ppatlux/customizer-as-website/assets/models/special/Otto5/1677061-otto-5-tpuflex-track-and-belt-8fd95c79-441a-4261-949b-67ce57e5056e.pdf

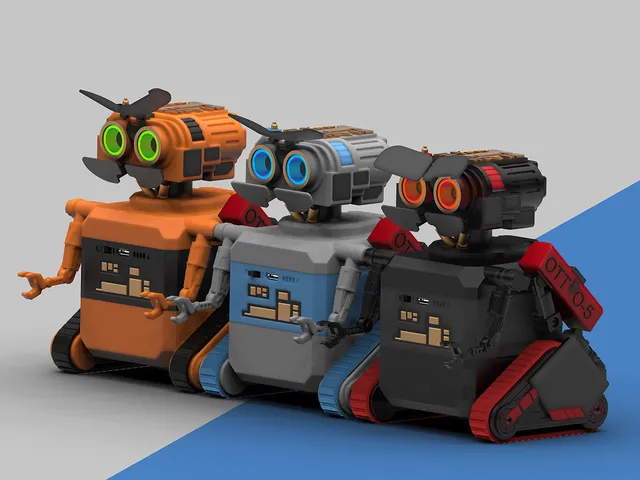
[picture p6: figure]

0.93 hrs

1 pcs

f

0.20 mm

k

0.40 mm

h

Flex

9 g

d

Prusa CORE
One / +

## Summary

TPU/Flex track and belt as an alternative for the current o-ring design.

Hobby & Makers (https://printables.com/model?categoryId=48) > RC & Robotics (https://printables.com/model?categoryId=64)

Tags: | otto | ottodiy | ottorobot | robot | robotics

OTTO-5 TPU / Flexible Track and belt

I received a request for an alternative to the o-ring design, so here’s a TPU/flexible track and belt designed for the OTTO-5. This track is compatible with the standard OTTO-5 wheels and mounting hardware, and it uses the same parts as the original o-rings.

I would have updated the current design, but that doesn’t seem possible. Likely because it’s part of a closed contest. The OTTO-5 design will be updated as soon as possible.

Since I don’t have the capability to print TPU/Flex materials myself, this design has not been tested. Minor adjustments may be required

AK_designs (https://printables.com/@AK_designs_4494554)

## OTTO-5 TPU/Flex track and belt

VIEW IN BROWSER (https://printables.com/model/1677061-otto-5-tpuflex-track-and-belt)

updated 10. 4. 2026 | published 10. 4. 2026

## Model files

depending on your printer and the specific TPU or flexible filament you use.

The track is designed with approximately 3.8% elongation to ensure it stays in place. However, because it hasn’t been tested and I have limited experience with flexible 3D printing materials, I cannot guarantee that this is optimal. Please feel free to comment if the track should be tighter or looser for best performance.

Recommended print settings (general guideline for TPU/flex):

Nozzle temperature: 210–230 °C
Bed temperature: 50–60 °C
Print speed: 20–30 mm/s
Layer height: 0.2 mm
Infill: 20–30% (gyroid)

Installation tip: Stretch the track slightly during installation to fit snugly on the wheels.

Link to the OTTO-5 model:

Thank You / Enjoy Printing!

•
•
•
•
•

bot_track_tpu.3mf

top_head_pully_tpu_belt.3mf

bot_track_tpu.stl

top_head_pully_tpu_belt.stl

## Print files

h Flex k 0.40 mm f 0.20 mm 0.93 hrs 9 g d Prusa CORE One / +

- Example gcode for reference

## License

This work is licensed under a
Creative Commons (4.0 International License)

Attribution—Noncommercial—Share Alike (http://creativecommons.org/licenses/by-nc-sa/4.0/)

✖ | Sharing without ATTRIBUTION
✔ | Remix Culture allowed
✖ | Commercial Use
✖ | Free Cultural Works
✖ | Meets Open Definition

bot_track_tpu_flex_example_coreone.bgcode
