ppatlux/customizer-as-website/assets/models/special/OttoButter/1662333-otto-pass-the-butter-robot-04062c3c-220f-47a0-8fba-3715a1c23a67.pdf

## Otto Pass the Butter Robot

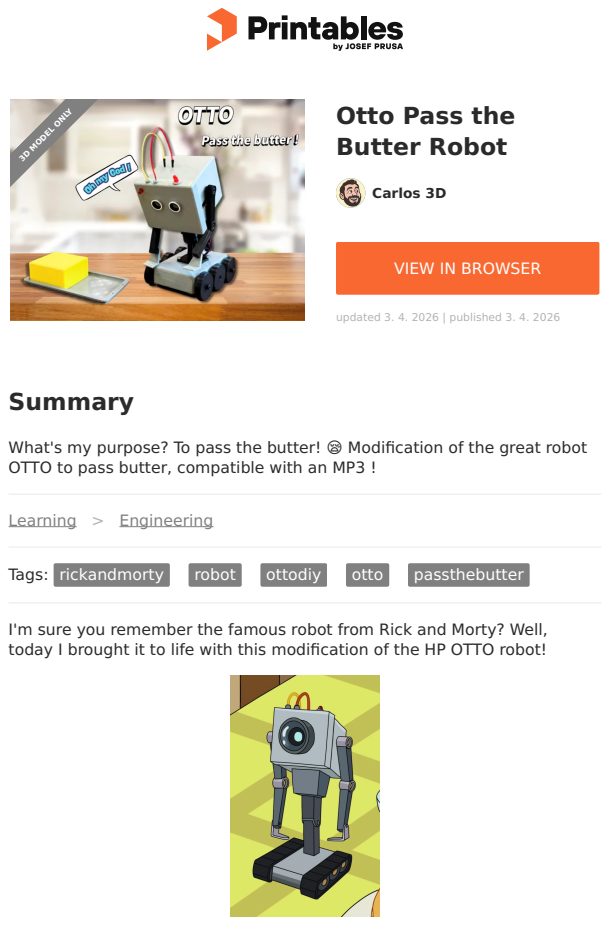
[picture p7: page 1]
Summary; Learning > Engineering; Tags:; rickandmorty; robot; ottodiy; otto; passthebutter; Carlos 3D; updated 3. 4. 2026 | published 3. 4. 2026; 3D MODEL ONLY

VIEW IN BROWSER (https://printables.com/model/1662333-otto-pass-the-butter-robot)

What's my purpose? To pass the butter! 😪 Modification of the great robot
OTTO to pass butter, compatible with an MP3 !

I'm sure you remember the famous robot from Rick and Morty? Well,
today I brought it to life with this modification of the HP OTTO robot!

## Model files

It's easy to assemble, and I've included the code so you can build it yourself, I'm sure you can do a much better job 😅

This is an excellent starting point for further modifications, so I've also included the STEP file!

Have fun with this mod!

Watch the Video
https://www.instagram.com/p/DWpK_EwDpc0/

Necessary Hardware

M3 Hex Screws (some 5 and 8mm long)
M4 Hex Screws (8, 10 and 12mm should work)
4x M4 Brake nuts (to block the wheels)
The rest comes already with the OTTO kit !
Ahh and maybe some wires or PLA to simulate the Robot cables

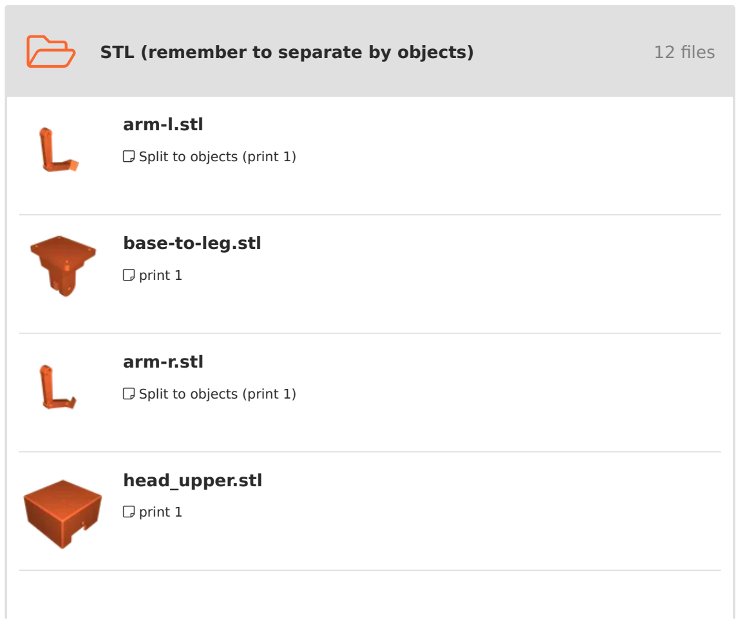
[picture p8: figure]
Split to objects (print 1); print 1; arm-l.stl; base-to-leg.stl; arm-r.stl; head_upper.stl

- STL (remember to separate by objects) | 12 files

•
•
•
•
•

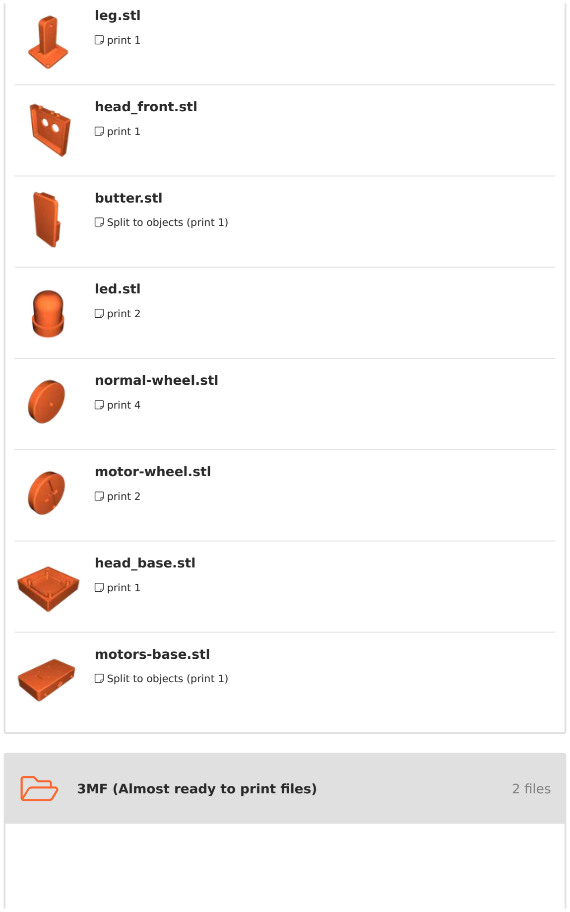
[picture p9: figure]
print 1; Split to objects (print 1); print 2; print 4; leg.stl; head_front.stl; butter.stl; led.stl; normal-wheel.stl; motor-wheel.stl; head_base.stl; motors-base.stl

- 3MF (Almost ready to print files) | 2 files

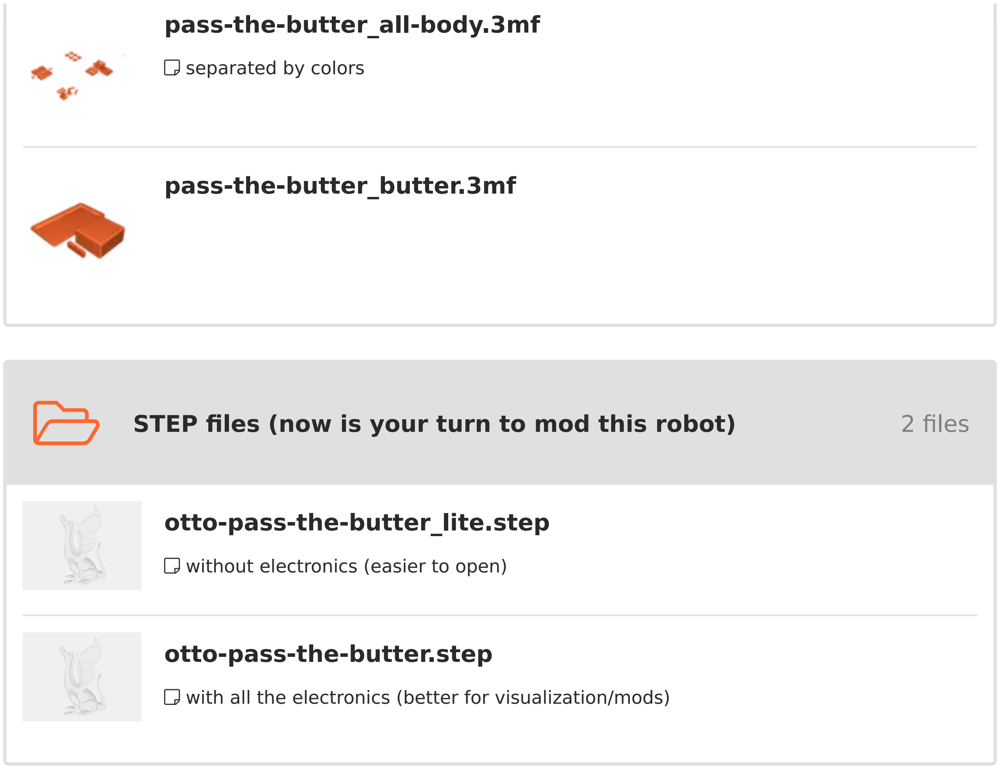
[picture p10: figure]
separated by colors; without electronics (easier to open); pass-the-butter_all-body.3mf; pass-the-butter_butter.3mf; otto-pass-the-butter_lite.step; otto-pass-the-butter.step

- STEP files (now is your turn to mod this robot) | 2 files
- with all the electronics (better for visualization/mods)

## License

This work is licensed under a
Creative Commons (4.0 International License)

Attribution—Noncommercial—Share Alike (http://creativecommons.org/licenses/by-nc-sa/4.0/)

✖ | Sharing without ATTRIBUTION
✔ | Remix Culture allowed
✖ | Commercial Use
✖ | Free Cultural Works
✖ | Meets Open Definition
