ppatlux/customizer-as-website/assets/models/special/OttoBuzz/1617566-hp-otto-otto-bus-30bd9cd0-71e3-439a-a64b-bc296953116d.pdf

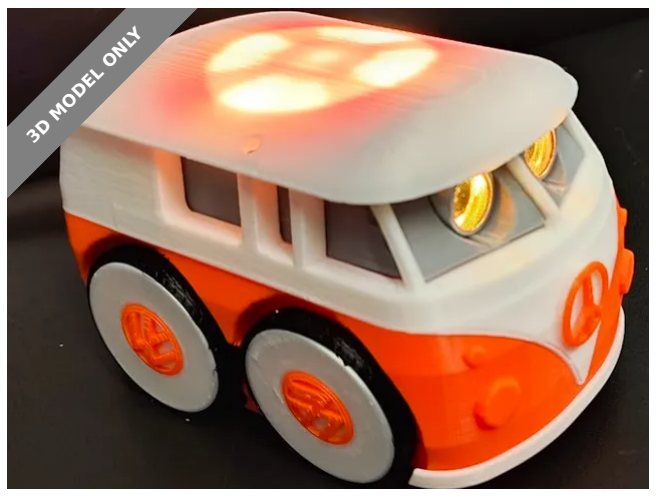
[picture p11: figure]
3D MODEL ONLY

## Summary

A new VW Splitscreen Bus body for HP Otto

Hobby & Makers (https://printables.com/model?categoryId=48) > RC & Robotics (https://printables.com/model?categoryId=64)

HP Otto: Otto Bus

Otto Bus uses all the components found in the HP Robots | Otto Starter -
Creator Kit (https://shop.moravia.education/educational-and-interactive-robots/hp-robots/hp-robots-otto-creator-kit.html) to build a complete Otto-based robot. It can also be used as an
alternative body for the HP Robots | Otto Starter Santa Edition (https://shop.moravia.education/educational-and-interactive-robots/hp-robots/hp-robots-otto-starter-santa-edice.html) and the HP
Robots | Otto Starter - Builder Kit. (https://shop.moravia.education/educational-and-interactive-robots/hp-robots/otto-starter-builder-kit.html)

Printing

PLA, 15% infil. This model can be printed without supports but there are a few places on the 'upper body' where supports will improve the final result. I used 1mm diameter painted on 'organic' supports in the areas indicated (blue spots).

Alex Just Alex (https://printables.com/@AlexJustAlex_476452)

## HP Otto: Otto Bus

VIEW IN BROWSER (https://printables.com/model/1617566-hp-otto-otto-bus)

updated 11. 3. 2026 | published 11. 3. 2026

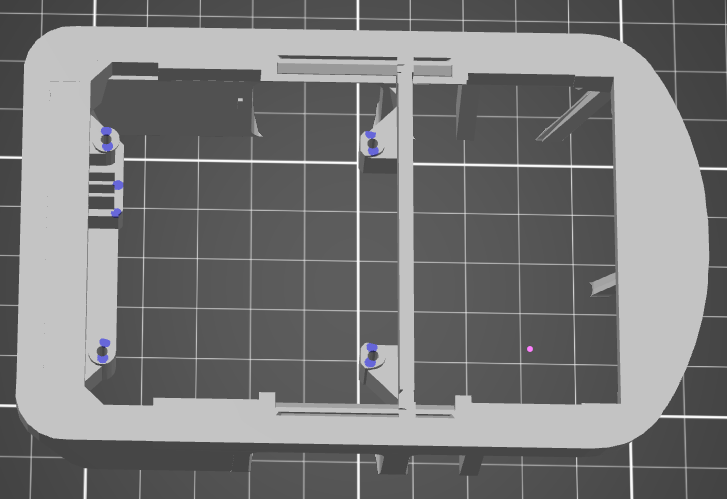
[picture p12: figure]

Tyres are printed with TPU or, alternatively, ~40mm id O-rings can be used.

Assmbly

Note: Most of the assembly is very similar to the assembly detailed in the manual supplied with the starter kit and this manual should be referred to when assembling the Otto Bus

Mount the line sensors in the base and secure with self tapping screws.

1.

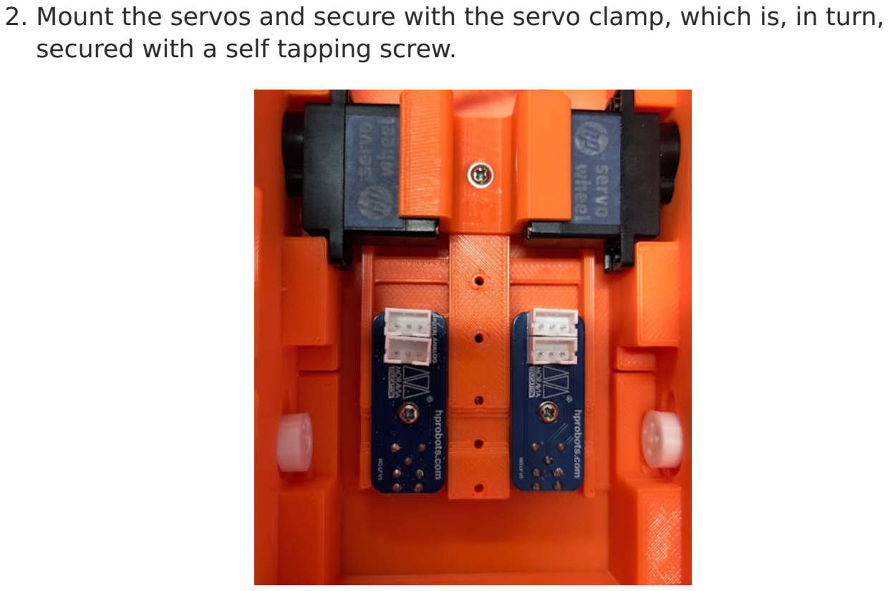
[picture p13: page 3]

Mount the servos and secure with the servo clamp, which is, in turn, secured with a self tapping screw.

2.

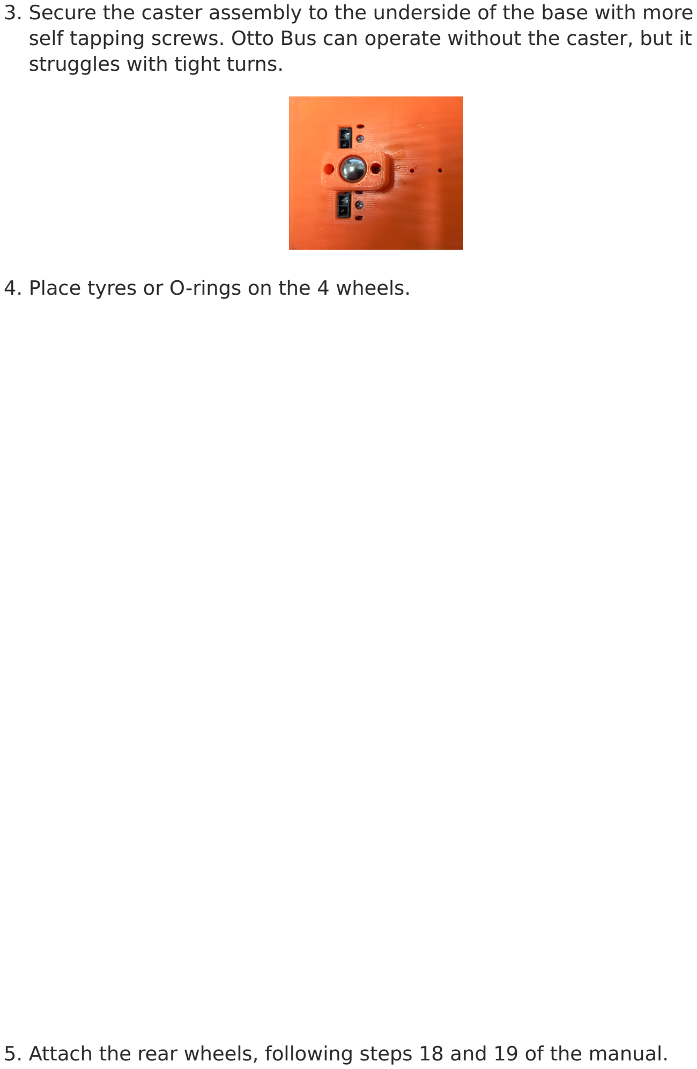
[picture p14: page 4]

Secure the caster assembly to the underside of the base with more self tapping screws. Otto Bus can operate without the caster, but it struggles with tight turns.

Place tyres or O-rings on the 4 wheels.

Attach the rear wheels, following steps 18 and 19 of the manual.

3.

4.

5.

For the front wheels, pass the hub through the base, slip on the washer and then push fit the front wheel on to the hub. Secure this with a small self tapping screw such as the ones supplied with servo horns.

6.

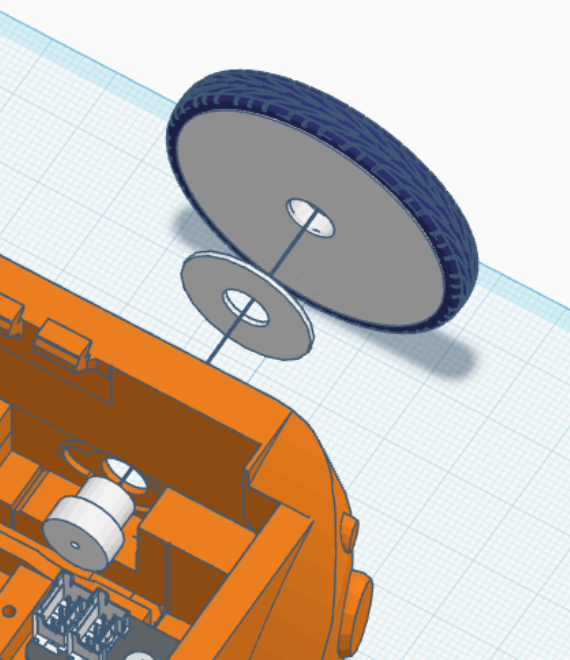
[picture p15: figure]

Assemble the 'inner module' following steps 8 to 10 of the HP Robots starter manual and secure the module inside the upper body section

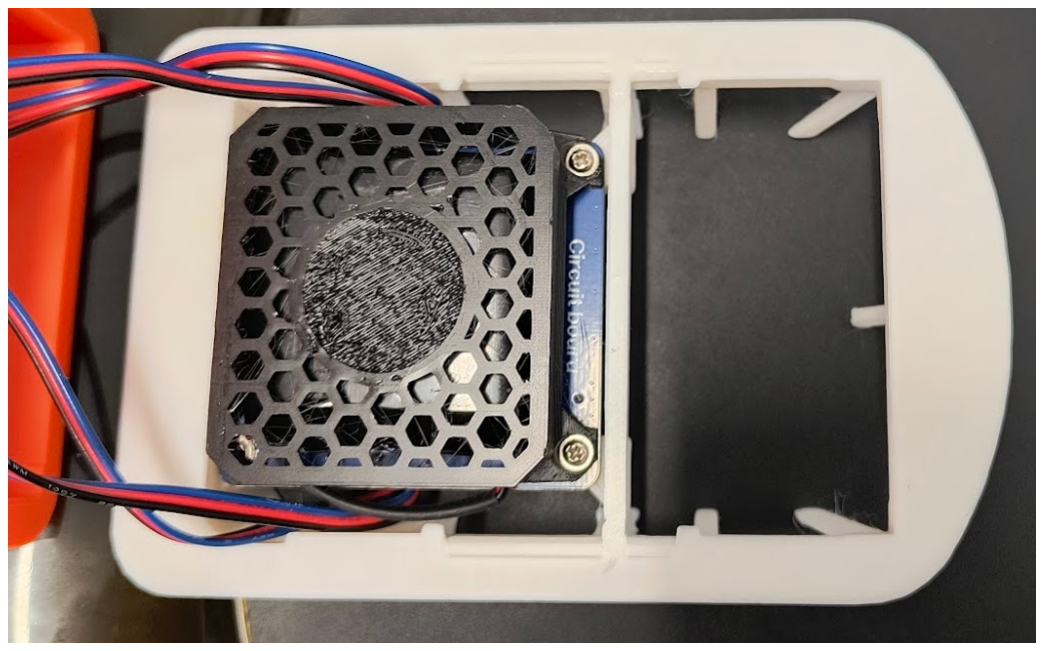
[picture p16: figure]

The base and upper body can now be combined, by clipping them together. First place the front piece in position on the base and then clip on the upper section which secures the front piece in place.
Make sure to feed all the wires from the base up the sides of the upper body section so that they can be attached to the control board.

7.

8.

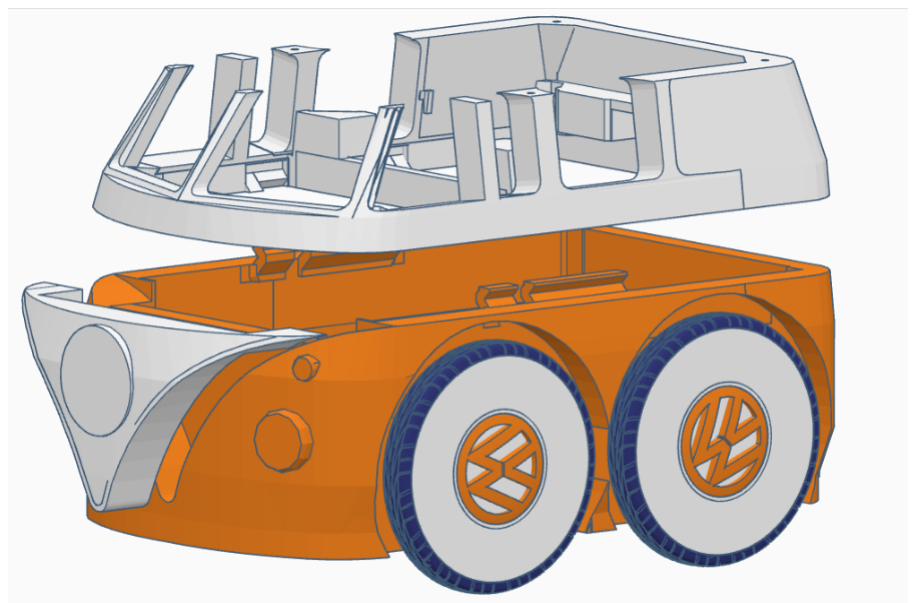
[picture p17: figure]
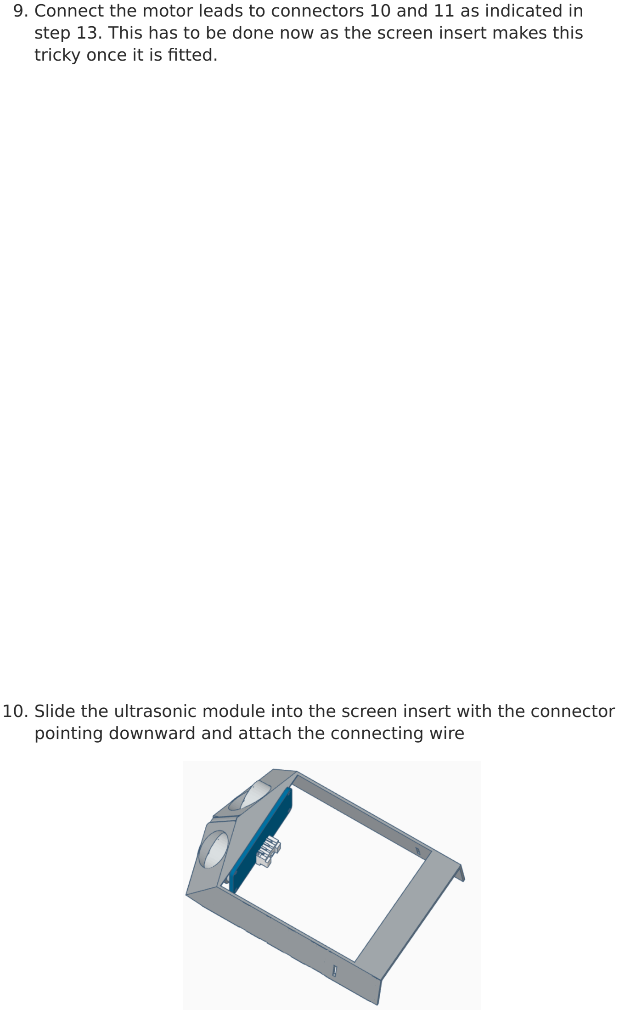
[picture p18: page 7]

Connect the motor leads to connectors 10 and 11 as indicated in
step 13. This has to be done now as the screen insert makes this tricky once it is fitted.

Slide the ultrasonic module into the screen insert with the connector pointing downward and attach the connecting wire

9.

10.

Position the insert inside the upper body section, you will need to squeeze the sides together to do this.

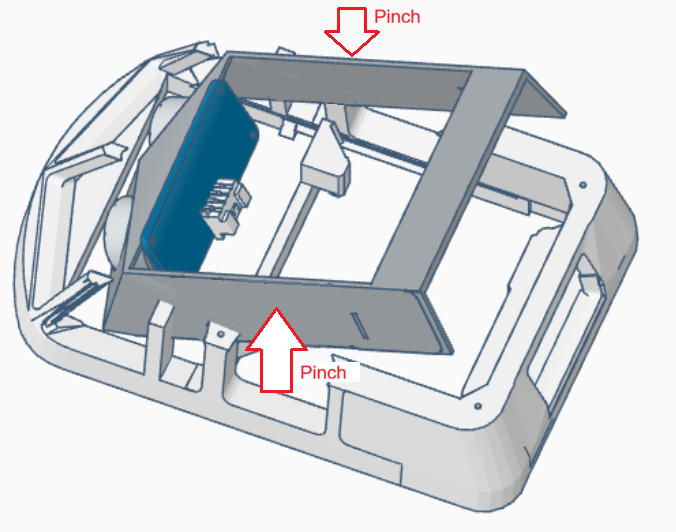
[picture p19: figure]

Mount the LED ring on the roof with the connecto to the front using 4 self tapping screws.

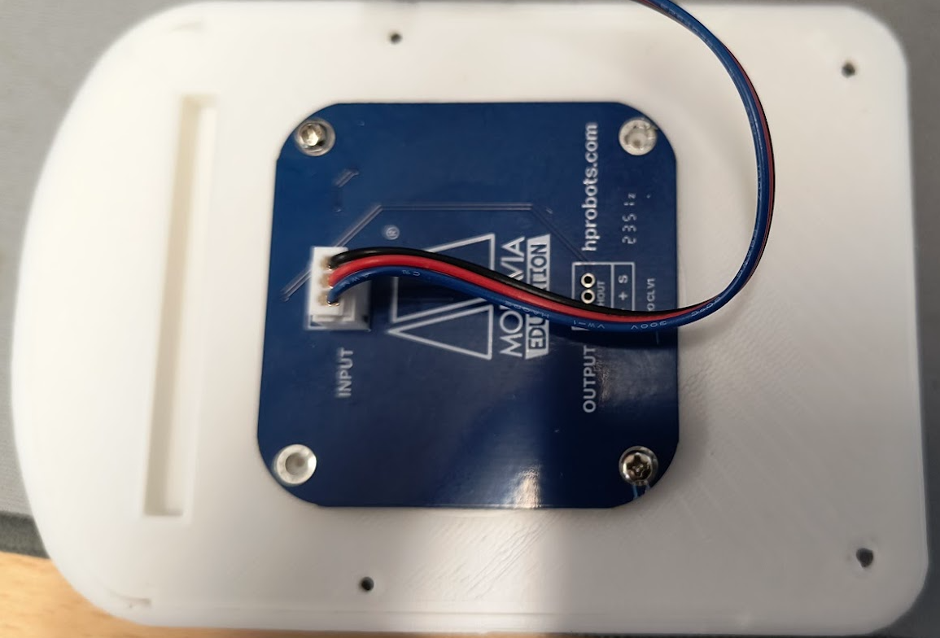
[picture p20: figure]

It's now time to make the rest of the electrical connections. These can be found on page 3 of the manual.

11.

12.

13.

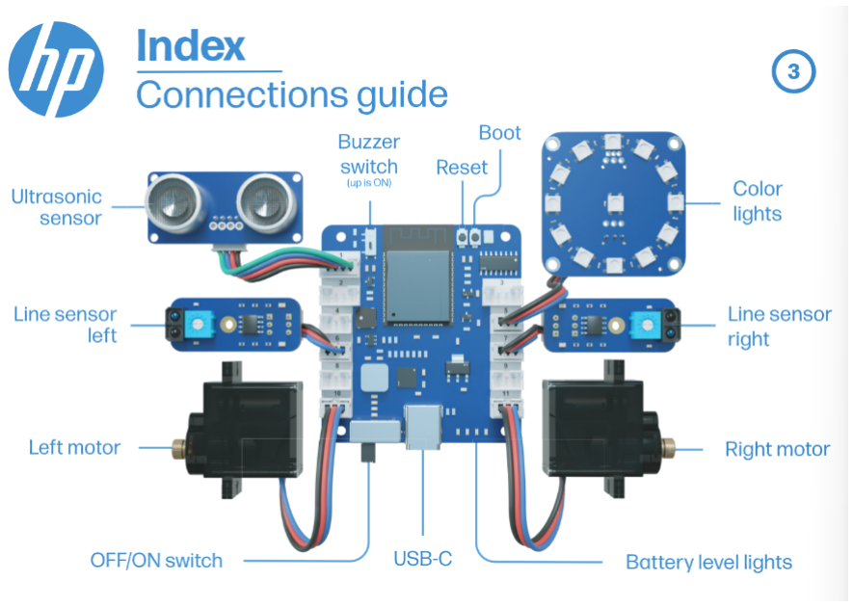
[picture p21: figure]

(image used with permission)

14. Now attach the roof with four more screws.

15. Attach the logo of your choice to the front with a drop of superglue.

The logo 'hub caps' can also be attached. Depending on your printer the logos may clip in place or may require a dab of glue. I
recommend a glue stick like Pritt for this so that they can be easily removed again if required.

16.

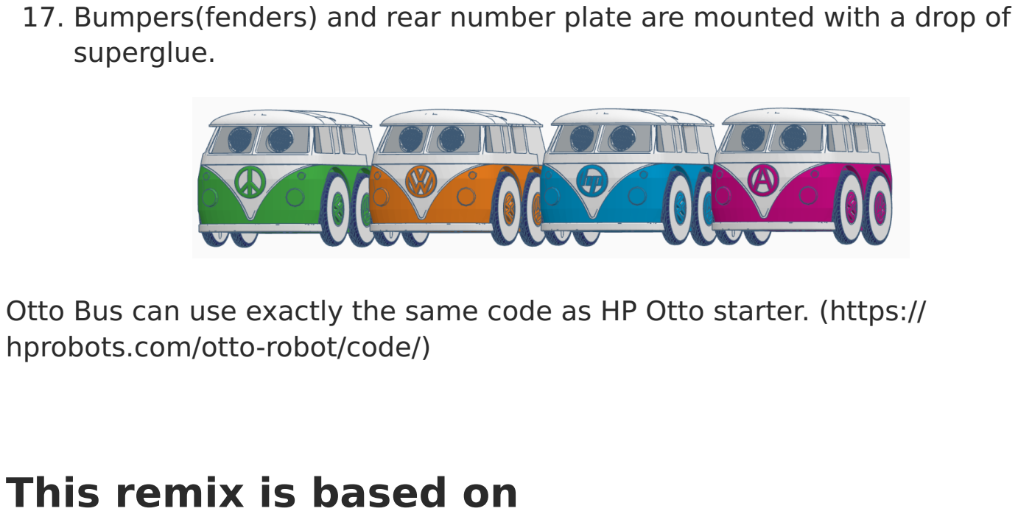
[picture p22: page 13]

Bumpers(fenders) and rear number plate are mounted with a drop of superglue.

Otto Bus can use exactly the same code as HP Otto starter. (https://hprobots.com/otto-robot/code/)

## This remix is based on

17.

## Model files

HP Robots | Otto Starter (https://printables.com/model/829419-hp-robots-otto-starter)
by HP Robots Otto (https://printables.com/@hprobots)

VW Bus Marker or Tool Holder with Working Wheels (optimized for Prusa Mini) (https://printables.com/model/404012-vw-bus-marker-or-tool-holder-with-working-wheels-o)
by Den (https://printables.com/@Den_484447)

otto-dub-base.stl

otto-dub-front.stl

otto-dub-upper-body.stl

otto-dub-screen.stl

otto-dub-roof.stl

otto-dub-rear-wheel.stl

- with cutaway to go over screwheads
- Atkinson or Anarchy

otto-dub-front-wheel.stl

otto-dub-front-wheel-hub.stl

otto-dub-front-wheel-washer.stl

otto-dub-vw-logo.stl

otto-dub-vw-hubcap.stl

otto-dub-hp-logo.stl

otto-dub-peace-logo.stl

otto-dub-aja-logo.stl

otto-dub-atkinson-logo.stl

otto-dub-front-bumper.stl

## License

This work is licensed under a
Creative Commons (4.0 International License)

Attribution—Noncommercial—Share Alike (http://creativecommons.org/licenses/by-nc-sa/4.0/)

✖ | Sharing without ATTRIBUTION
✔ | Remix Culture allowed
✖ | Commercial Use
✖ | Free Cultural Works
✖ | Meets Open Definition

otto-dub-rear-bumper.stl

otto-dub-rear-plate.stl
