ppatlux/customizer-as-website/assets/models/special/OttoD2/1595229-hp-otto-otto-d2-3d70b2a9-ba4c-4e04-8e0a-4731c8bd536c.pdf

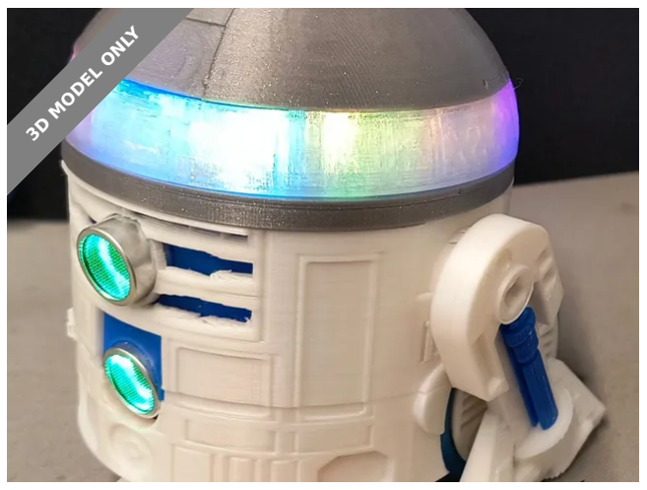
[picture p23: figure]
3D MODEL ONLY

## Summary

An R2D2 inspired body for the HP Otto Starter kit.

Hobby & Makers (https://printables.com/model?categoryId=48) > RC & Robotics (https://printables.com/model?categoryId=64)

Otto-D2

An R2D2 inspired body for the HP Otto Starter kit.

Otto-D2 uses all the components found in the HP Robots | Otto Starter -
Creator Kit (https://shop.moravia.education/educational-and-interactive-robots/hp-robots/hp-robots-otto-creator-kit.html) to build a complete Otto-based robot. It can also be used as an
alternative body for the HP Robots | Otto Starter Santa Edition (https://shop.moravia.education/educational-and-interactive-robots/hp-robots/hp-robots-otto-starter-santa-edice.html) and the HP
Robots | Otto Starter - Builder Kit. (https://shop.moravia.education/educational-and-interactive-robots/hp-robots/otto-starter-builder-kit.html)

Printing

PLA, 15% infill, no supports. The middle section of the dome is transparent PLA to allow the LEDs to shine through. I used white for the body and silver for the rest of the dome. Various blue inserts give Otto-D2 a bit more colour.

Alex Just Alex (https://printables.com/@AlexJustAlex_476452)

## HP Otto: Otto-D2

VIEW IN BROWSER (https://printables.com/model/1595229-hp-otto-otto-d2)

updated 10. 3. 2026 | published 10. 3. 2026

Assembly

Note: Most of the assembly is very similar to the assembly detailed in the manual supplied with the starter kit and this manual should be referred to when assembling Otto-D2

Mount the line sensors in the base and secure with self tapping screws.

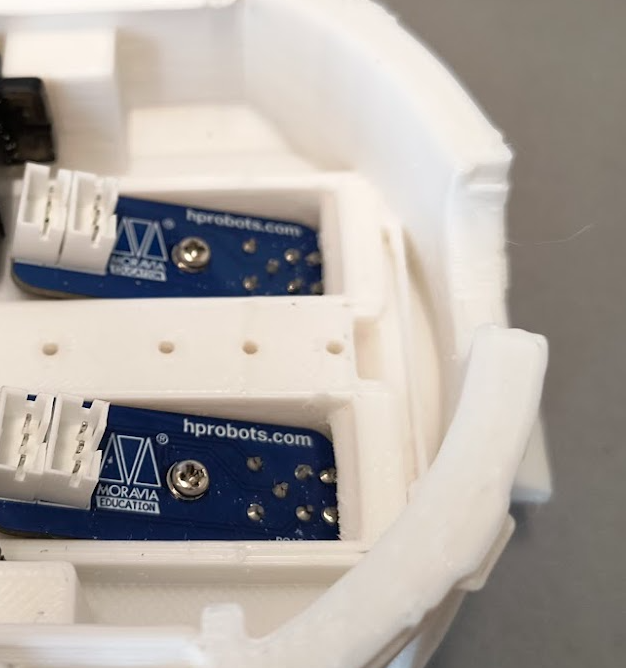
[picture p24: figure]

Mount the servos and secure with the servo clamp, which is, in turn, secured with a self tapping screw.

1.

2.

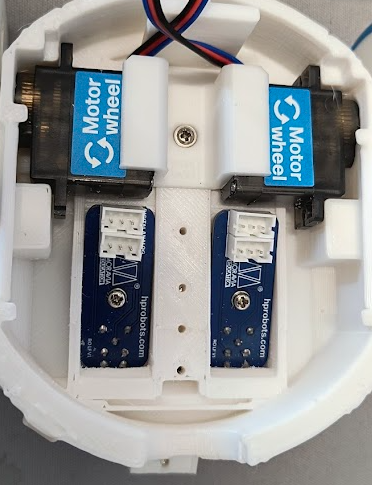
[picture p25: figure]

Secure the caster bracket and caster assembly to the underside of the base with more self tapping screws.

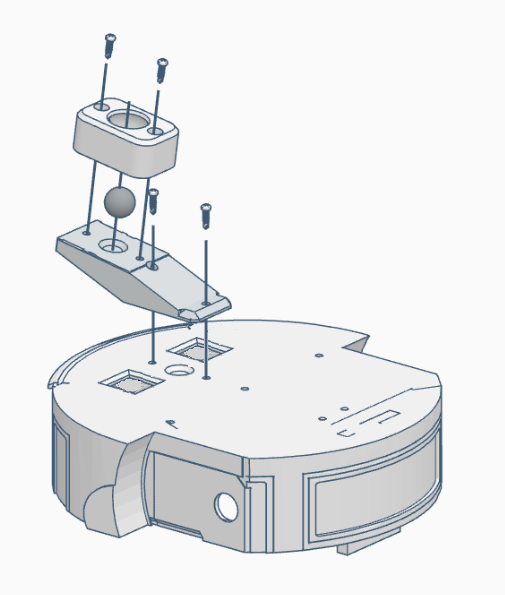
[picture p26: figure]

Slide the blue insert into the middle section.

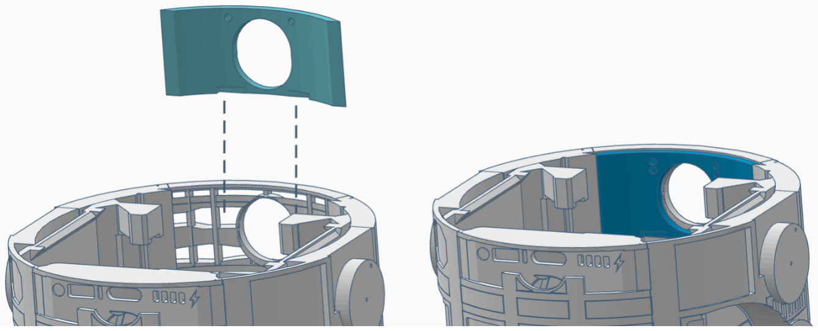
[picture p27: figure]

The print supports indicated can be optionally nipped out after printing.

3.

4.

5.

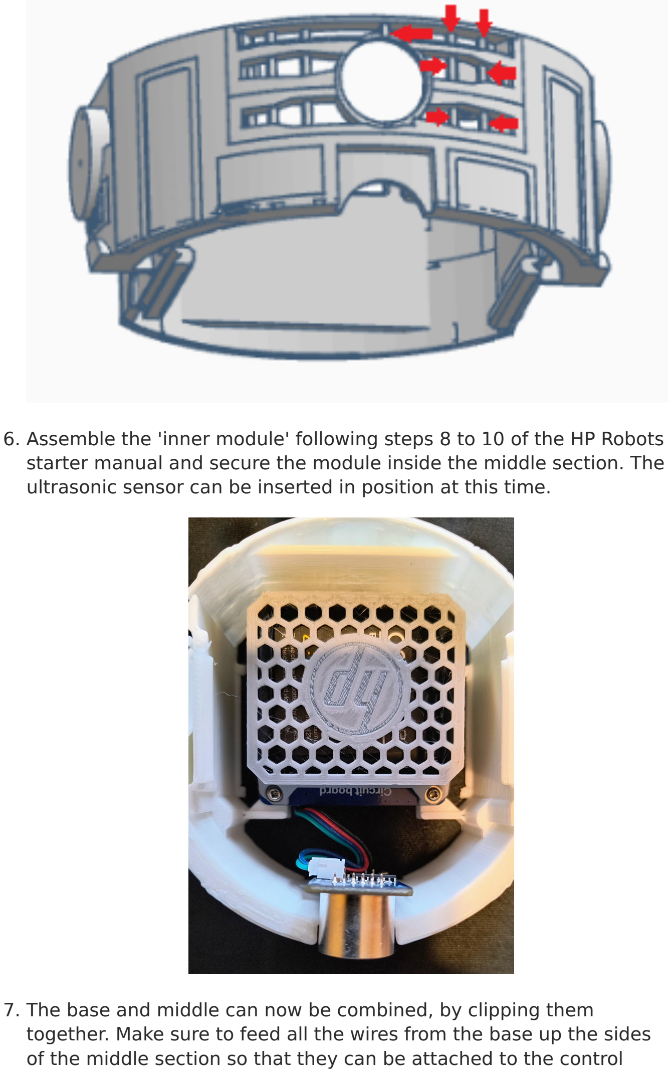
[picture p28: page 4]

Assemble the 'inner module' following steps 8 to 10 of the HP Robots starter manual and secure the module inside the middle section. The ultrasonic sensor can be inserted in position at this time.

The base and middle can now be combined, by clipping them together. Make sure to feed all the wires from the base up the sides of the middle section so that they can be attached to the control

6.

7.

board. Use the spacer to ensure that the ultrasonic sensor is positioned at the correct angle.

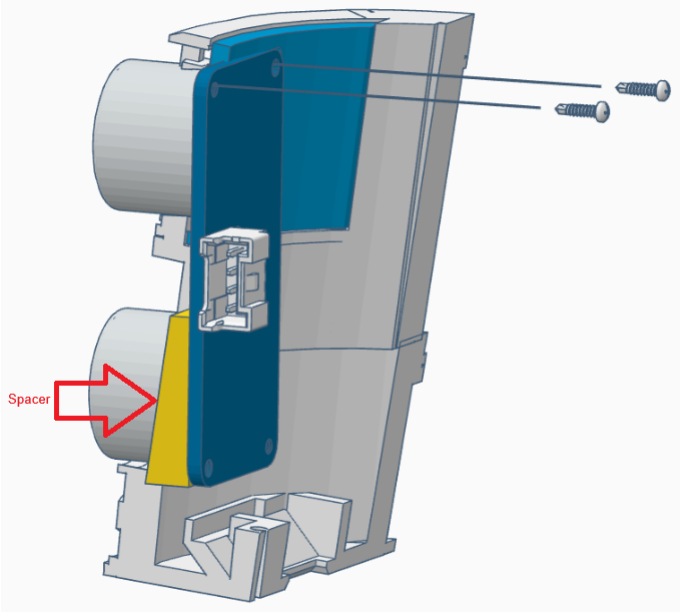
[picture p29: figure]

8. Attach the wheels, following steps 18 and 19 of the manual.

Assemble the legs by attaching the blue part with a drop of superglue.

9.

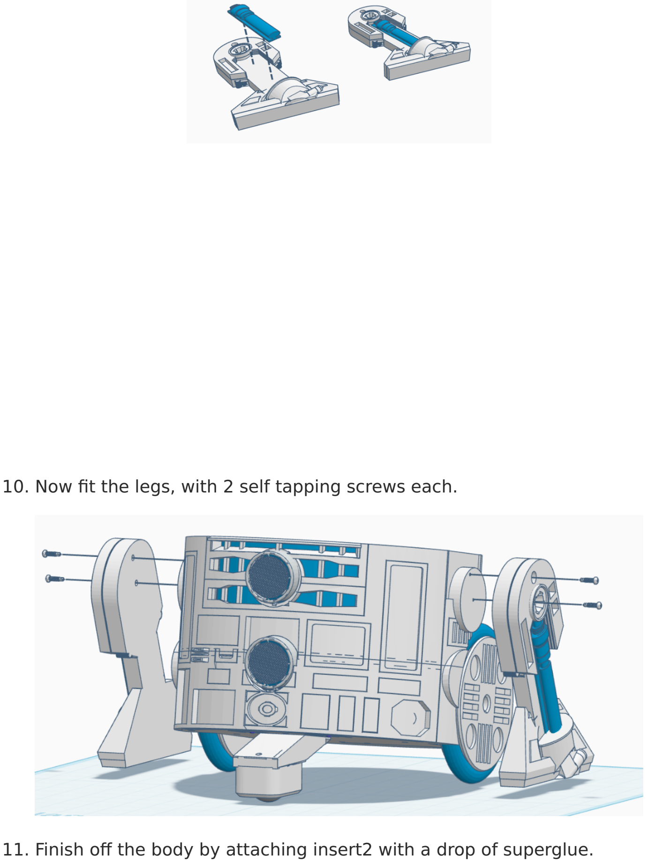
[picture p30: page 7]

Now fit the legs, with 2 self tapping screws each.

Finish off the body by attaching insert2 with a drop of superglue.

10.

11.

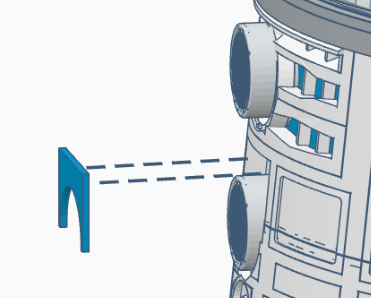
[picture p31: figure]

Now we come to assembly of the dome. This is made of 3 components which will be screwed together with, you guessed it, more self tapping screws. First the LED ring needs to be fitted. Take the dome base with the mounting clips facing down. Identify the front by looking for where the front section of the clip is cut away (see my helpful picture below). Attach the led ring on top of the dome base, with the connector facing down at the front.

12.

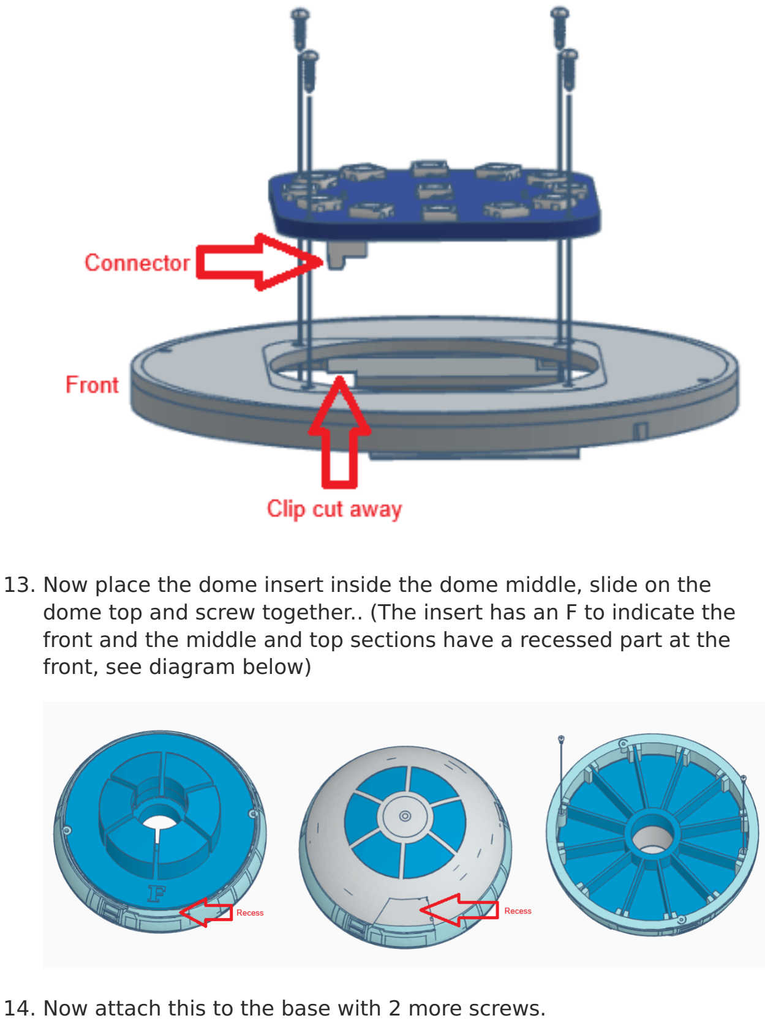
[picture p32: page 9]

Now place the dome insert inside the dome middle, slide on the dome top and screw together.. (The insert has an F to indicate the front and the middle and top sections have a recessed part at the front, see diagram below)

Now attach this to the base with 2 more screws.

13.

14.

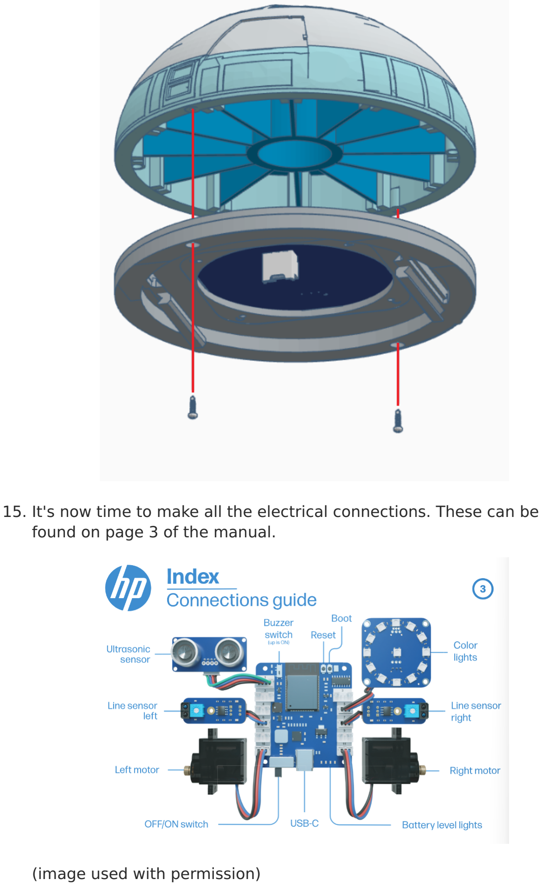
[picture p33: page 10]

It's now time to make all the electrical connections. These can be found on page 3 of the manual.

(image used with permission)

15.

16. Now clip the dome on to the body and you're done!

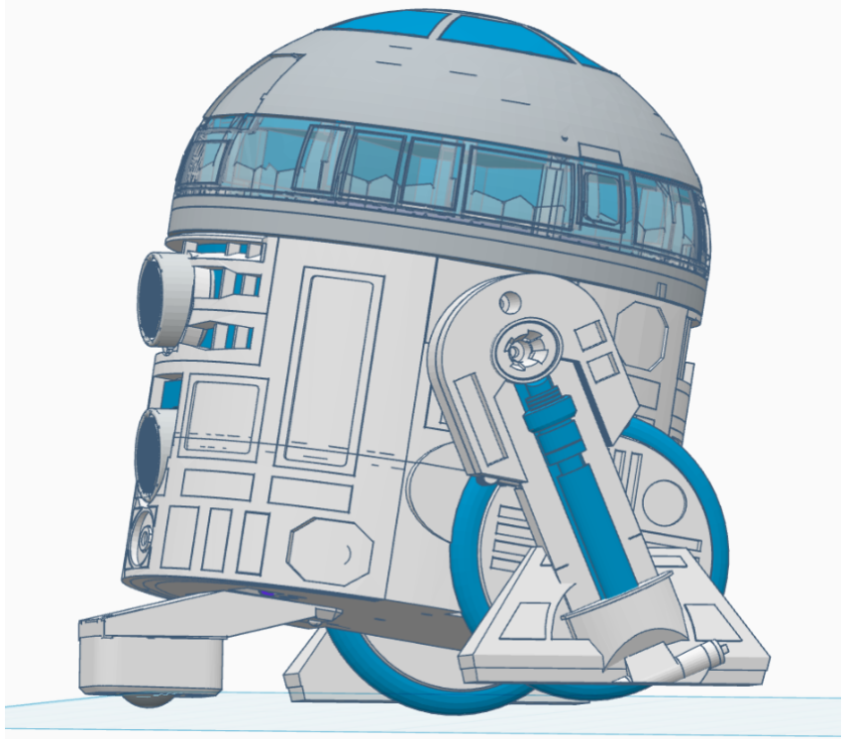
[picture p34: figure]

Otto-D2 can use exactly the same code as HP Otto starter. (https://hprobots.com/otto-robot/code/)

## This remix is based on

HP Robots | Otto Starter (https://printables.com/model/829419-hp-robots-otto-starter)
by HP Robots Otto (https://printables.com/@hprobots)

R2D2
by lubosh (https://www.thingiverse.com/thing:2139345)

## Model files

- 2 choices from HP for the caster - take your pick!
- 2 choices from HP for the caster - take your pick!
- (hp_starter_bracket_s_r1)
- Print 2

otto-d2-base.stl

otto-d2-caster-bracket.stl

hp_starter_caster_s_r1.stl

hp_santa_caster_b_r2.stl

servo-clamp.stl

otto-d2-middle.stl

otto-d2-middle-blue-insert.stl

hp_starter_covermesh_b_r1.stl

otto-d2-wheels.stl

- Print Two
- transparent

otto-d2-left-leg.stl

otto-d2-right-leg.stl

otto-d2-legs-blue-section.stl

otto-d2-ultrasonic-spacer.stl

otto-d2-middle-blue-insert-2.stl

otto-d2-dome-base.stl

otto-d2-dome-blue-insert.stl

otto-d2-dome-top.stl

otto-d2-dome-middle.stl

## License

This work is licensed under a
Creative Commons (4.0 International License)

Attribution—Noncommercial—Share Alike (http://creativecommons.org/licenses/by-nc-sa/4.0/)

✖ | Sharing without ATTRIBUTION
✔ | Remix Culture allowed
✖ | Commercial Use
✖ | Free Cultural Works
✖ | Meets Open Definition
