ppatlux/customizer-as-website/assets/models/special/OttoJr/1667283-otto-jr-a17f32dc-c0b8-4437-97b0-9b36591161a5.pdf

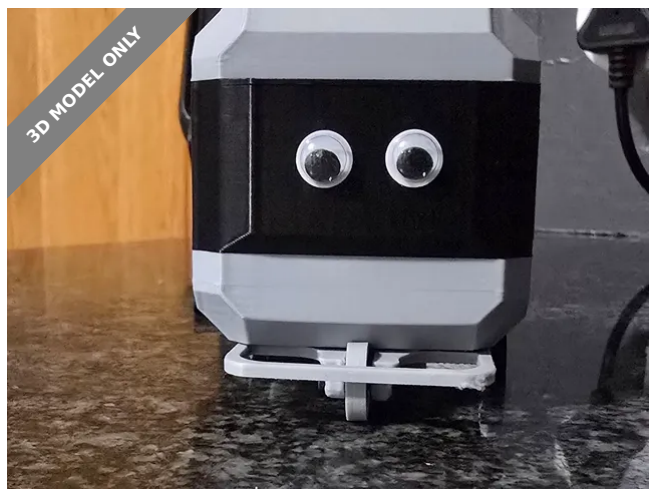
[picture p46: figure]
3D MODEL ONLY

## Summary

A micro version of Microsoft's Otto Robot. Easy to print, code and make with my guide. WIFI controllable up to 30m

Hobby & Makers (https://printables.com/model?categoryId=48) > RC & Robotics (https://printables.com/model?categoryId=64)

Tags: | robot | diy | wifi | children | kids | fun | school
gadgets | easy | electronics | controller | esp32 | robotics
remote | diyelectronics | controlled | otto | espressif | esp32c3
esp32c3supermini | micorsoft | mx1508 | microrobotics

This project uses minimal materials and was made from mainly spare materials which I have access to. It was inspired by Microsoft's Otto robot which inspired me to create my own micro-version over the past few days.

Parts List:
-ESP32 C3
-MX1508 Motor driver
-MT3608 DC -DC converter
-FR107 Diode
-1000 μF Capacitor
-LED
-20mA Resistor

Extrude Labs (https://printables.com/@ExtrudeLabs_521578)

Otto Jr.

VIEW IN BROWSER (https://printables.com/model/1667283-otto-jr)

updated 4. 4. 2026 | published 4. 4. 2026

## Model files

-Battery Connector (Male and Female) -2x 612 DC Brushed Motors (3v)
-12mm Shrink Tubing
-Enameled Wire
-2x 550mAh Lithium Batteries (I took mine out of recycled vapes) -Multipurpose lithium Ion Battery Charger (Or TP4056)

The wire diagram is slightly complicated but I will included it, alone with the most recent code that I created. The car can be controlled on the phone, or computer. Simply connect the battery, connect to the broadcasted wifi network, search "192.168.4.1" on the browser, and the controls will display. Refer to the images included. Please like, comment, and share!

wheel.3mf

3-wheel-pcb-clip.3mf

free-wheel.3mf

3-wheel-chasis.3mf

otto.3mf

## License

This work is licensed under a
Creative Commons (4.0 International License)

Attribution-ShareAlike (http://creativecommons.org/licenses/by-sa/4.0/)

✖ | Sharing without ATTRIBUTION
✔ | Remix Culture allowed
✔ | Commercial Use
✔ | Free Cultural Works
✔ | Meets Open Definition
