ppatlux/customizer-as-website/assets/models/special/OttoSwim/1628816-hp-otto-swimmer-kit-fully-compatible-with-basic-robot-model-7cfaf209-fa9b-46a7-8df8-188c11923966.pdf

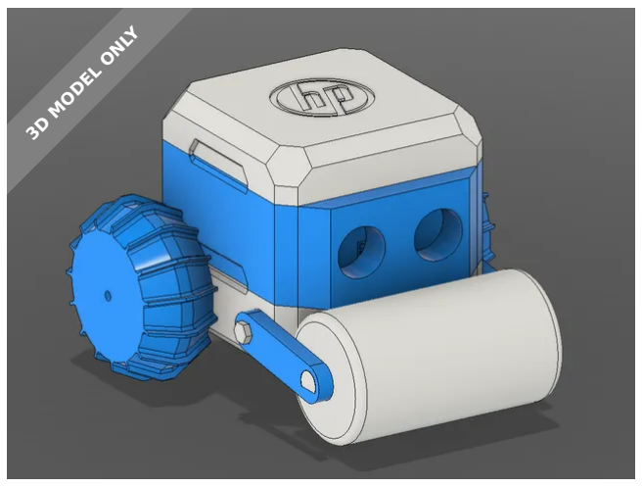
[picture p47: figure]
3D MODEL ONLY

## Summary

This model is improvement for HP OTTO robot. This 7 additional part makes otto capable of swimming in water.

Hobby & Makers (https://printables.com/model?categoryId=48) > RC & Robotics (https://printables.com/model?categoryId=64)

Tags: | swim | robot | floating | robotics | learning | simple
hp | otto

This is a remake add-on for the HP OTTO robot that allows it to float and move in water .

By printing and attaching the included shell float parts, the robot gains enough buoyancy to swim in calm water (not recommended for strong waves). The floating parts are designed to be fully compatible with the original HP OTTO chassis, so no modifications to the main body are required.

⚙ How it works
The design adds a floating barrel and protective shells that help the robot stay on the water surface while the wheels provide movement.

nodar maisuradze (https://printables.com/@nodarmaisura_1742893)

## HP OTTO swimmer kit fully compatible with basic robot model

VIEW IN BROWSER (https://printables.com/model/1628816-hp-otto-swimmer-kit-fully-compatible-with-basic-ro)

updated 7. 3. 2026 | published 7. 3. 2026

## Model files

Assembly
Assembly is quick and simple:

Replace the original wheels with the provided ones. Attach the front legs that hold the floating barrel. Replace line follower sensors with plugs.

And that’s it — your robot is ready for the water!

⚠ Note
The line-following sensors cannot be used in this configuration. Instead, you must insert the included plugs into the sensor openings.

All required parts for the floating system and the sensor plugs are included in the files.

- 2x
- 2x
- 1x
- 2x
- 1x

1.
2.
3.

inside-clip.stl

swimming-wheel.stl

front-floater.stl

leg.stl

spin-rod.stl

- 1x
- 2x

## License

This work is licensed under a
Creative Commons (4.0 International License)

Attribution—Noncommercial—Share Alike (http://creativecommons.org/licenses/by-nc-sa/4.0/)

✖ | Sharing without ATTRIBUTION
✔ | Remix Culture allowed
✖ | Commercial Use
✖ | Free Cultural Works
✖ | Meets Open Definition

spin-rod-clip.stl

plug.stl

swimmer-otto-full-print.3mf
