ppatlux/customizer-as-website/assets/models/special/OttoN/1651393-otton-an-otto-older-brother-1bad6d9c-9ce9-4948-9f9d-37b3586cb160.pdf

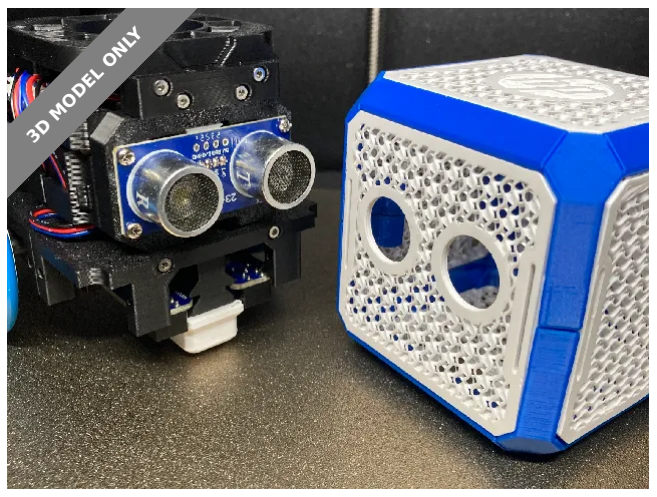
[picture p51: figure]
3D MODEL ONLY

## Summary

Complete Otto redesign made to appeal to older audiences

Hobby & Makers (https://printables.com/model?categoryId=48) > RC & Robotics (https://printables.com/model?categoryId=64)

Tags: | robot | robotics | servo | hp | otto

Assembly will require to use 26x M2 self tapping socket head screws OTTON Design Statement
Otto teaches a generation to code and build. OTTON is what happens when that generation grows up — same family, different chapter.

OTTON is a structural reinterpretation of Otto — not a reskin, but a ground-up rethink of how every part connects to every other part. The same way all machines around us are built. The silhouette is the same. The proportions are the same. The electronics are the same. What changes is the design language: from toy to machine.

Where Otto uses a closed shell clipped together around its components, OTTON separates structure from surface — an inner frame holds the electronics, an outer frame defines the body, and removable panels close it all in. Access to internals without disassembly. Panel replacement without touching the structure underneath. Full dimensional and electronic compatibility with the Otto platform is retained throughout.

3216.cad (https://printables.com/@3216cad_3307778)

## Otton - an Otto older brother

VIEW IN BROWSER (https://printables.com/model/1651393-otton-an-otto-older-brother)

updated 18. 4. 2026 | published 18. 4. 2026

## Model files

OTTO was always meant to outgrow itself. Otto started it. OTTON carries it forward.

## This remix is based on

HP Robots | Otto Starter (https://printables.com/model/829419-hp-robots-otto-starter)
by HP Robots Otto (https://printables.com/@hprobots)

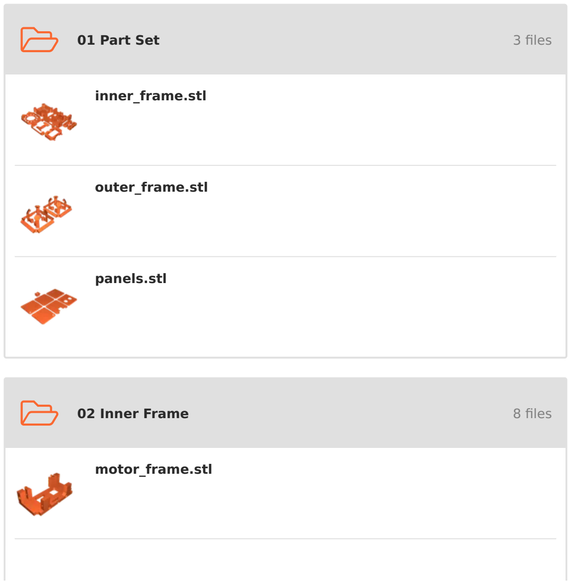
[picture p52: figure]
01 Part Set; 3 files; 02 Inner Frame; 8 files; inner_frame.stl; outer_frame.stl; panels.stl; motor_frame.stl

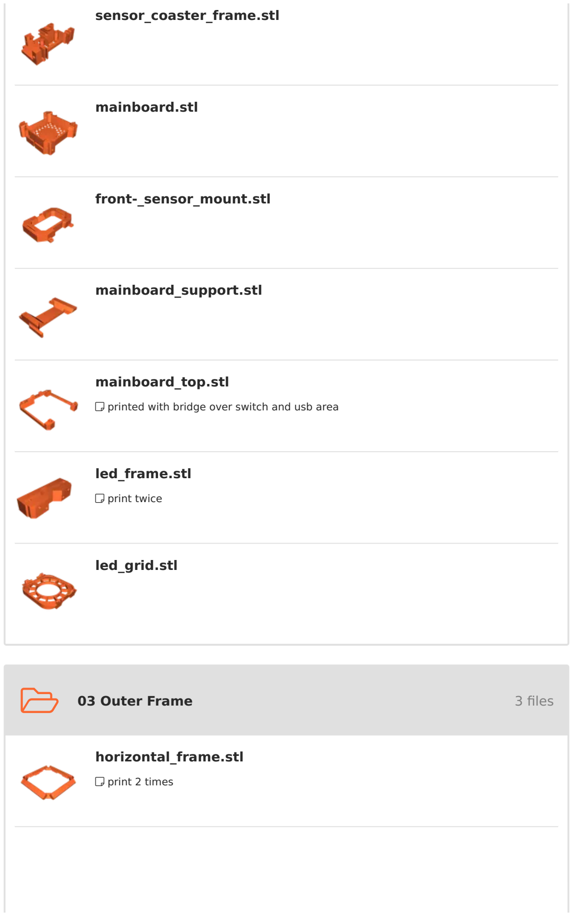
[picture p53: figure]
print twice; 03 Outer Frame; 3 files; print 2 times; sensor_coaster_frame.stl; mainboard.stl; front-_sensor_mount.stl; mainboard_support.stl; mainboard_top.stl; led_frame.stl; led_grid.stl; horizontal_frame.stl

- printed with bridge over switch and usb area

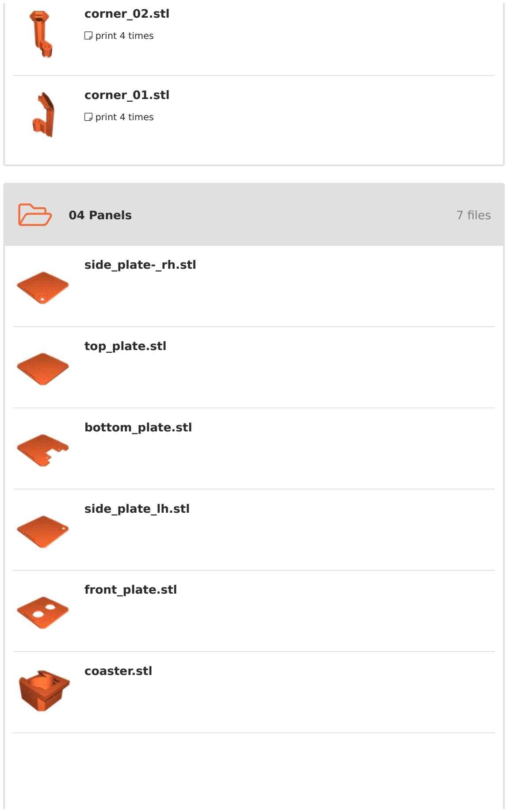
[picture p54: figure]
print 4 times; 04 Panels; 7 files; corner_02.stl; corner_01.stl; side_plate-_rh.stl; top_plate.stl; bottom_plate.stl; side_plate_lh.stl; front_plate.stl; coaster.stl

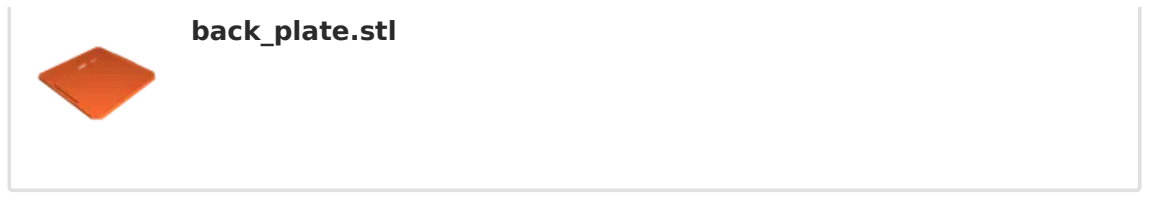
[picture p55: figure]
back_plate.stl

## Other files

- source file

## License

This work is licensed under a
Creative Commons (4.0 International License)

Attribution—Noncommercial—Share Alike (http://creativecommons.org/licenses/by-nc-sa/4.0/)

✖ | Sharing without ATTRIBUTION
✔ | Remix Culture allowed
✖ | Commercial Use
✖ | Free Cultural Works
✖ | Meets Open Definition

otton.step

otton-assembly-instructions-v11.pdf
