ppatlux/customizer-as-website/assets/models/special/OttoTruck/1636188-otto-the-truck-european-old-bb209f41-5553-4798-ae3a-28a9ddccb97d.pdf

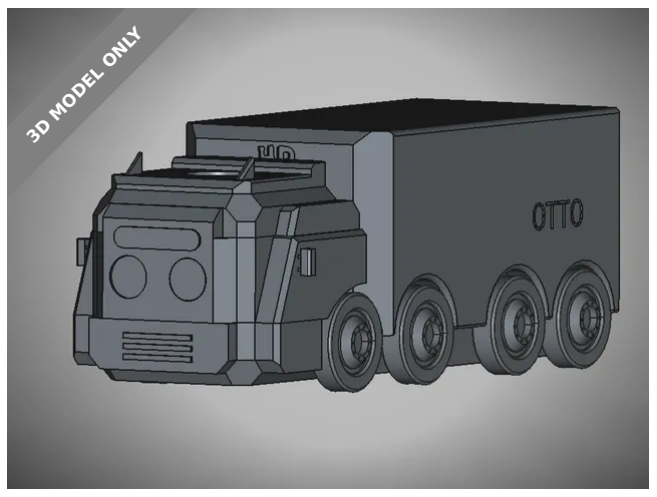
[picture p56: figure]
3D MODEL ONLY

## Summary

This was my first design ever with cad software

Learning (https://printables.com/model?categoryId=90) > Engineering (https://printables.com/model?categoryId=93)

Tags: | 3d | fun | hard | giveaway

Assemble:

This version assembles the same way as the standard Otto build.
All electronics and components are placed in the same positions as the normal Otto robot. The only difference is the outer truck-style body design.
Why?

This was actually my first design ever made in CAD. When I started exploring Otto, I thought the robot looked quite small, and the shape reminded me a bit of a tiny truck. That idea made me curious about whether I could turn the robot into a little vehicle instead of the usual walking design.

Since I was completely new to CAD, a lot of this version was experimentation. I was figuring out how parts fit together, how to shape the body, and how to make something that could realistically be printed.

Luck8060 Fjord (https://printables.com/@Luck8060Fjor_4503093)

## Otto the Truck European ( Old )

VIEW IN BROWSER (https://printables.com/model/1636188-otto-the-truck-european-old)

updated 13. 3. 2026 | published 13. 3. 2026

## Model files

It’s definitely a rougher design compared to the newer version, but it was an important step in the process because it’s where I learned the basics.

## This remix is based on

HP Robots | Otto Starter (https://printables.com/model/829419-hp-robots-otto-starter)
by HP Robots Otto (https://printables.com/@hprobots)

middle.stl

back-wheel.stl

mask.stl

pole.stl

trailer.stl

bottom.stl

## License

This work is licensed under a
Creative Commons (4.0 International License)

Attribution—Noncommercial—Share Alike (http://creativecommons.org/licenses/by-nc-sa/4.0/)

✖ | Sharing without ATTRIBUTION
✔ | Remix Culture allowed
✖ | Commercial Use
✖ | Free Cultural Works
✖ | Meets Open Definition

top.stl

front-wheel.stl
