ppatlux/customizer-as-website/assets/models/special/ball/hexball.png

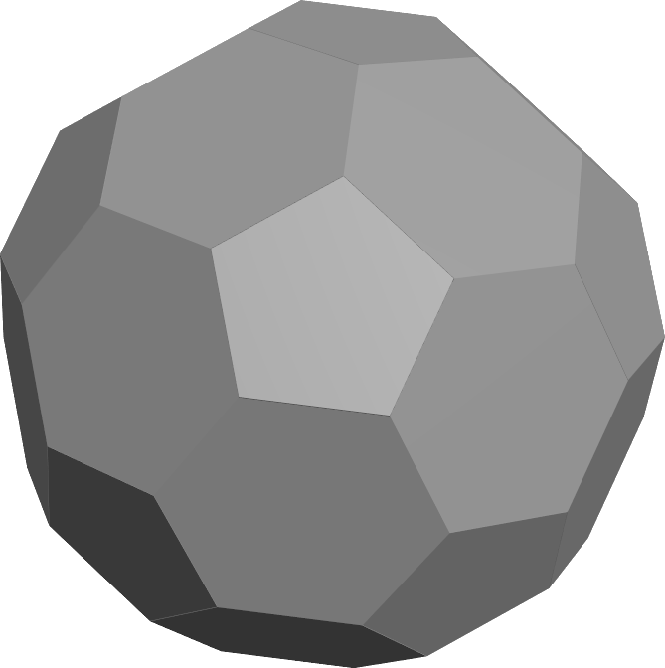
assets/models/special/ball/hexball.png
