ppatlux/customizer-as-website/assets/models/special/keychain/Otto_keychain.png

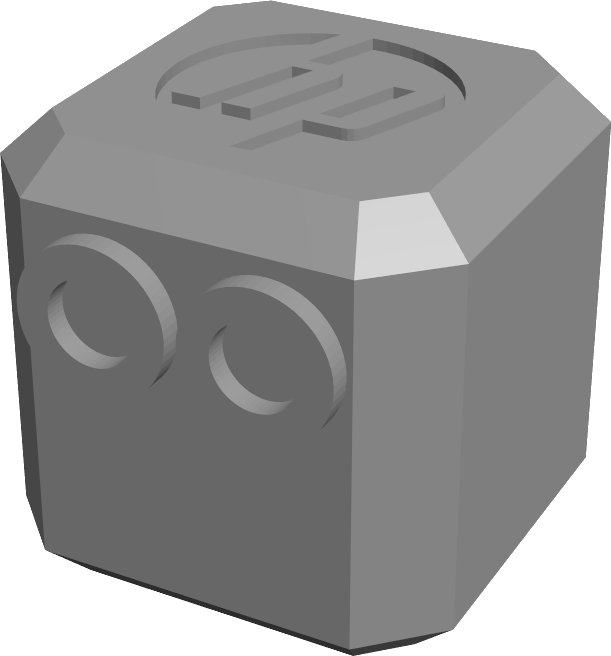
assets/models/special/keychain/Otto_keychain.png
