ppatlux/customizer-as-website/assets/models/special/soccer field/soccer field.png

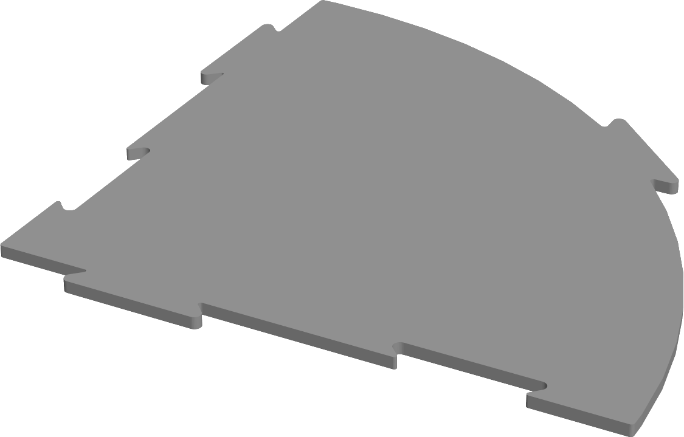
assets/models/special/soccer field/soccer field.png
