ppatlux/customizer-as-website/assets/models/special/OttoUnit01/Complete Assembly/otto_unit_01_complete_assembly.stl

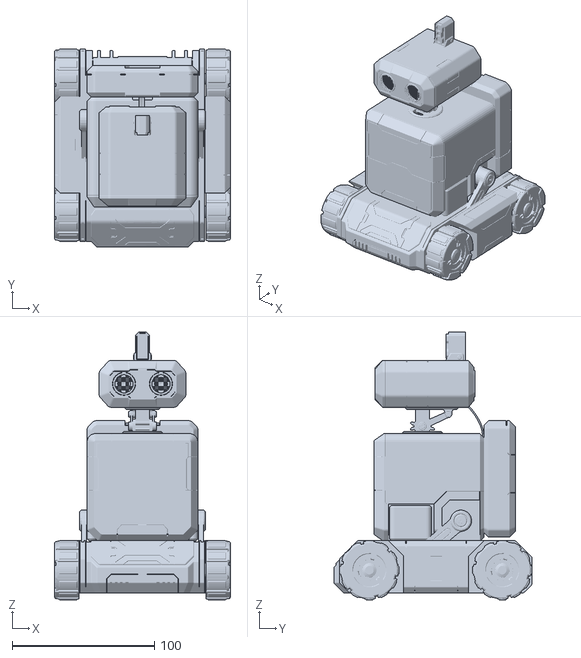
[picture p60: CAD file, 2026-10-27]
assets/models/special/OttoUnit01/Complete Assembly/otto_unit_01_complete_assembly.stl
124.0 x 139.5 x 188.6
