ppatlux/customizer-as-website/assets/models/special/OttoSwim/swimmer-otto-full-print.3mf

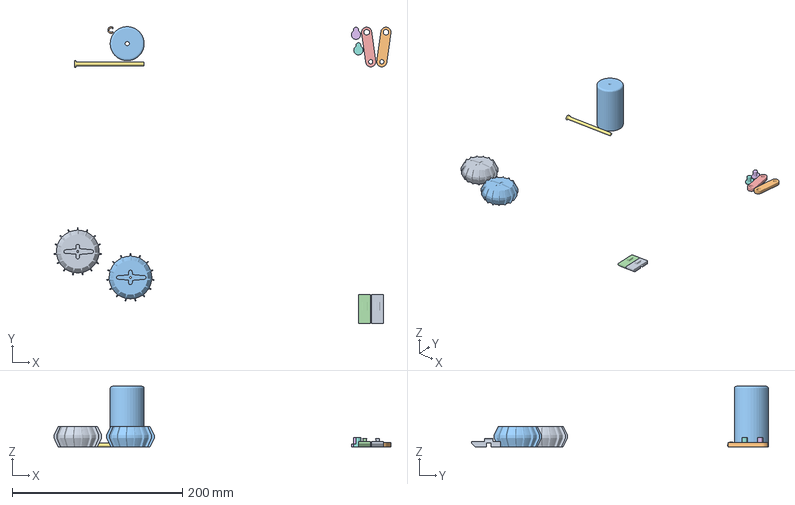
[picture p61: CAD file, 2026-10-27]
assets/models/special/OttoSwim/swimmer-otto-full-print.3mf
395.3 x 348.0 x 71.0 mm
outside leg x 2
Front floater
inside clip x 2
spin rod
spin rod clip
