ppatlux/customizer-as-website/assets/models/special/OttoN/02 Inner Frame/mainboard_support.stl

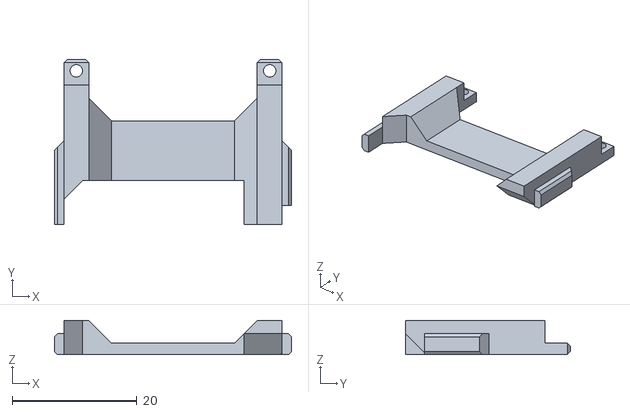
[picture p62: CAD file, 2026-10-27]
assets/models/special/OttoN/02 Inner Frame/mainboard_support.stl
38.0 x 26.4 x 5.50
