ppatlux/customizer-as-website/assets/models/bumper/document-overalls.stl

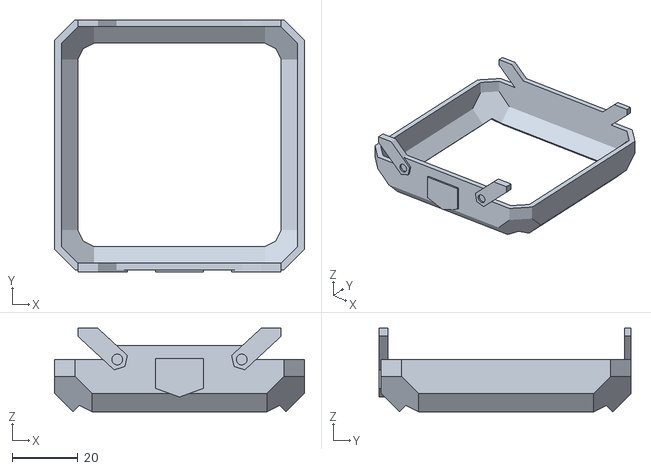
[picture p63: CAD file, 2026-10-27]
assets/models/bumper/document-overalls.stl
76.2 x 76.9 x 25.5
