ppatlux/customizer-as-website/assets/models/special/OttoN/02 Inner Frame/mainboard.stl

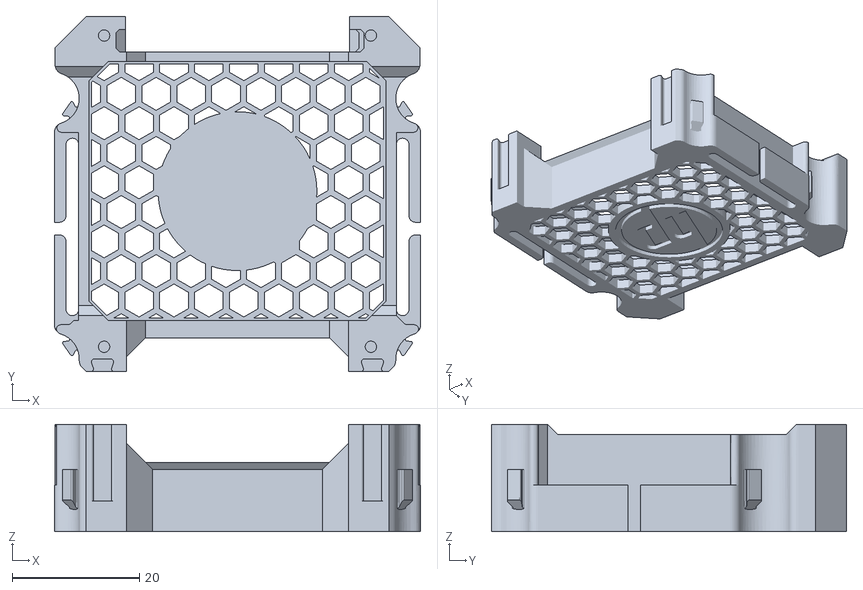
[picture p64: CAD file, 2026-10-27]
assets/models/special/OttoN/02 Inner Frame/mainboard.stl
57.6 x 55.9 x 16.9
