ppatlux/customizer-as-website/assets/models/special/OttoN/02 Inner Frame/mainboard_top.stl

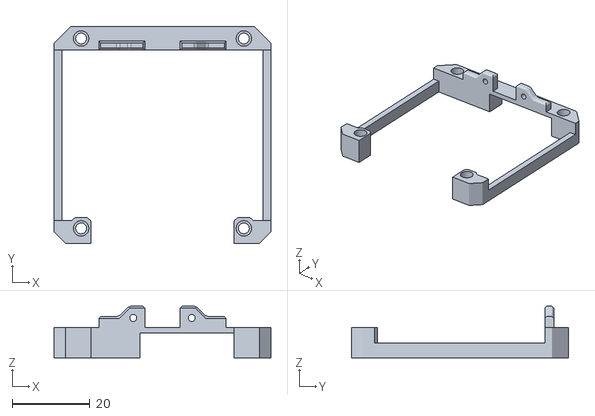
[picture p65: CAD file, 2026-10-27]
assets/models/special/OttoN/02 Inner Frame/mainboard_top.stl
56.0 x 56.0 x 13.3
