ppatlux/customizer-as-website/assets/models/special/OttoUnit01/STEP Files/otto_body_main_v2.step

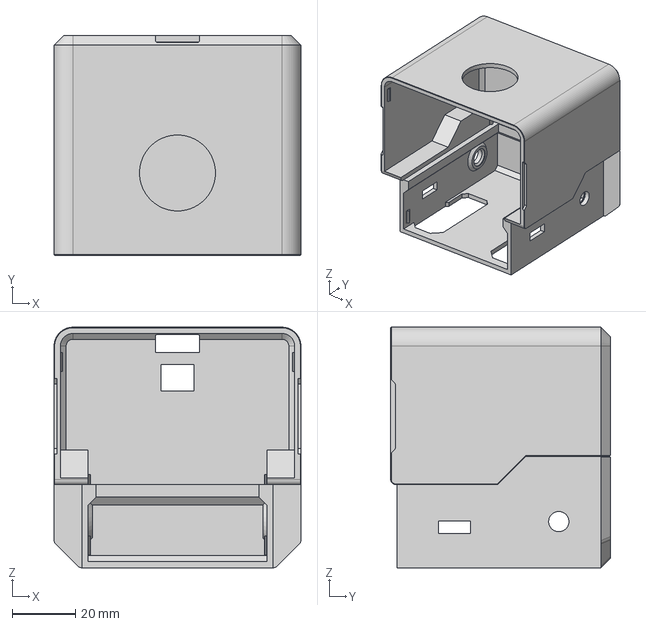
[picture p66: CAD file, 2026-10-27]
assets/models/special/OttoUnit01/STEP Files/otto_body_main_v2.step
78.0 x 69.4 x 76.0 mm
