ppatlux/customizer-as-website/assets/models/special/OttoUnit01/STEP Files/otto_backpack_main.step

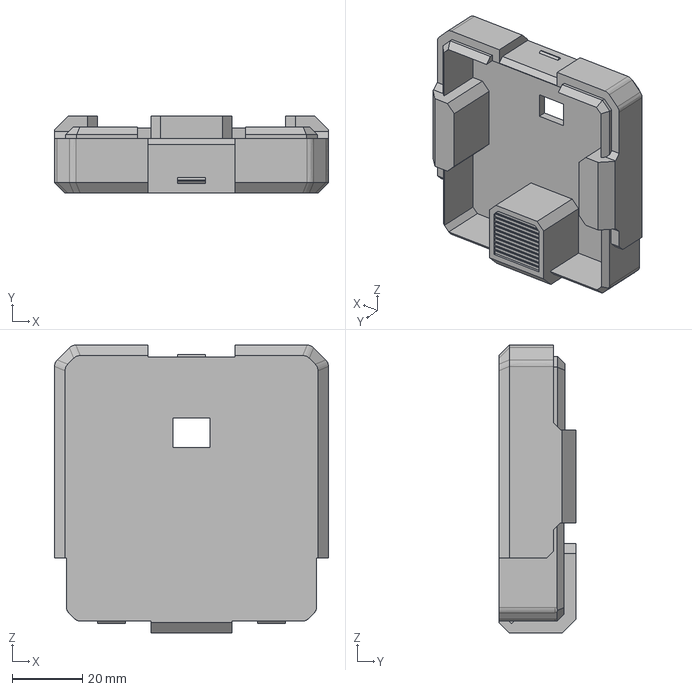
[picture p67: CAD file, 2026-10-27]
assets/models/special/OttoUnit01/STEP Files/otto_backpack_main.step
78.0 x 22.0 x 82.0 mm
