ppatlux/customizer-as-website/assets/models/special/OttoUnit01/STEP Files/otto_bottom_main.step

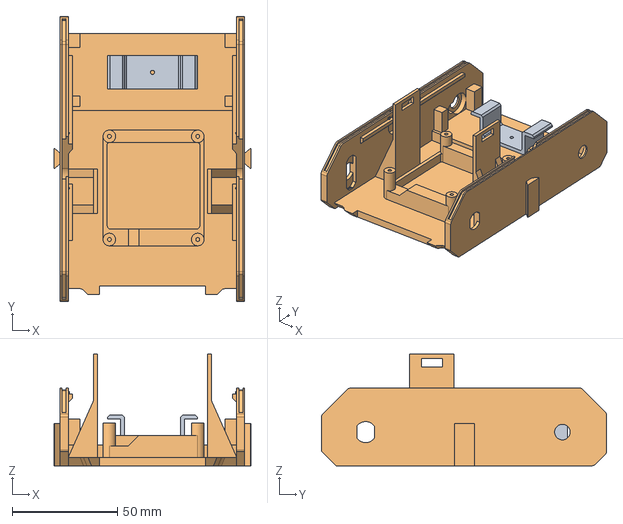
[picture p68: CAD file, 2026-10-27]
assets/models/special/OttoUnit01/STEP Files/otto_bottom_main.step
93.6 x 135.5 x 53.0 mm
