ppatlux/customizer-as-website/assets/models/top/ToplightsKoalasmall.stl

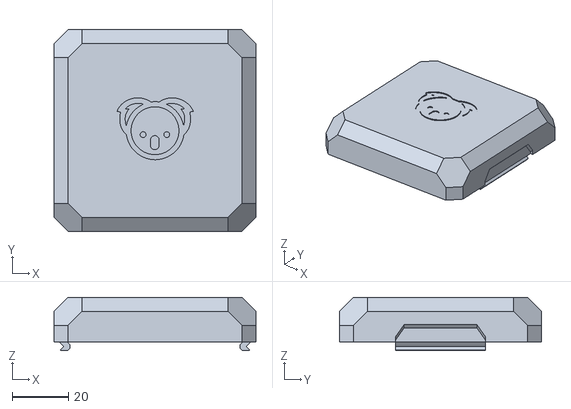
[picture p69: CAD file, 2026-07-15]
assets/models/top/ToplightsKoalasmall.stl
72.0 x 72.0 x 19.0
