ppatlux/customizer-as-website/assets/models/_mixonly/bottom_extend_pcb_r1 (1).stl

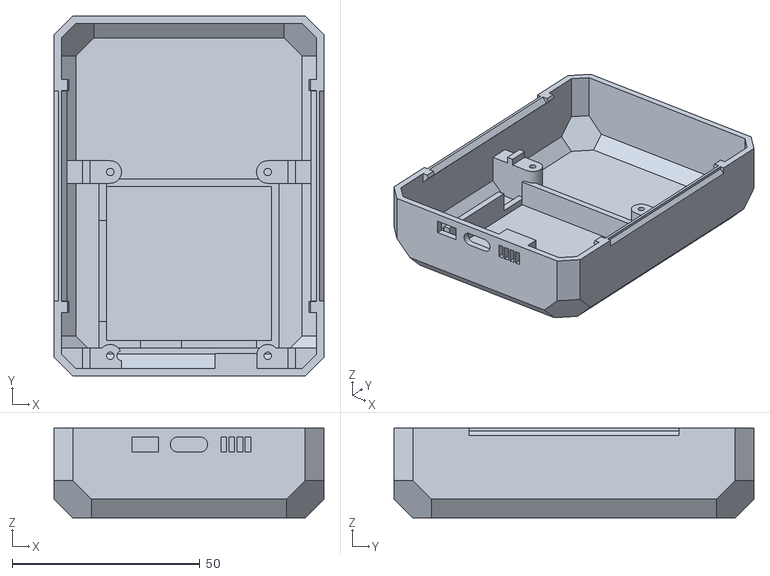
[picture p70: CAD file, 2026-07-24]
assets/models/_mixonly/bottom_extend_pcb_r1 (1).stl
72.0 x 96.0 x 24.0
