ppatlux/customizer-as-website/assets/models/arms/wings.stp

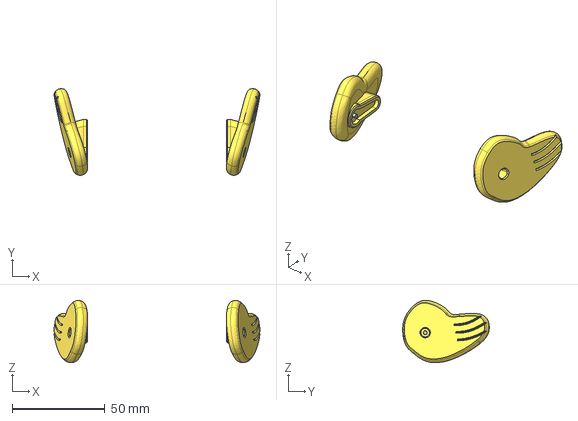
[picture p71: CAD file, 2026-08-24]
assets/models/arms/wings.stp
111.2 x 46.8 x 33.6 mm
