ppatlux/customizer-as-website/assets/models/bottom/Bottom_Lid.stl

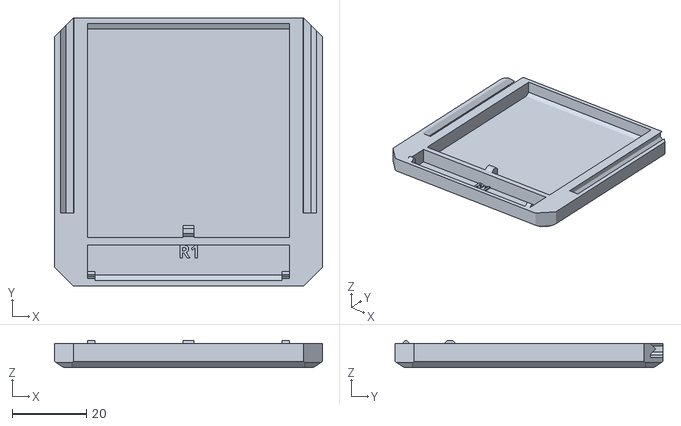
[picture p72: CAD file, 2026-11-04]
assets/models/bottom/Bottom_Lid.stl
72.0 x 72.0 x 7.30
