ppatlux/customizer-as-website/assets/models/bumper/Bumper_Canholder.stl

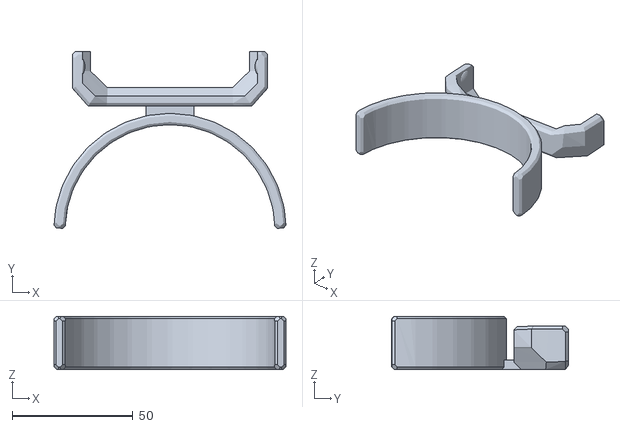
[picture p73: CAD file, 2026-11-04]
assets/models/bumper/Bumper_Canholder.stl
95.9 x 73.1 x 22.1
