ppatlux/customizer-as-website/assets/models/bumper/pen/pc-3m.stl

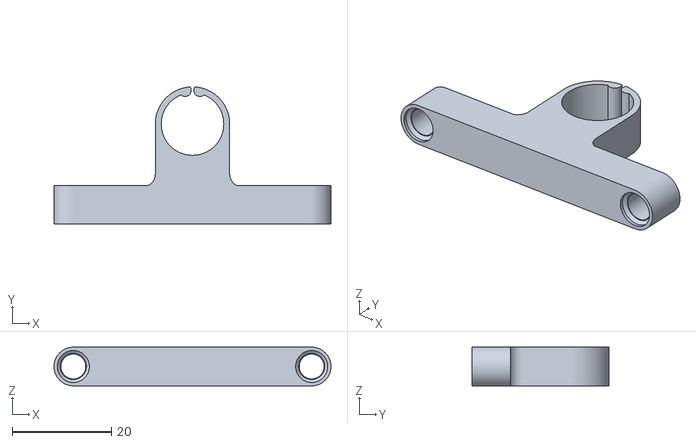
[picture p74: CAD file, 2026-10-27]
assets/models/bumper/pen/pc-3m.stl
55.8 x 27.6 x 7.80
