ppatlux/customizer-as-website/assets/models/bumper/technic/HP_Motor bumper_R1.stl

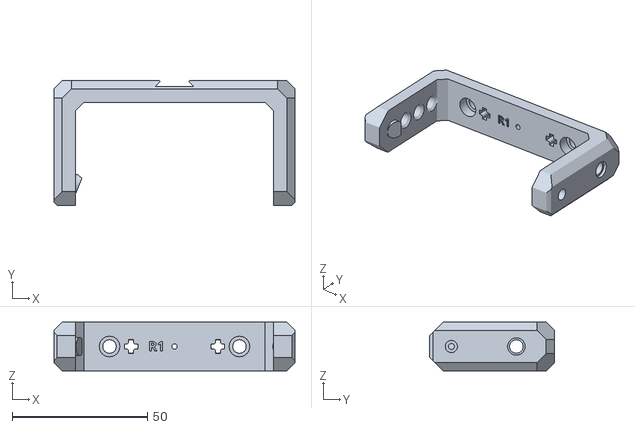
[picture p75: CAD file, 2026-07-15]
assets/models/bumper/technic/HP_Motor bumper_R1.stl
89.0 x 46.0 x 18.0
