ppatlux/customizer-as-website/assets/models/face/Face_Pika.step

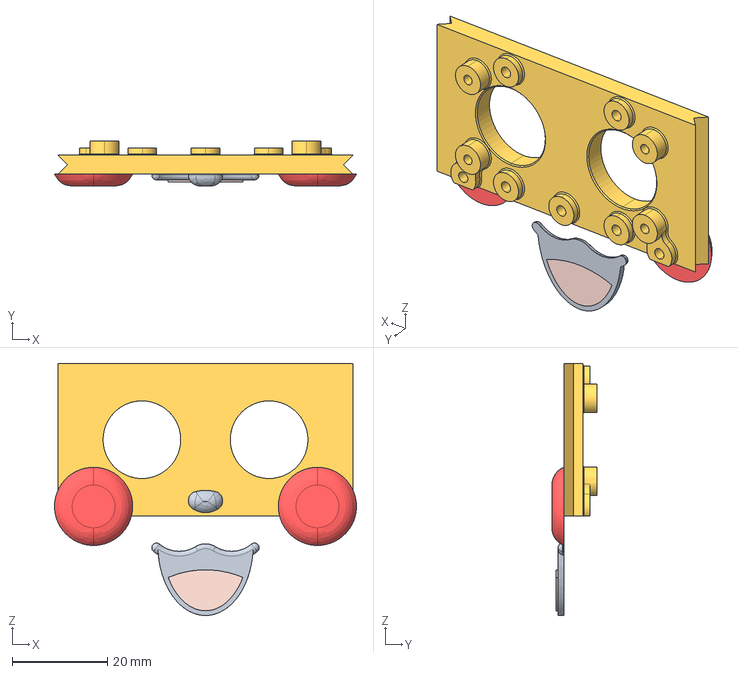
[picture p76: CAD file, 2026-08-28]
assets/models/face/Face_Pika.step
63.4 x 9.50 x 52.9 mm
