ppatlux/customizer-as-website/assets/models/face/steve/bouche.stl

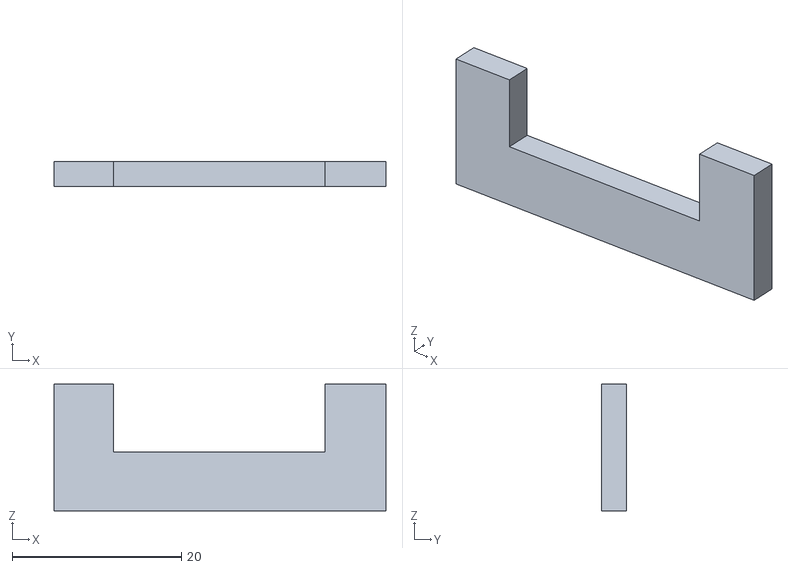
[picture p77: CAD file, 2026-08-17]
assets/models/face/steve/bouche.stl
39.2 x 3.00 x 14.9
