ppatlux/customizer-as-website/assets/models/hat/andaluz/Hat_Flat.stl

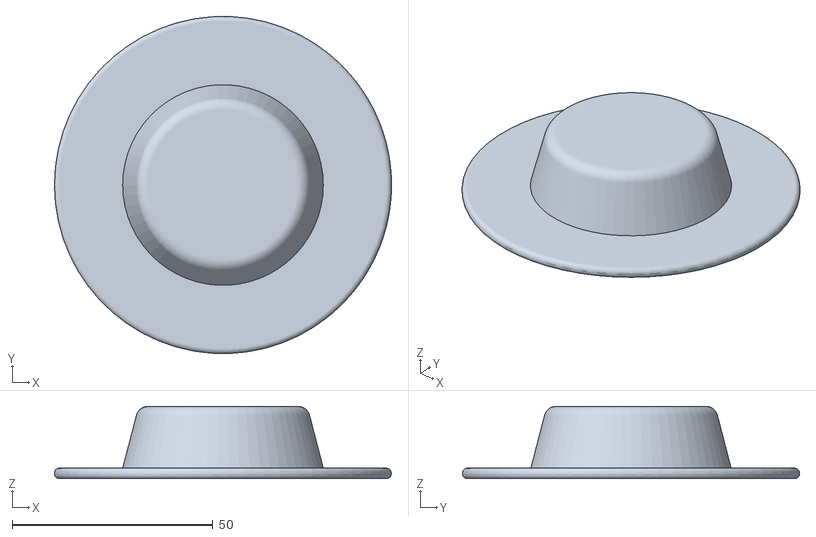
[picture p78: CAD file, 2026-07-15]
assets/models/hat/andaluz/Hat_Flat.stl
84.0 x 84.0 x 18.0
