ppatlux/customizer-as-website/assets/models/hat/Hat_sombrero.3mf

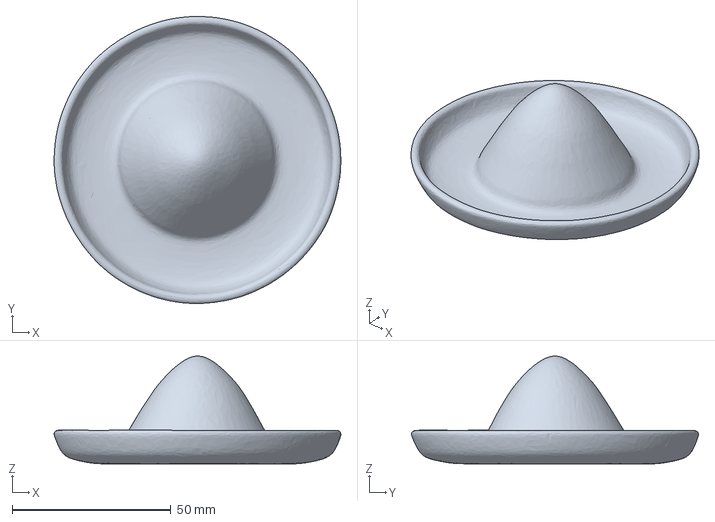
[picture p79: CAD file, 2026-11-04]
assets/models/hat/Hat_sombrero.3mf
90.5 x 90.5 x 34.0 mm
