ppatlux/customizer-as-website/assets/models/middle/middle_extended_v1b.stl

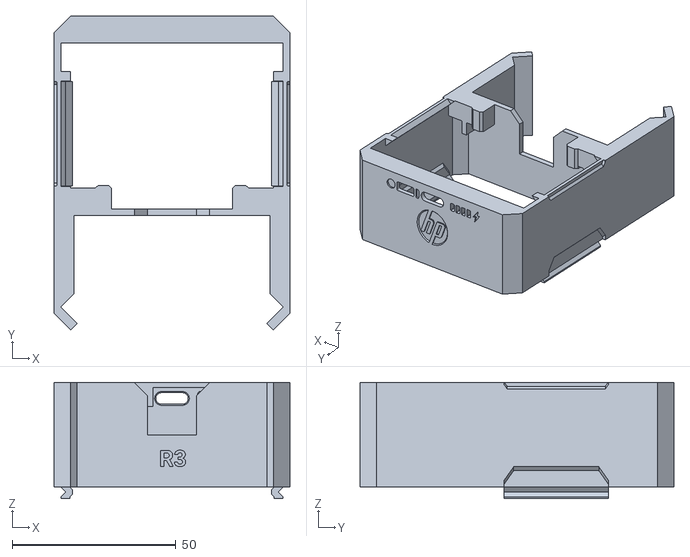
[picture p80: CAD file, 2026-10-27]
assets/models/middle/middle_extended_v1b.stl
72.0 x 96.0 x 35.5
