ppatlux/customizer-as-website/assets/models/motion/technic/HP_gripperbase_R1.stl

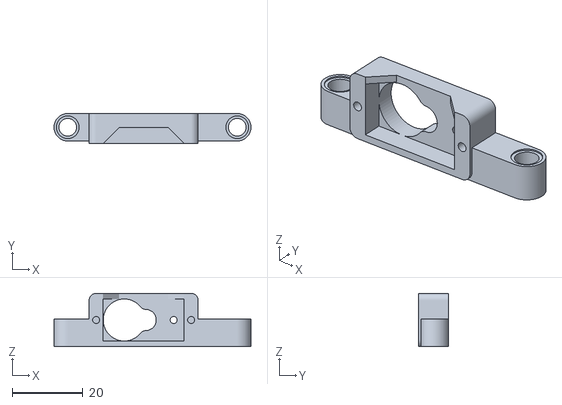
[picture p82: CAD file, 2026-07-15]
assets/models/motion/technic/HP_gripperbase_R1.stl
55.8 x 8.50 x 15.1
