ppatlux/customizer-as-website/assets/models/motion/tires/spikey.stl

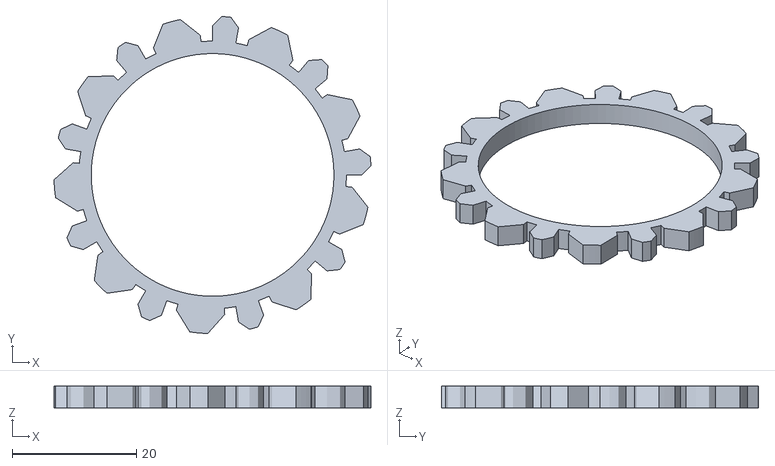
[picture p83: CAD file, 2026-08-17]
assets/models/motion/tires/spikey.stl
50.9 x 50.9 x 3.50
