ppatlux/customizer-as-website/assets/models/motion/walk&roll/footL_v03.stl

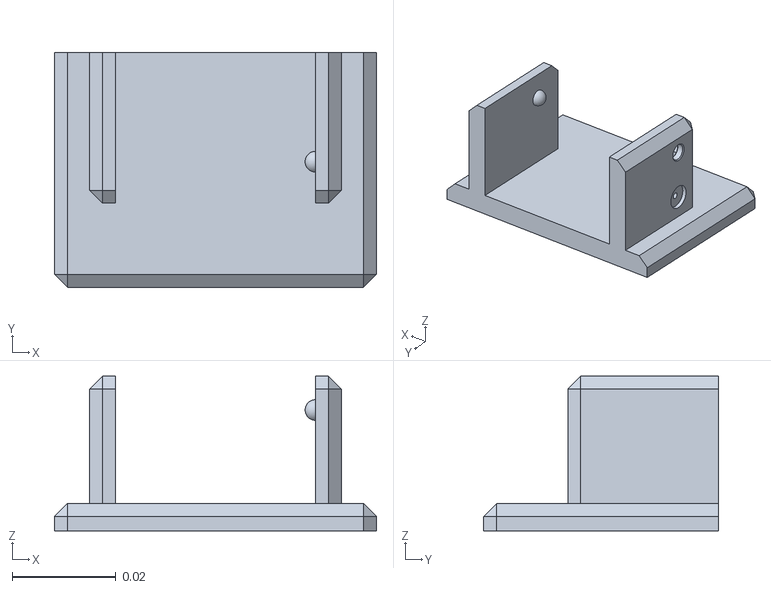
[picture p84: CAD file, 2026-07-15]
assets/models/motion/walk&roll/footL_v03.stl
0.062 x 0.0452 x 0.0298
