ppatlux/customizer-as-website/assets/models/spacer/body_for_hands.stl

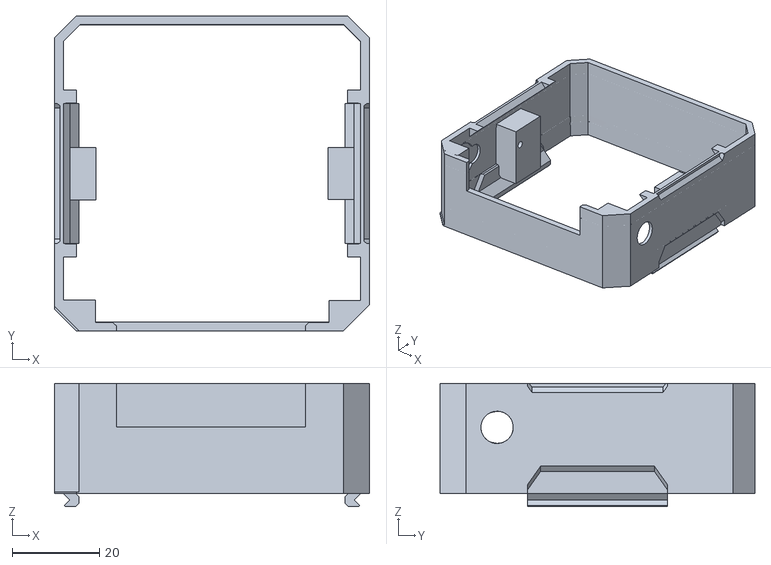
[picture p85: CAD file, 2026-08-17]
assets/models/spacer/body_for_hands.stl
72.0 x 72.0 x 28.2
