ppatlux/customizer-as-website/assets/models/special/ball/white middle.stl

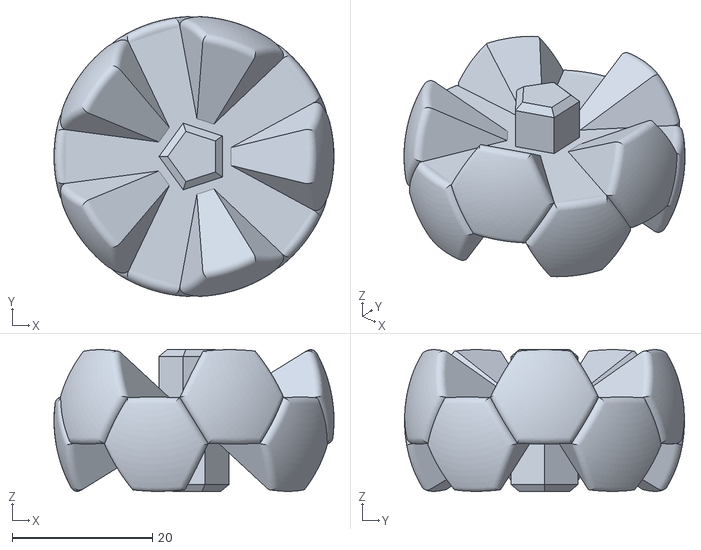
[picture p86: CAD file, 2026-09-22]
assets/models/special/ball/white middle.stl
40.0 x 39.9 x 20.3
