ppatlux/customizer-as-website/assets/models/special/controller/topcontrol_nonumber.stl

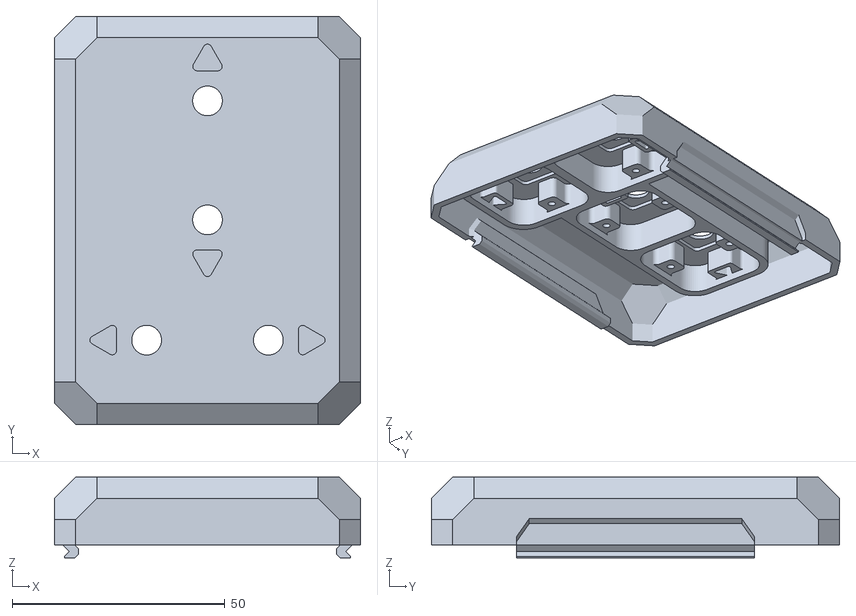
[picture p87: CAD file, 2026-08-25]
assets/models/special/controller/topcontrol_nonumber.stl
72.0 x 96.0 x 19.0
