ppatlux/customizer-as-website/assets/models/special/helmet/smallhelmet_lens.stl

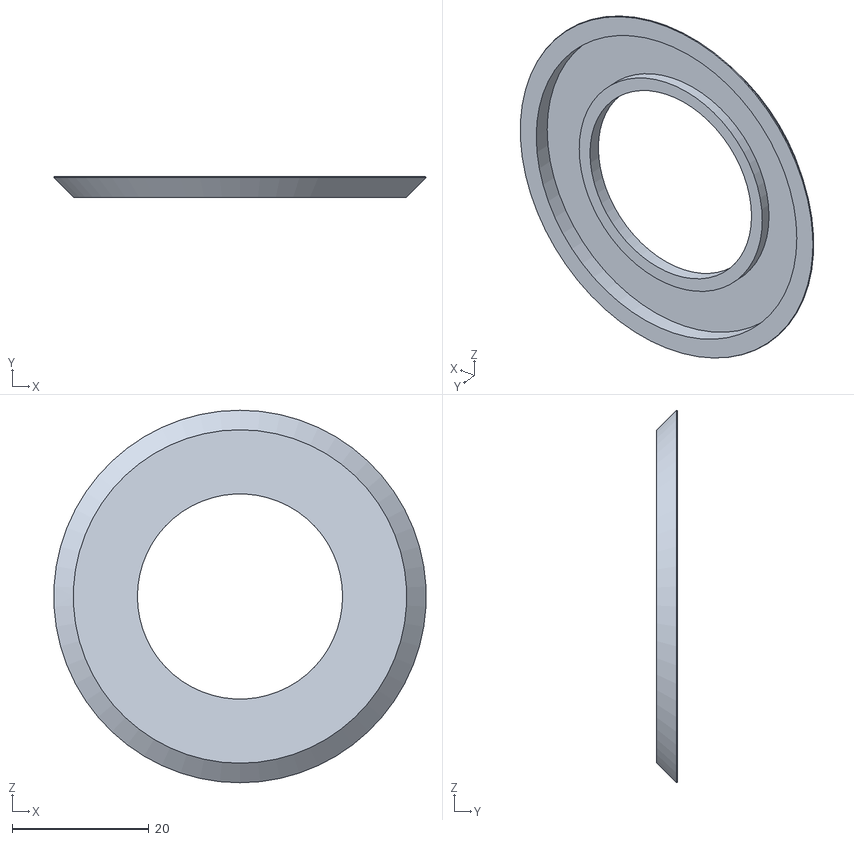
[picture p89: CAD file, 2026-07-24]
assets/models/special/helmet/smallhelmet_lens.stl
54.4 x 3.00 x 54.5
