ppatlux/customizer-as-website/assets/models/special/keychain/keychain_ottoface_R2.stl

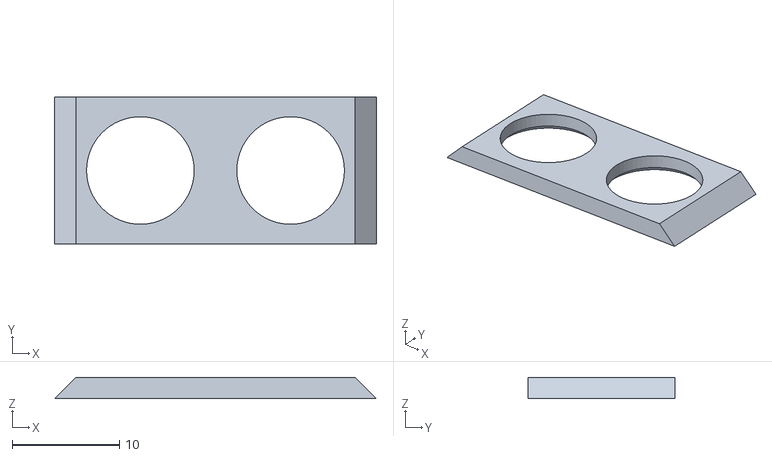
[picture p90: CAD file, 2026-09-22]
assets/models/special/keychain/keychain_ottoface_R2.stl
30.0 x 13.7 x 2.00
