ppatlux/customizer-as-website/assets/models/special/line puzzle/trackstraight_v3.stl

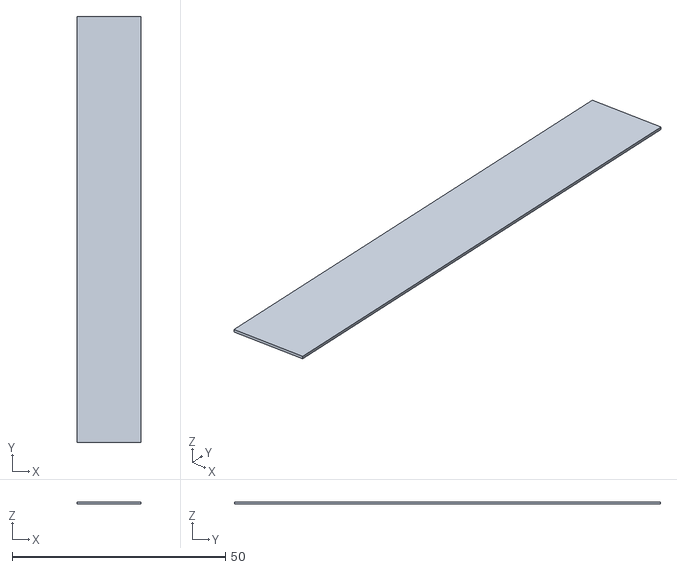
[picture p91: CAD file, 2026-07-24]
assets/models/special/line puzzle/trackstraight_v3.stl
15.0 x 99.9 x 0.5
