ppatlux/customizer-as-website/assets/models/special/Otto5/Accessories/acc_toolbox_noname.stl

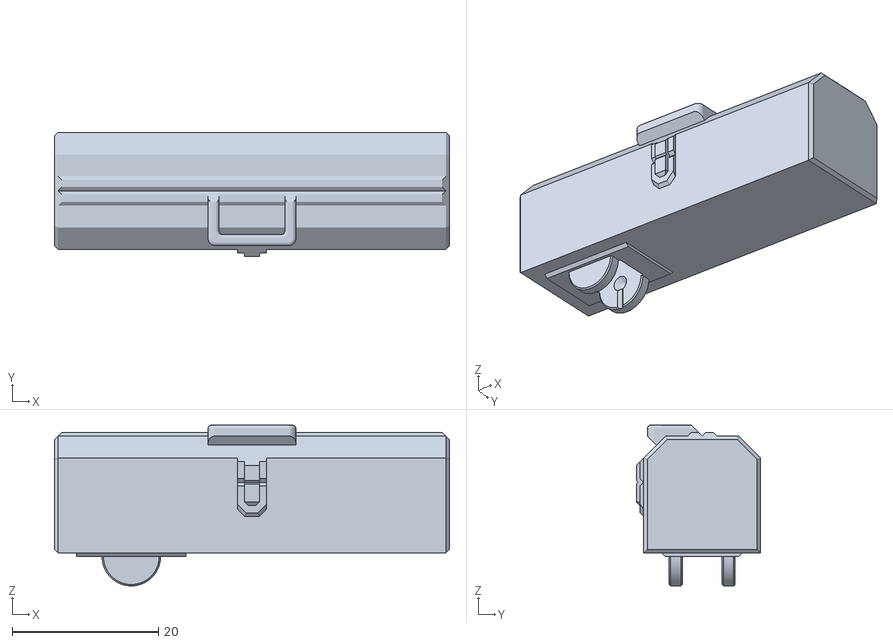
[picture p92: CAD file, 2026-10-27]
assets/models/special/Otto5/Accessories/acc_toolbox_noname.stl
54.0 x 17.0 x 22.0
