ppatlux/customizer-as-website/assets/models/special/Otto5/bottom.3mf

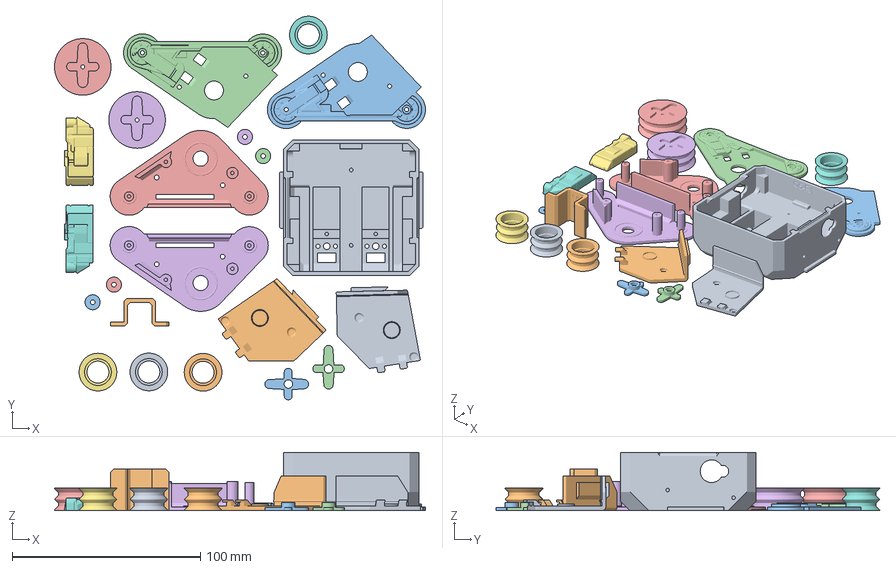
[picture p93: CAD file, 2026-10-27]
assets/models/special/Otto5/bottom.3mf
196.8 x 203.5 x 30.9 mm
Bot_base.stl
Bot_bracket_servo.stl
Bot_motorarm.stl
Bot_track_base_L.stl
Bot_track_base_R.stl
Bot_track_cover_L.stl
Bot_track_cover_R.stl
Bot_track_side_bracket_L.stl
Bot_track_side_bracket_R.stl
Bot_track_side_L.stl
Bot_track_side_R.stl
Bot_track_wheel_large.stl
Bot_track_wheel_small.stl
Bot_track_wheel_small_washer.stl
