ppatlux/customizer-as-website/assets/models/special/Otto5/Bottom/bot_motorarm.stl

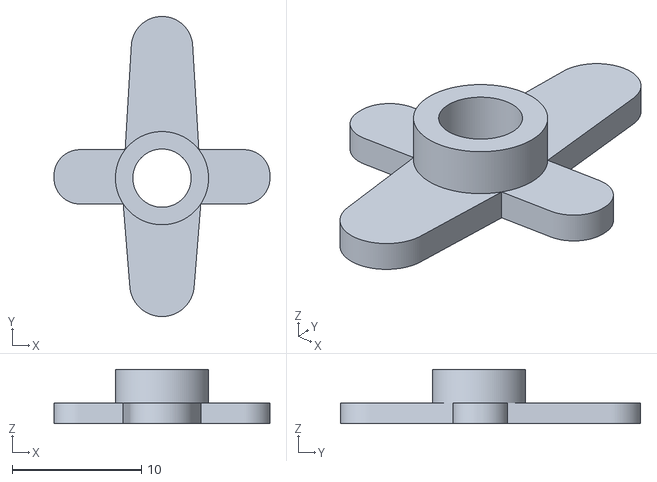
[picture p94: CAD file, 2026-10-27]
assets/models/special/Otto5/Bottom/bot_motorarm.stl
16.7 x 23.2 x 4.20
