ppatlux/customizer-as-website/assets/models/special/Otto5/STEP Files/bot_track_wheel_small.stp

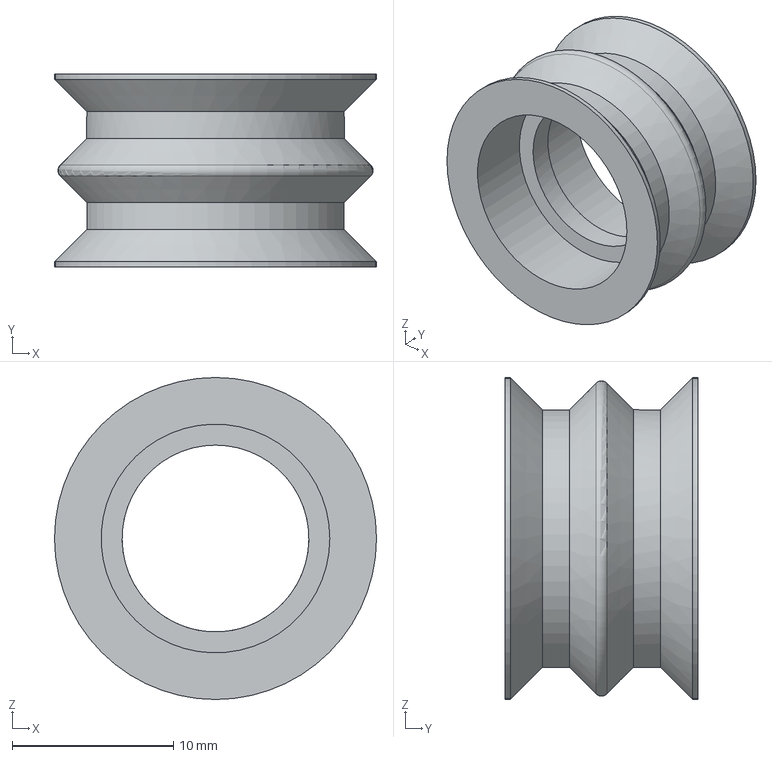
[picture p95: CAD file, 2026-10-27]
assets/models/special/Otto5/STEP Files/bot_track_wheel_small.stp
20.0 x 12.0 x 20.0 mm
