ppatlux/customizer-as-website/assets/models/special/Otto5/Top/top_arm_bot_l.stl

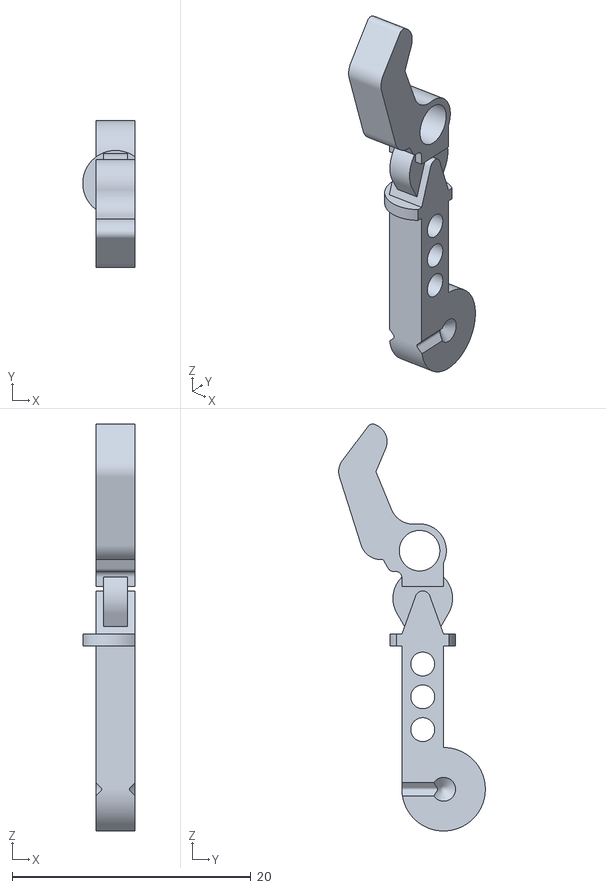
[picture p96: CAD file, 2026-10-27]
assets/models/special/Otto5/Top/top_arm_bot_l.stl
4.40 x 12.3 x 34.1
