ppatlux/customizer-as-website/assets/models/special/OttoButter/3MF (Almost ready to print files)/pass-the-butter_butter.3mf

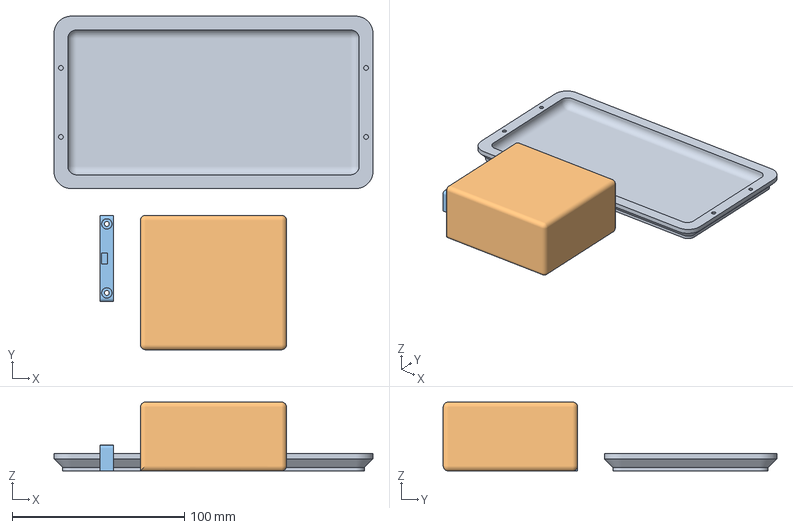
[picture p97: CAD file, 2026-10-27]
assets/models/special/OttoButter/3MF (Almost ready to print files)/pass-the-butter_butter.3mf
185.0 x 193.5 x 40.0 mm
Butter.STL_1
Butter.STL_2
Butter.STL_3
