ppatlux/customizer-as-website/assets/models/special/OttoButter/otto-pass-the-buttertop.stl

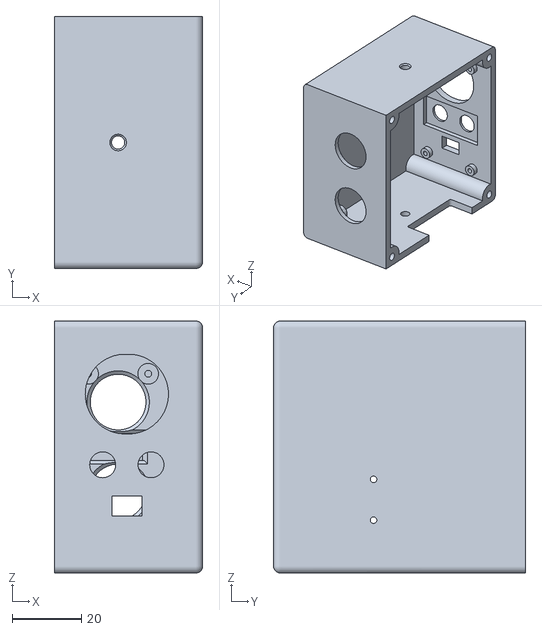
[picture p98: CAD file, 2026-10-27]
assets/models/special/OttoButter/otto-pass-the-buttertop.stl
43.0 x 73.0 x 73.0
