ppatlux/customizer-as-website/assets/models/special/OttoButter/STL (remember to separate by objects)/motor-wheel.stl

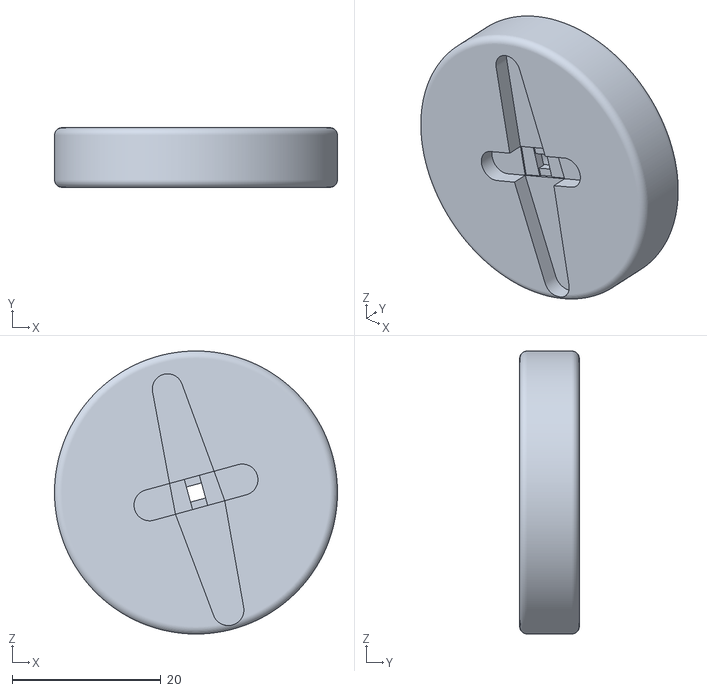
[picture p100: CAD file, 2026-10-27]
assets/models/special/OttoButter/STL (remember to separate by objects)/motor-wheel.stl
38.0 x 8.00 x 38.0
