ppatlux/customizer-as-website/assets/models/special/OttoBuzz/otto-dub-rear-wheel.stl

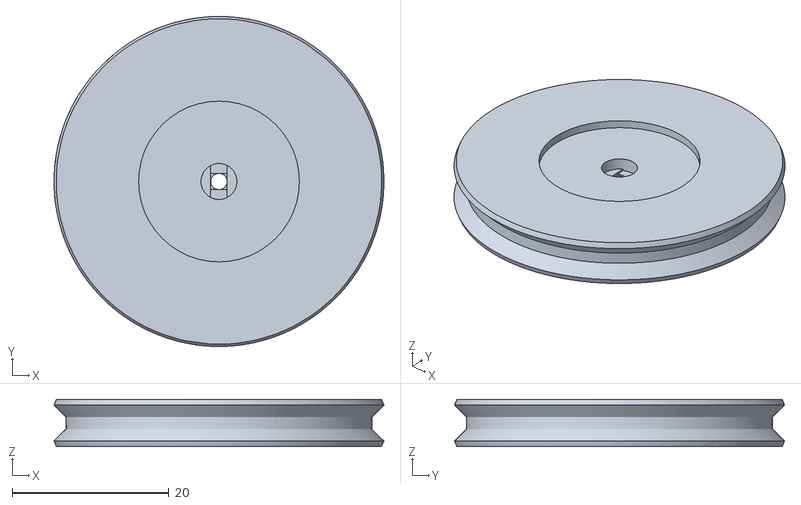
[picture p101: CAD file, 2026-10-27]
assets/models/special/OttoBuzz/otto-dub-rear-wheel.stl
42.1 x 42.1 x 6.00
