ppatlux/customizer-as-website/assets/models/special/OttoD2/otto-d2-caster-bracket.stl

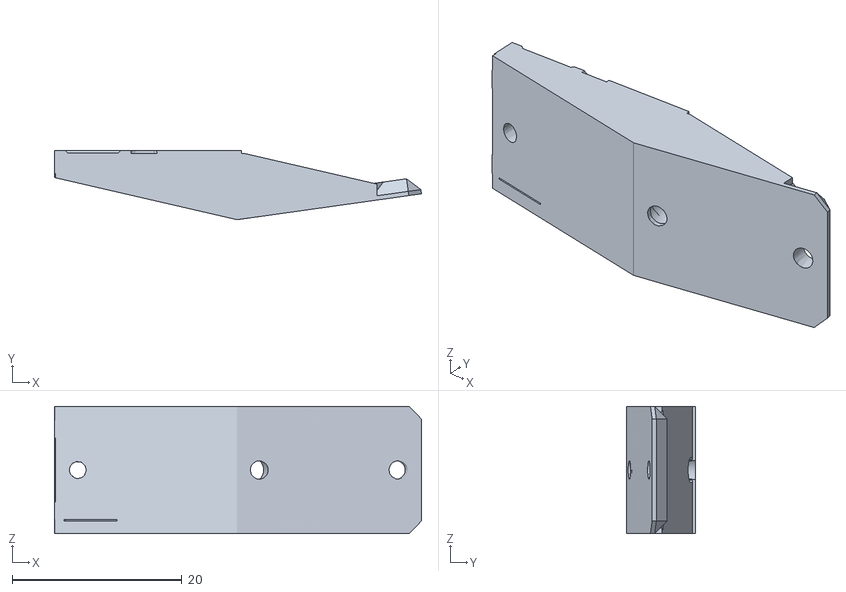
[picture p102: CAD file, 2026-10-27]
assets/models/special/OttoD2/otto-d2-caster-bracket.stl
43.2 x 8.17 x 15.0
