ppatlux/customizer-as-website/assets/models/special/OttoDino/bottom.stl

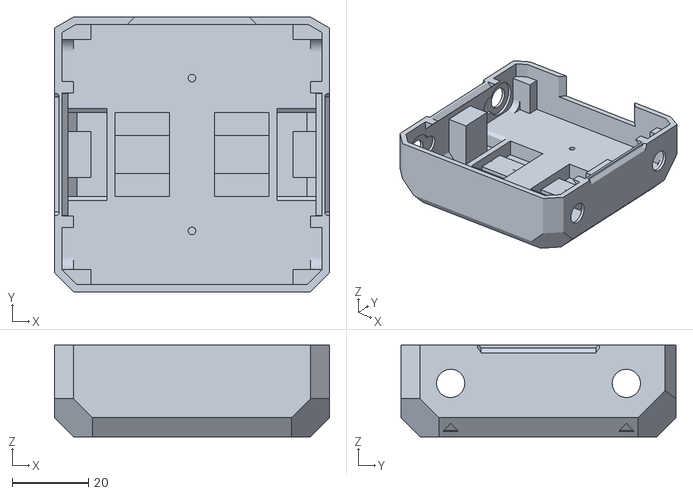
[picture p103: CAD file, 2026-10-27]
assets/models/special/OttoDino/bottom.stl
72.0 x 72.0 x 24.0
