ppatlux/customizer-as-website/assets/models/special/OttoExplorer/ottoexplorer_middle.stl

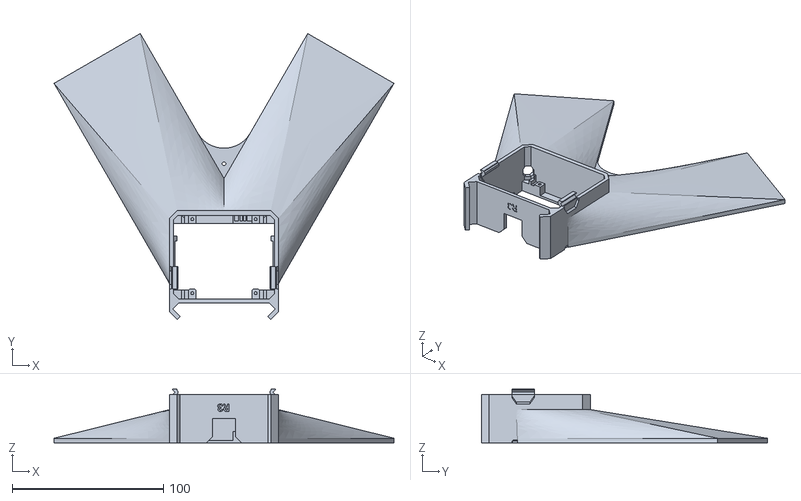
[picture p104: CAD file, 2026-10-27]
assets/models/special/OttoExplorer/ottoexplorer_middle.stl
225.2 x 189.3 x 35.5
