ppatlux/customizer-as-website/assets/models/special/OttoJr/otto.3mf

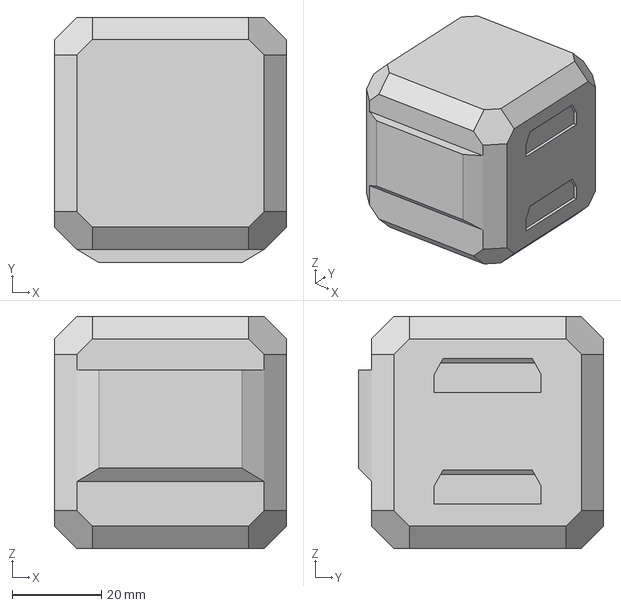
[picture p105: CAD file, 2026-10-27]
assets/models/special/OttoJr/otto.3mf
52.0 x 55.0 x 52.0 mm
