ppatlux/customizer-as-website/assets/models/special/OttoN/01 Part Set/outer_frame.stl

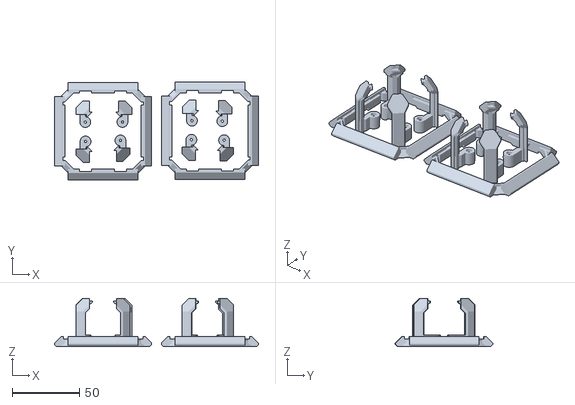
[picture p106: CAD file, 2026-10-27]
assets/models/special/OttoN/01 Part Set/outer_frame.stl
151.2 x 72.3 x 36.0
