ppatlux/customizer-as-website/assets/models/special/OttoN/02 Inner Frame/sensor_coaster_frame.stl

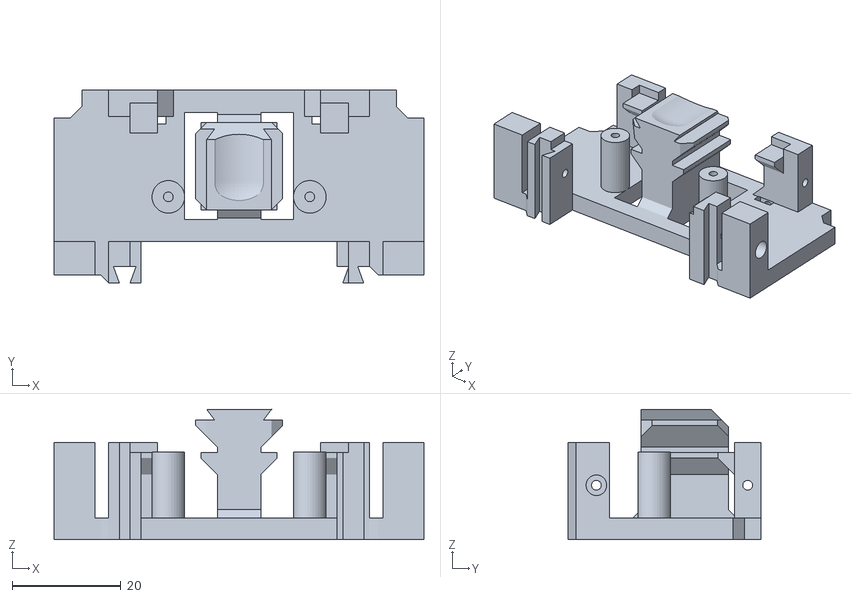
[picture p107: CAD file, 2026-10-27]
assets/models/special/OttoN/02 Inner Frame/sensor_coaster_frame.stl
68.0 x 35.4 x 23.9
