ppatlux/customizer-as-website/assets/models/special/OttoN/03 Outer Frame/corner_01.stl

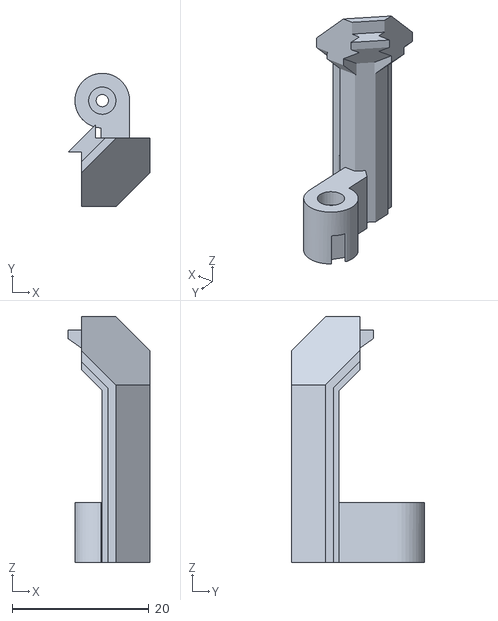
[picture p108: CAD file, 2026-10-27]
assets/models/special/OttoN/03 Outer Frame/corner_01.stl
12.0 x 19.5 x 36.0
