ppatlux/customizer-as-website/assets/models/special/OttoROS/ros-otto-o-ring-wheels.3mf

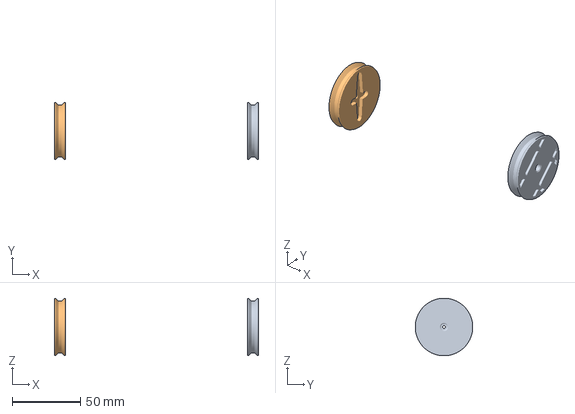
[picture p111: CAD file, 2026-10-27]
assets/models/special/OttoROS/ros-otto-o-ring-wheels.3mf
149.4 x 42.1 x 42.1 mm
Optional_Wheels
Optional_Wheels_(2)
