ppatlux/customizer-as-website/assets/models/special/OttoSwim/leg.stl

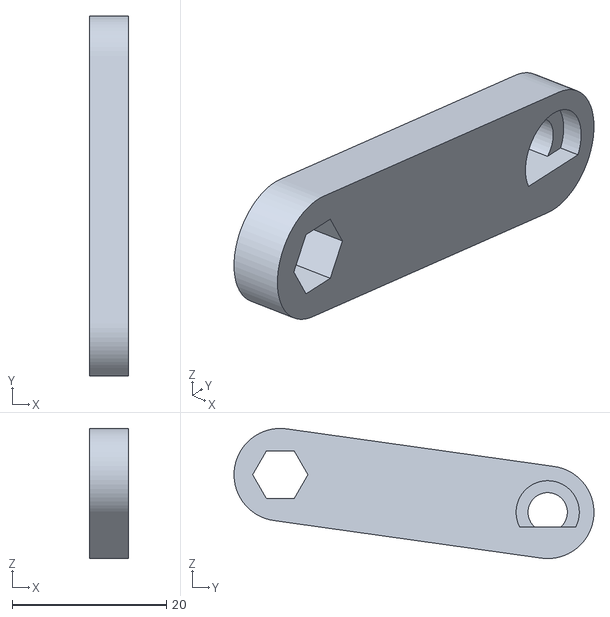
[picture p112: CAD file, 2026-10-27]
assets/models/special/OttoSwim/leg.stl
5.00 x 46.7 x 16.9
