ppatlux/customizer-as-website/assets/models/special/OttoTruck/print-3-updated-v3.3mf

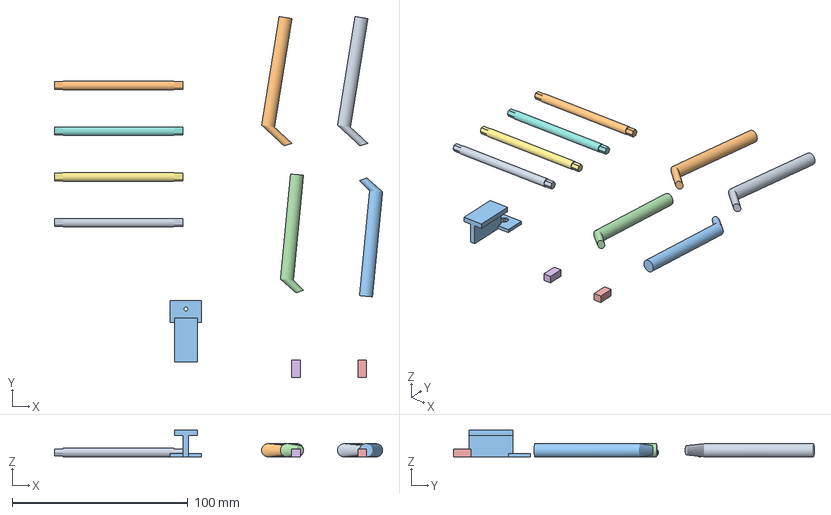
[picture p113: CAD file, 2026-10-27]
assets/models/special/OttoTruck/print-3-updated-v3.3mf
186.6 x 205.1 x 15.2 mm
Intake 2 - Part 1.stl x 2
Intake 1 - Part 1.stl x 2
Little thing - Part 1 (2).stl x 2
Axle- Part 1.stl x 4
Motor Fastener - Part 1.stl
