ppatlux/customizer-as-website/assets/models/special/OttoUnit01/BODY/body_arm_mount.stl

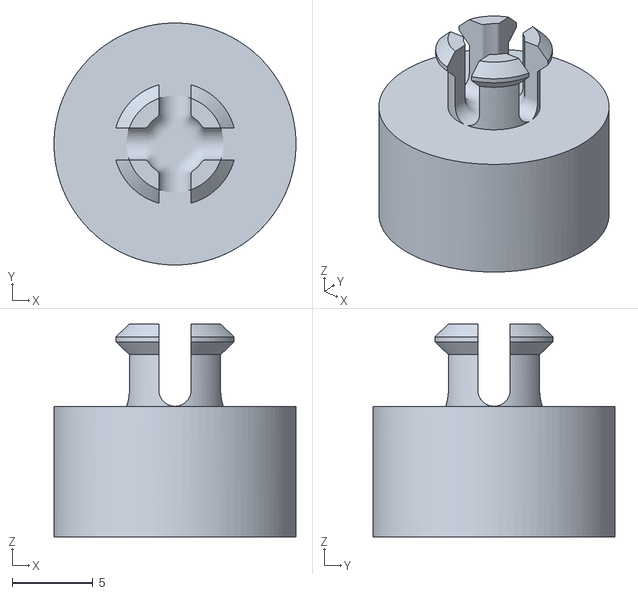
[picture p114: CAD file, 2026-10-27]
assets/models/special/OttoUnit01/BODY/body_arm_mount.stl
15.0 x 15.0 x 13.2
