ppatlux/customizer-as-website/assets/models/special/OttoUnit01/HEAD/head_plate.stl

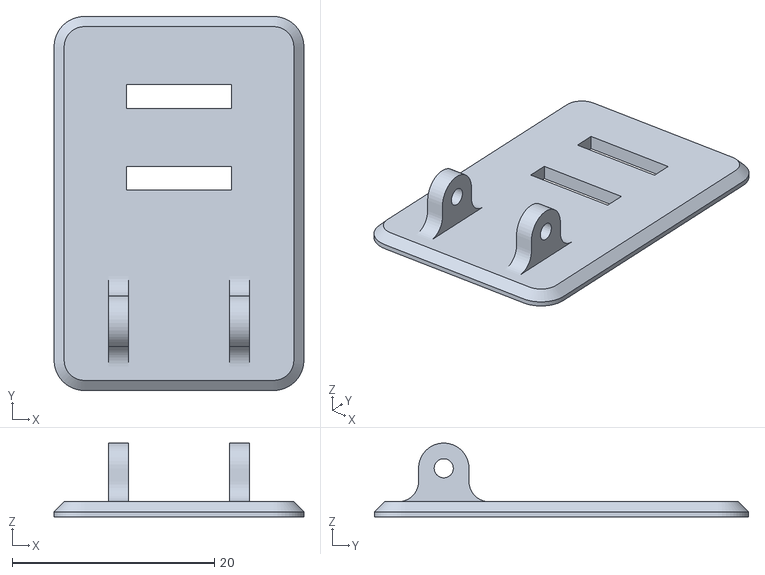
[picture p115: CAD file, 2026-10-27]
assets/models/special/OttoUnit01/HEAD/head_plate.stl
24.7 x 37.0 x 7.30
