ppatlux/customizer-as-website/assets/models/special/OttoUnit01/STEP Files/otto_bottom_back_cover_insert.step

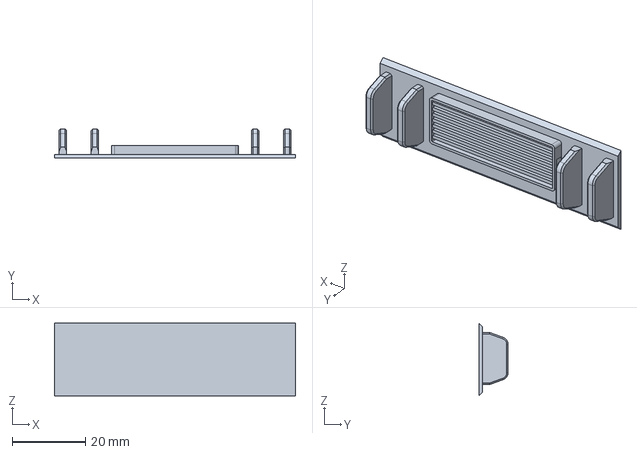
[picture p116: CAD file, 2026-10-27]
assets/models/special/OttoUnit01/STEP Files/otto_bottom_back_cover_insert.step
65.8 x 8.00 x 19.9 mm
