ppatlux/customizer-as-website/assets/models/special/OttoUnit01/TILT-PAN MECHANISM/servo_arm_4_70.stl

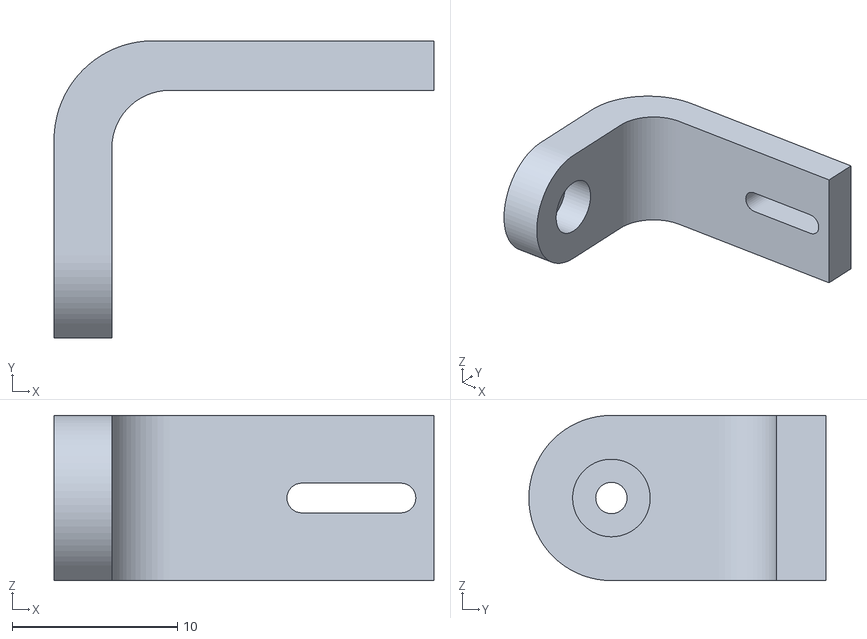
[picture p117: CAD file, 2026-10-27]
assets/models/special/OttoUnit01/TILT-PAN MECHANISM/servo_arm_4_70.stl
23.0 x 18.0 x 10.0
