ppatlux/customizer-as-website/assets/models/special/props/Planet_Toy_Hold.stl

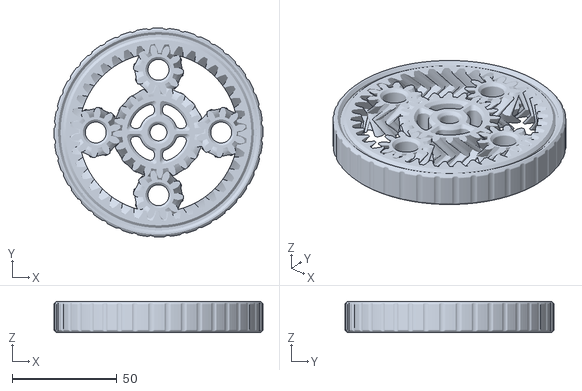
[picture p118: CAD file, 2026-10-27]
assets/models/special/props/Planet_Toy_Hold.stl
100.0 x 100.0 x 15.0
