ppatlux/customizer-as-website/assets/models/special/soccer field/line goal L_v2.stl

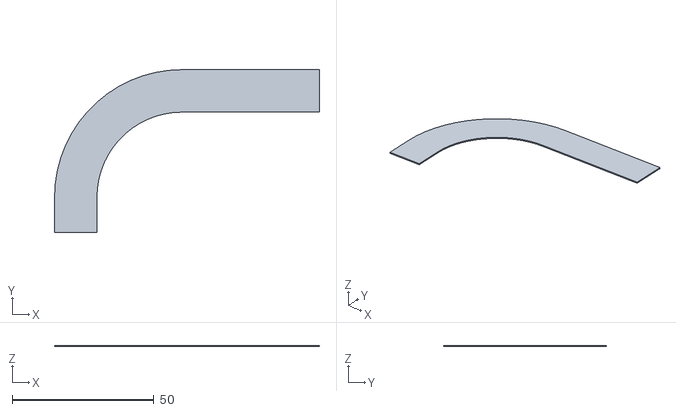
[picture p119: CAD file, 2026-07-24]
assets/models/special/soccer field/line goal L_v2.stl
93.6 x 57.4 x 0.5
