ppatlux/customizer-as-website/assets/models/special/starter/HP_Batterycovermesh_R2.stl

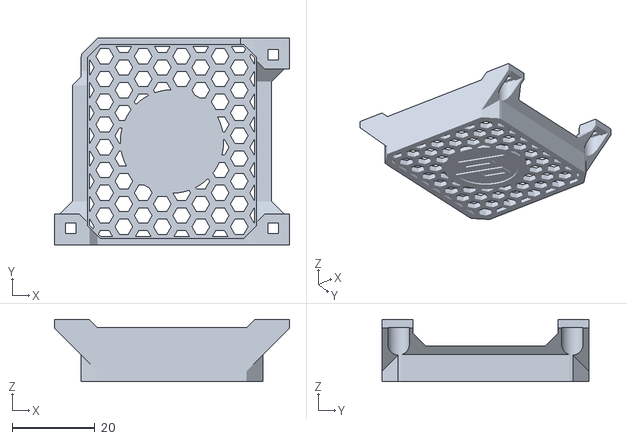
[picture p120: CAD file, 2026-08-24]
assets/models/special/starter/HP_Batterycovermesh_R2.stl
56.8 x 50.0 x 15.0
