ppatlux/customizer-as-website/assets/models/special/technic/LED-matrix-mount.stl

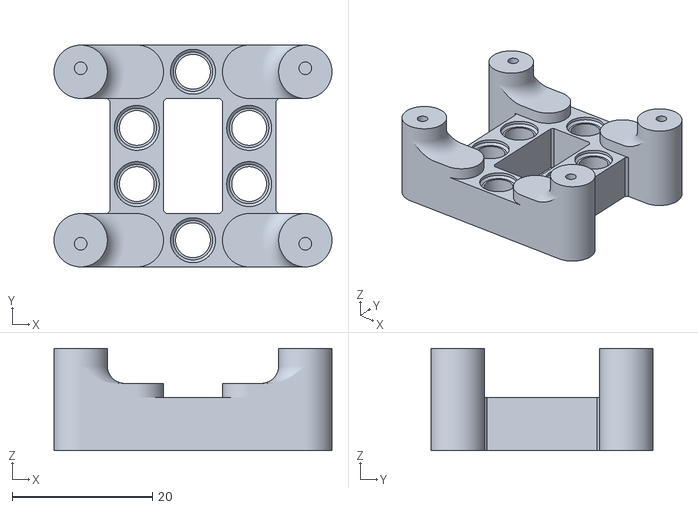
[picture p121: CAD file, 2026-07-24]
assets/models/special/technic/LED-matrix-mount.stl
39.6 x 31.6 x 14.6
