ppatlux/customizer-as-website/assets/models/_mixonly/top_matrix_double-butttons_v2.stl

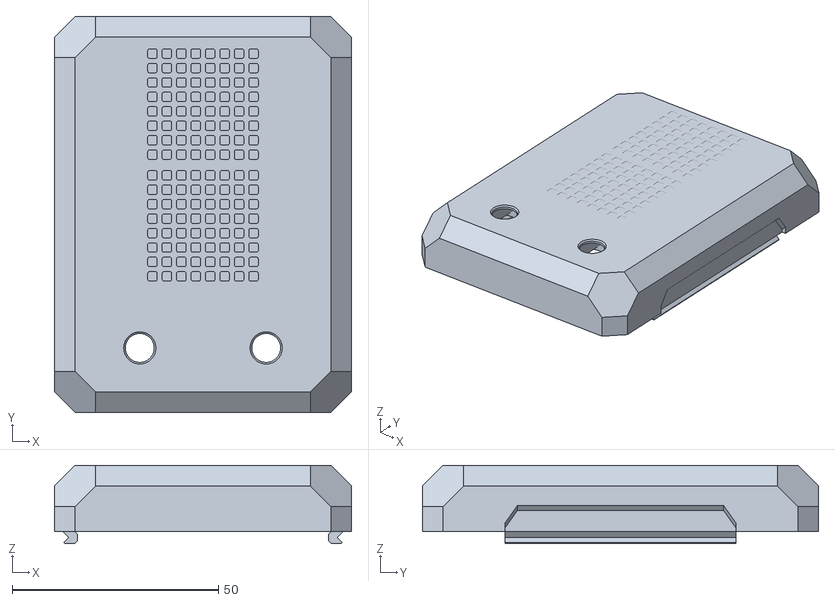
[picture p122: CAD file, 2026-07-15]
assets/models/_mixonly/top_matrix_double-butttons_v2.stl
72.0 x 96.0 x 19.0
