ppatlux/customizer-as-website/assets/models/arms/wing2.stl

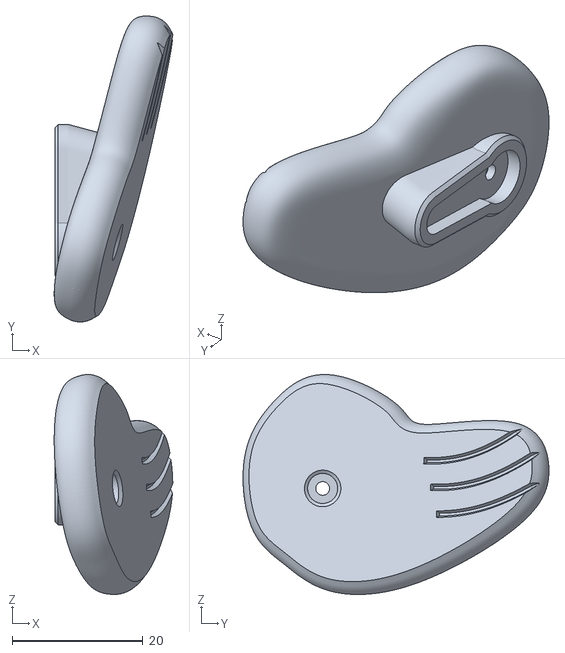
[picture p123: CAD file, 2026-08-17]
assets/models/arms/wing2.stl
18.1 x 46.8 x 33.7
