ppatlux/customizer-as-website/assets/models/bottom/Bottom_extended_v2b.stl

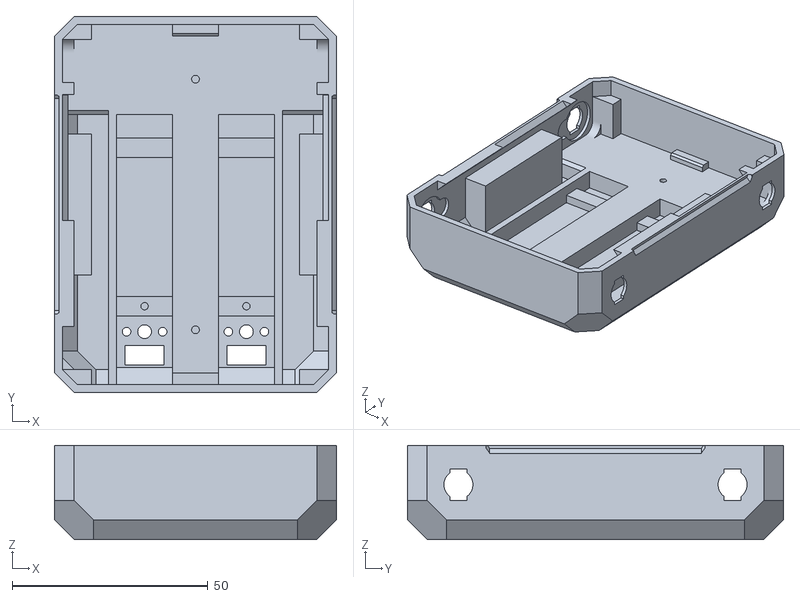
[picture p124: CAD file, 2026-10-27]
assets/models/bottom/Bottom_extended_v2b.stl
72.0 x 96.0 x 24.0
