ppatlux/customizer-as-website/assets/models/bumper/Bumper_Plower.stl

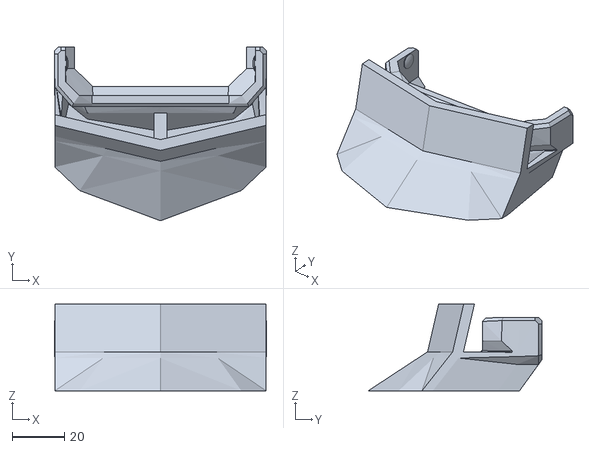
[picture p125: CAD file, 2026-11-04]
assets/models/bumper/Bumper_Plower.stl
80.8 x 66.1 x 33.0
