ppatlux/customizer-as-website/assets/models/bumper/pen/bic-cristal.stl

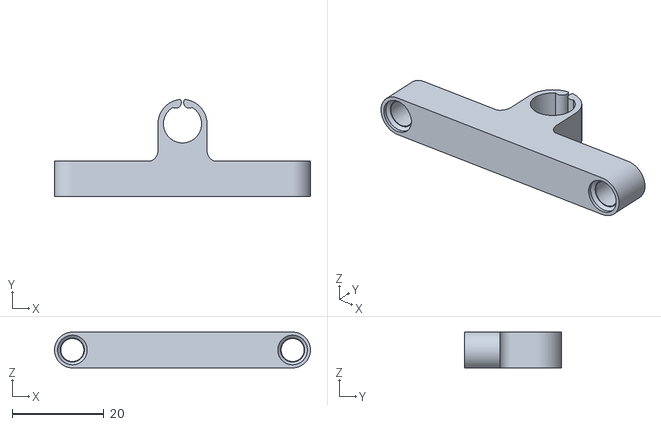
[picture p126: CAD file, 2026-10-27]
assets/models/bumper/pen/bic-cristal.stl
55.8 x 21.2 x 7.80
