ppatlux/customizer-as-website/assets/models/face/Face_Mustache.step

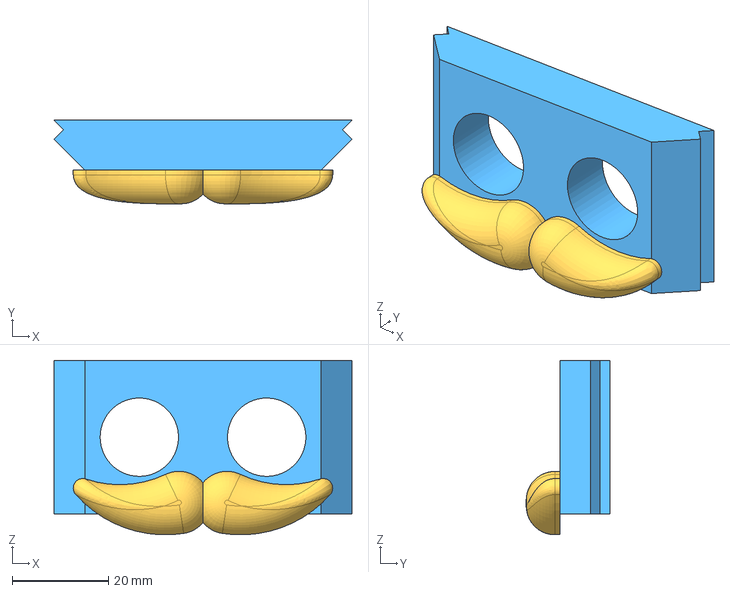
[picture p127: CAD file, 2026-08-28]
assets/models/face/Face_Mustache.step
62.0 x 17.4 x 36.3 mm
