ppatlux/customizer-as-website/assets/models/face/steve/nez.stl

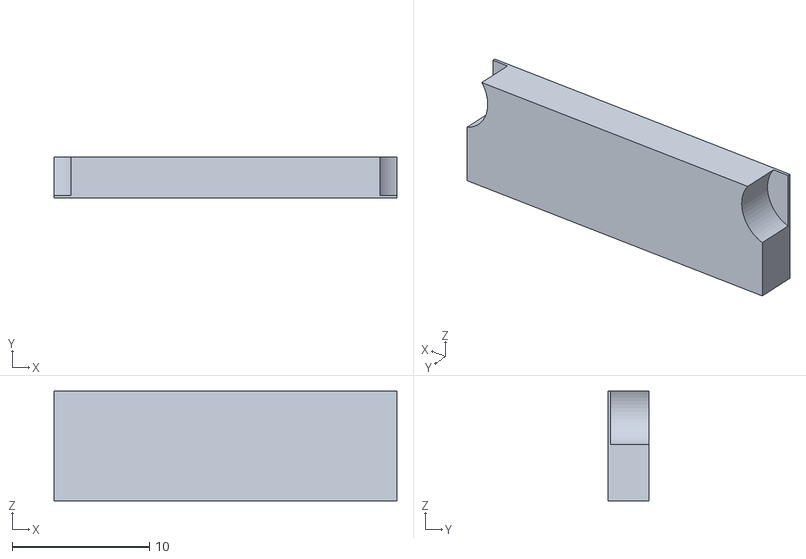
[picture p128: CAD file, 2026-08-17]
assets/models/face/steve/nez.stl
25.0 x 3.00 x 8.00
