ppatlux/customizer-as-website/assets/models/hat/Hat_baseball.stl

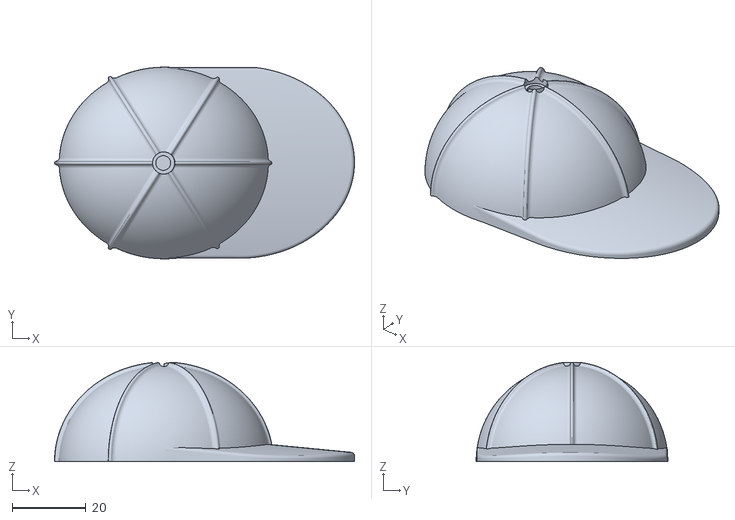
[picture p129: CAD file, 2026-11-04]
assets/models/hat/Hat_baseball.stl
81.4 x 52.0 x 26.9
