ppatlux/customizer-as-website/assets/models/middle/Middle_Firefighter.3mf

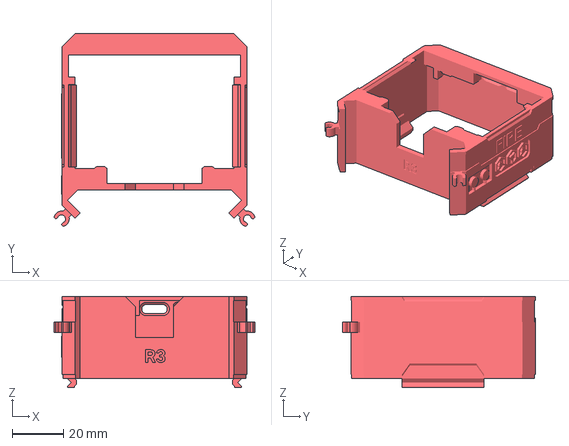
[picture p130: CAD file, 2026-08-31]
assets/models/middle/Middle_Firefighter.3mf
78.4 x 75.2 x 35.5 mm
