ppatlux/customizer-as-website/assets/models/motion/technic/HP_Servo adapter_R1.stl

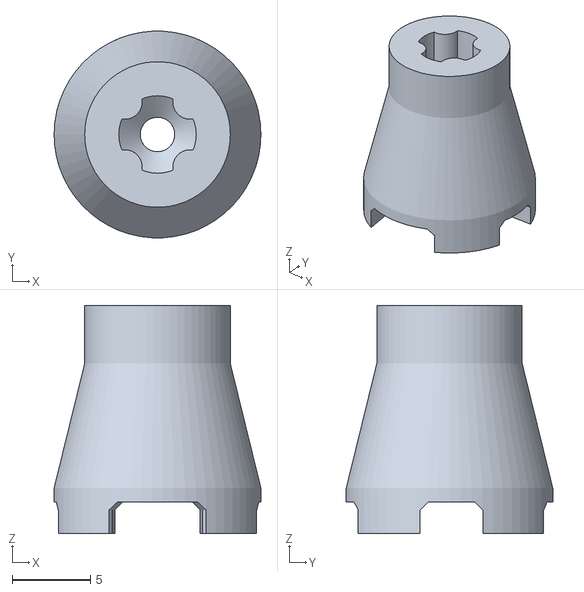
[picture p131: CAD file, 2026-07-15]
assets/models/motion/technic/HP_Servo adapter_R1.stl
13.2 x 13.2 x 14.6
