ppatlux/customizer-as-website/assets/models/motion/tires/4-wheeler-rims.stl

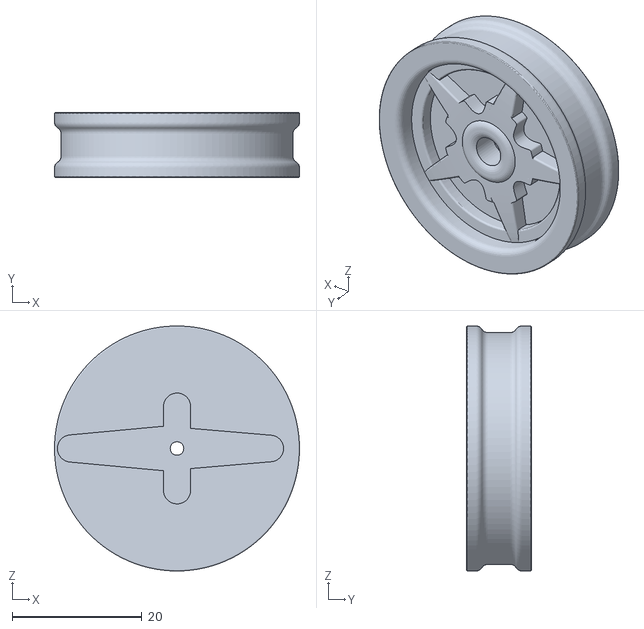
[picture p132: CAD file, 2026-08-17]
assets/models/motion/tires/4-wheeler-rims.stl
37.8 x 10.0 x 37.8
