ppatlux/customizer-as-website/assets/models/motion/walk&roll/HP_MotorLid_R1.stl

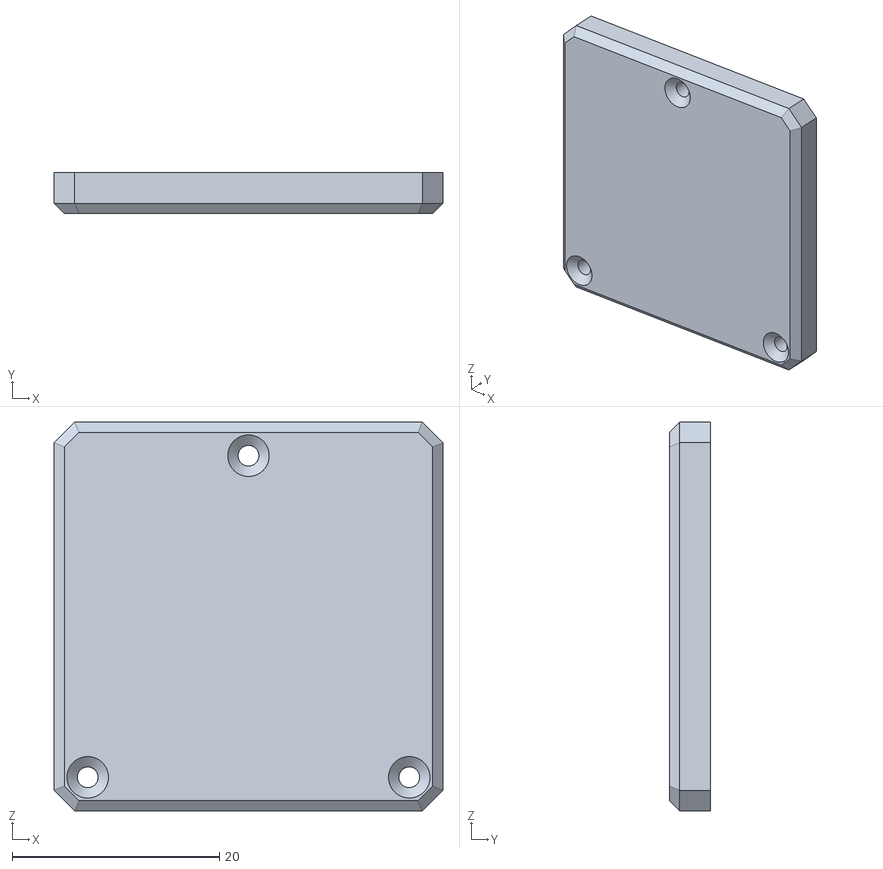
[picture p133: CAD file, 2026-07-15]
assets/models/motion/walk&roll/HP_MotorLid_R1.stl
37.5 x 4.00 x 37.5
