ppatlux/customizer-as-website/assets/models/motion/wheelstarter_f1new.stl

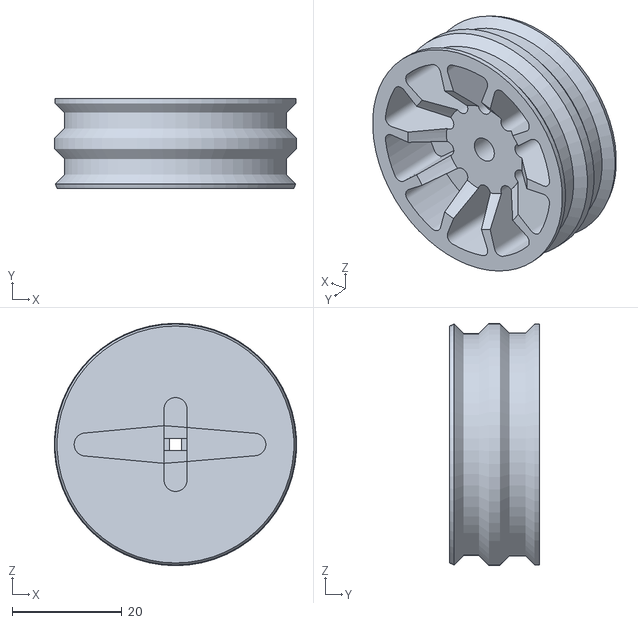
[picture p134: CAD file, 2026-09-22]
assets/models/motion/wheelstarter_f1new.stl
44.1 x 16.5 x 44.1
