ppatlux/customizer-as-website/assets/models/spacer/Spacer_Empty.step

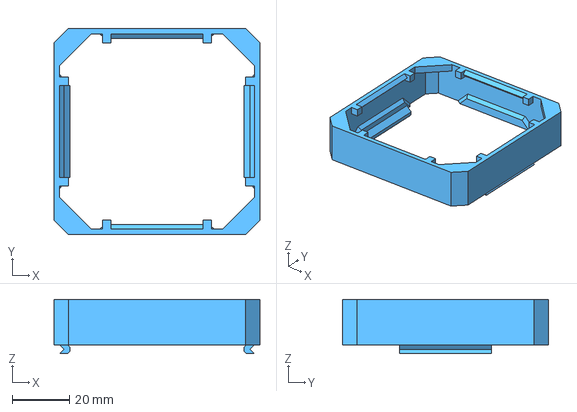
[picture p135: CAD file, 2026-08-17]
assets/models/spacer/Spacer_Empty.step
72.0 x 72.0 x 19.0 mm
