ppatlux/customizer-as-website/assets/models/special/ball/white top.stl

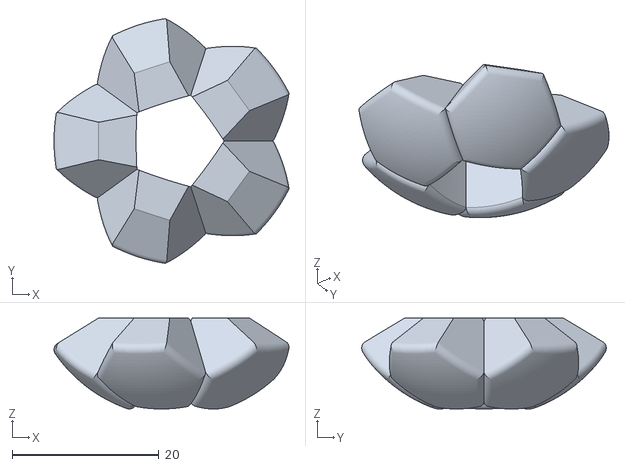
[picture p136: CAD file, 2026-09-22]
assets/models/special/ball/white top.stl
32.0 x 33.3 x 12.4
