ppatlux/customizer-as-website/assets/models/special/helmet/Big 25cm/bottomBIG25cm_v1.3mf

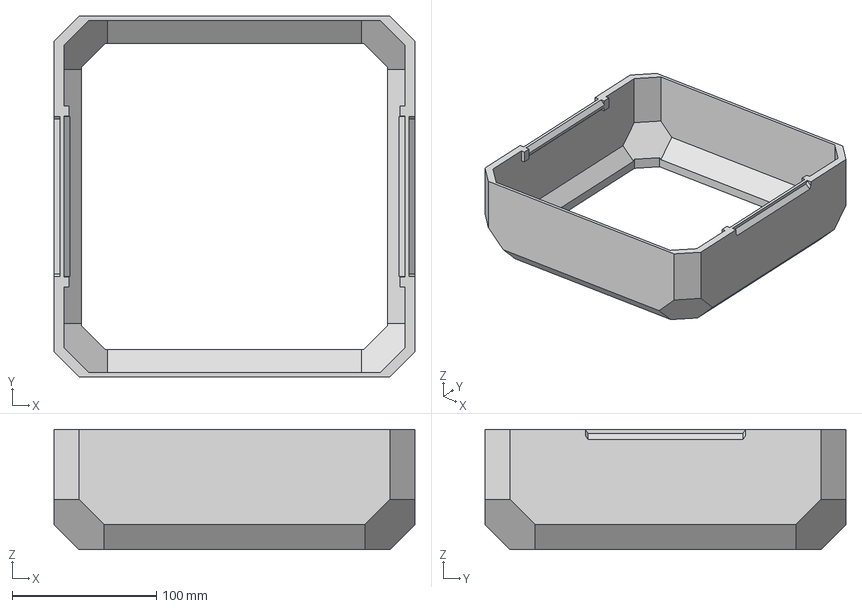
[picture p137: CAD file, 2026-07-24]
assets/models/special/helmet/Big 25cm/bottomBIG25cm_v1.3mf
250.0 x 250.0 x 83.3 mm
