ppatlux/customizer-as-website/assets/models/special/helmet/smallhelmet_middle.stl

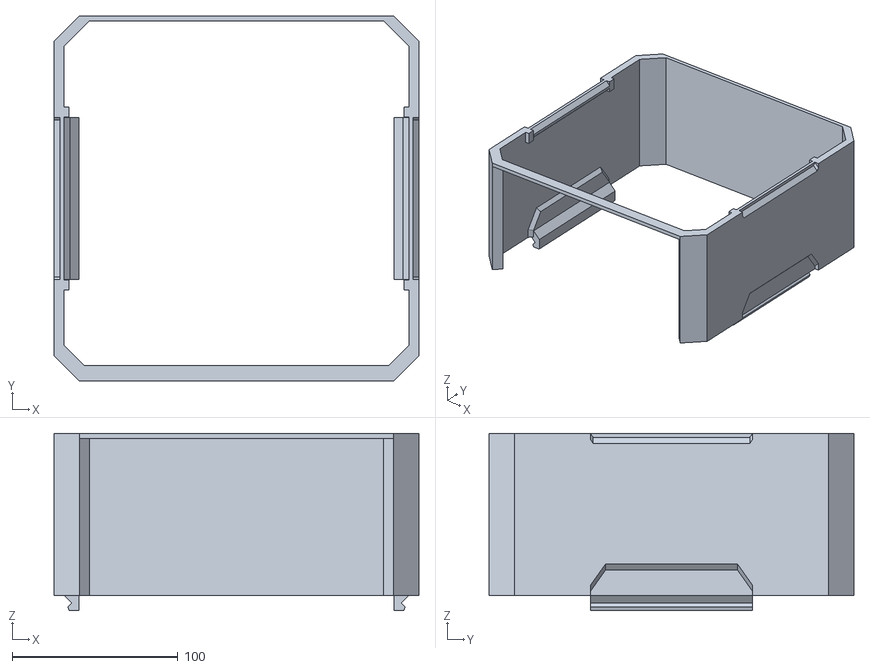
[picture p138: CAD file, 2026-07-24]
assets/models/special/helmet/smallhelmet_middle.stl
220.0 x 220.0 x 106.9
