ppatlux/customizer-as-website/assets/models/special/keychain/keychain_ottobot_R2.stl

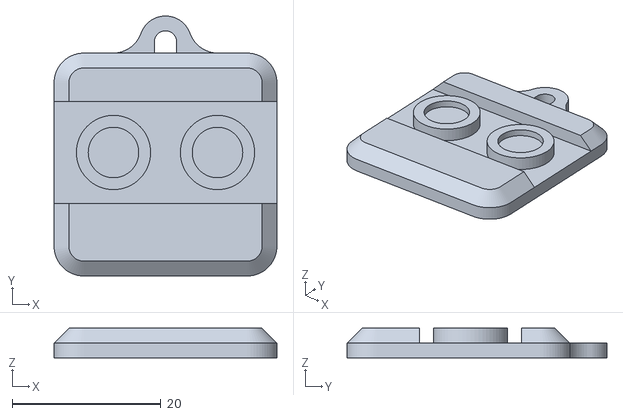
[picture p139: CAD file, 2026-09-22]
assets/models/special/keychain/keychain_ottobot_R2.stl
30.0 x 35.0 x 4.00
