ppatlux/customizer-as-website/assets/models/special/line puzzle/tilecross_v1.stl

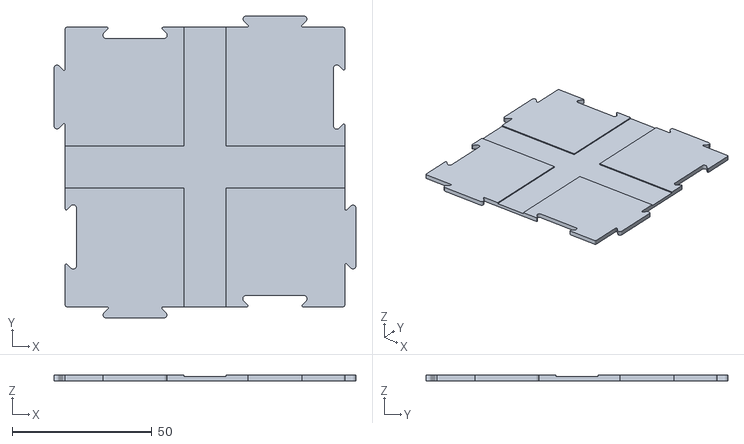
[picture p140: CAD file, 2026-07-24]
assets/models/special/line puzzle/tilecross_v1.stl
107.9 x 107.9 x 2.00
