ppatlux/customizer-as-website/assets/models/special/Otto5/Bottom/bot_track_side_r.stl

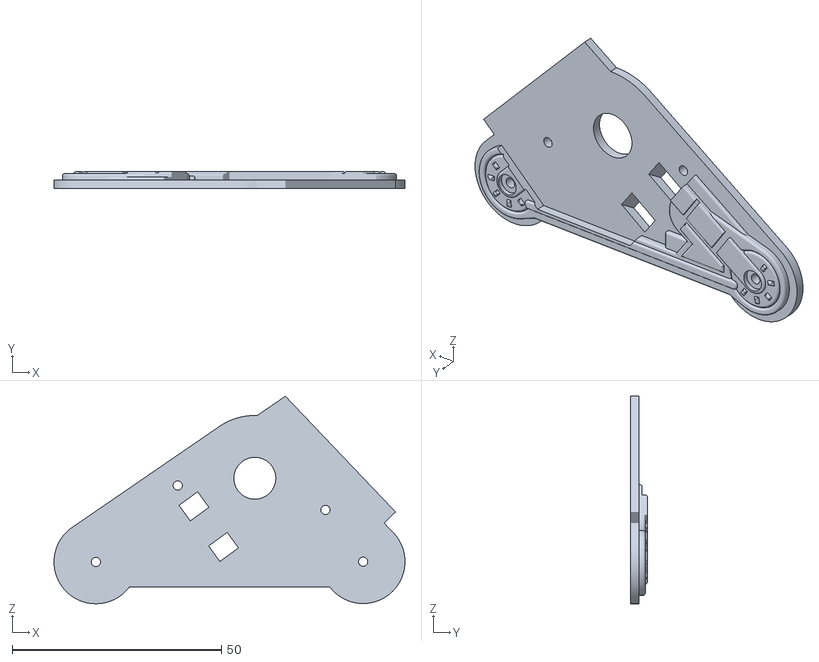
[picture p142: CAD file, 2026-10-27]
assets/models/special/Otto5/Bottom/bot_track_side_r.stl
83.9 x 4.00 x 49.6
