ppatlux/customizer-as-website/assets/models/special/Otto5/STEP Files/bot_track_wheel_large.stp

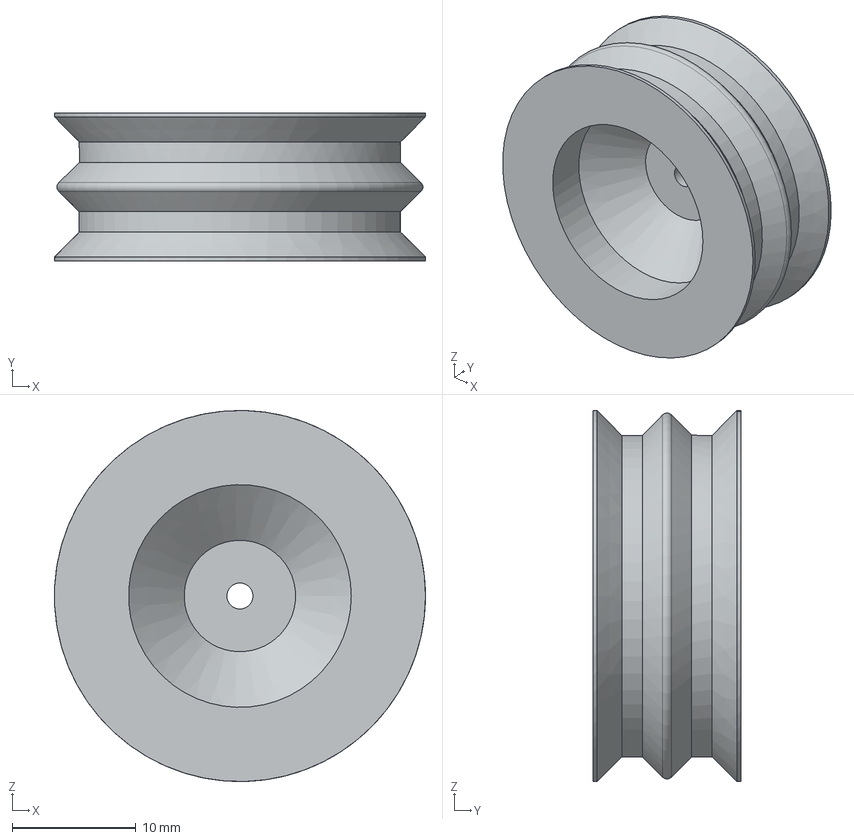
[picture p143: CAD file, 2026-10-27]
assets/models/special/Otto5/STEP Files/bot_track_wheel_large.stp
30.0 x 12.0 x 30.0 mm
