ppatlux/customizer-as-website/assets/models/special/Otto5/Top/top_head_pully_cover_r.stl

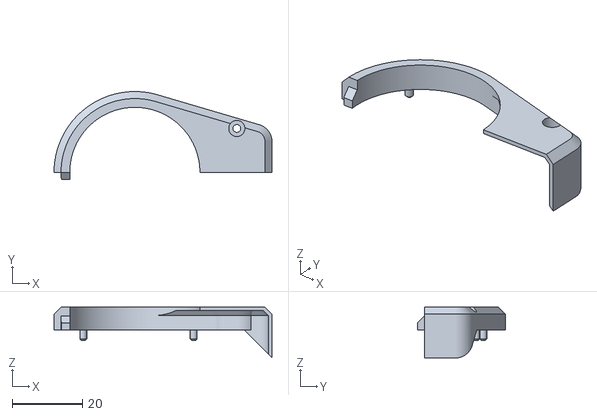
[picture p144: CAD file, 2026-10-27]
assets/models/special/Otto5/Top/top_head_pully_cover_r.stl
62.0 x 25.0 x 14.5
