ppatlux/customizer-as-website/assets/models/special/Otto5/top_acc_nosupports.3mf

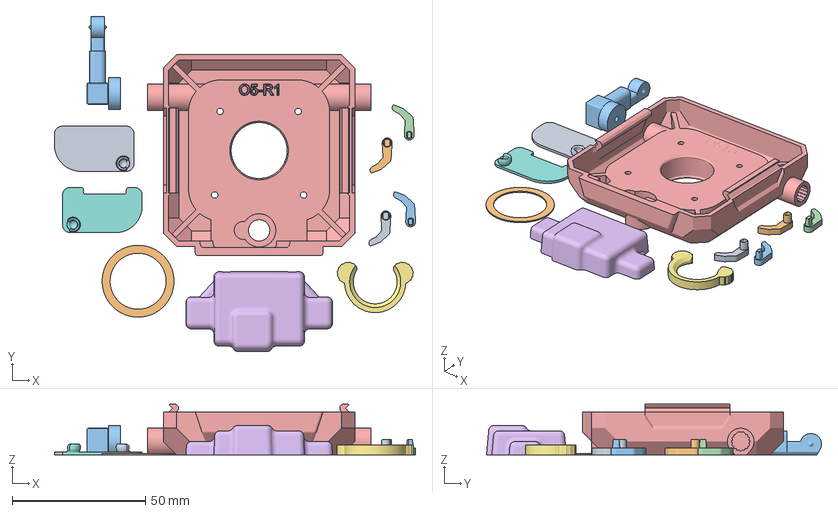
[picture p145: CAD file, 2026-10-27]
assets/models/special/Otto5/top_acc_nosupports.3mf
135.7 x 125.8 x 19.0 mm
Top_arm_vinger_L.stl
Top_arm_vinger_R.stl
Top_base.stl
Top_head_back.stl
Top_head_clip.stl
Top_head_eyebrow_L.stl
Top_head_eyebrow_R.stl
Top_washer_ID21mm.stl
Acc_Toolbox_arm.stl
