ppatlux/customizer-as-website/assets/models/special/OttoButter/3MF (Almost ready to print files)/pass-the-butter_all-body.3mf

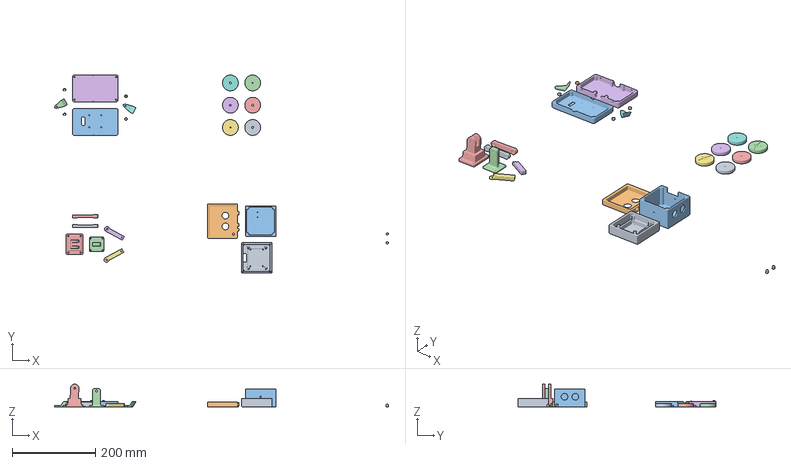
[picture p146: CAD file, 2026-10-27]
assets/models/special/OttoButter/3MF (Almost ready to print files)/pass-the-butter_all-body.3mf
801.9 x 475.9 x 55.0 mm
otto_pass the butter all - ELECTRONICS BASE^hprobots_maincircuitboard-1.STL
otto_pass the butter all - FACE^hprobots_maincircuitboard-1.STL
otto_pass the butter all - HEAD^hprobots_maincircuitboard-1.STL
otto_pass the butter all - hp_wheel_r2-1.STL
otto_pass the butter all - hp_wheel_r2-3.STL
otto_pass the butter all - hp_wheel_r2-4.STL
otto_pass the butter all - hp_wheel_r2-5.STL
otto_pass the butter all - hp_wheel_r2-6.STL
otto_pass the butter all - hp_wheel_r2-7.STL
otto_pass the butter all - LED^hprobots_maincircuitboard-1.STL
otto_pass the butter all - LEG_BOTTOM^hprobots_maincircuitboard-1.STL
otto_pass the butter all - LEG_UPPER^hprobots_maincircuitboard-1.STL
otto_pass the butter all - WHEELS BASE^hprobots_maincircuitboard-1.STL_1
otto_pass the butter all - WHEELS BASE^hprobots_maincircuitboard-1.STL_4
otto_pass the butter all - WHEELS BASE^hprobots_maincircuitboard-1.STL_6
otto_pass the butter all - ARM_L^hprobots_maincircuitboard-2.STL_1
otto_pass the butter all - ARM_L^hprobots_maincircuitboard-2.STL_2
otto_pass the butter all - ARM_L^hprobots_maincircuitboard-2.STL_3
otto_pass the butter all - ARM_L^hprobots_maincircuitboard-1.STL_1
otto_pass the butter all - ARM_L^hprobots_maincircuitboard-1.STL_2
otto_pass the butter all - ARM_L^hprobots_maincircuitboard-1.STL_3
