ppatlux/customizer-as-website/assets/models/special/OttoButter/STL (remember to separate by objects)/base-to-leg.stl

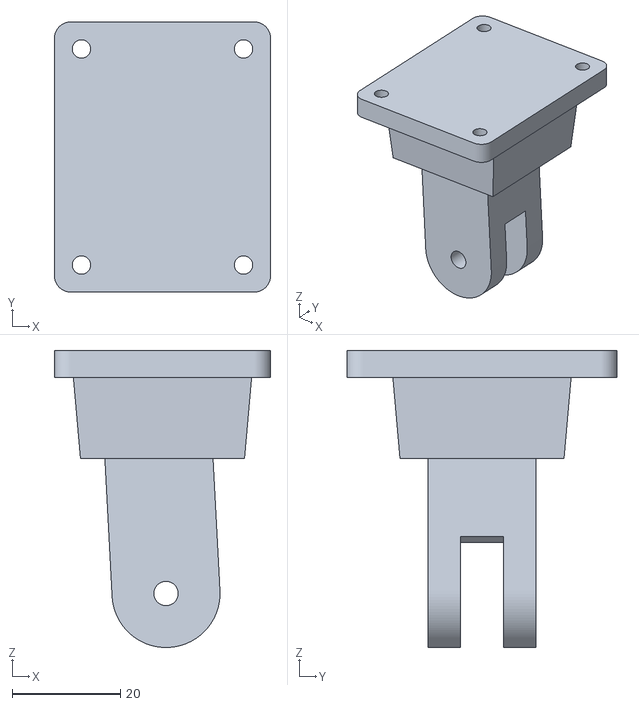
[picture p147: CAD file, 2026-10-27]
assets/models/special/OttoButter/STL (remember to separate by objects)/base-to-leg.stl
40.0 x 50.0 x 55.0
