ppatlux/customizer-as-website/assets/models/special/OttoBuzz/otto-dub-atkinson-logo.stl

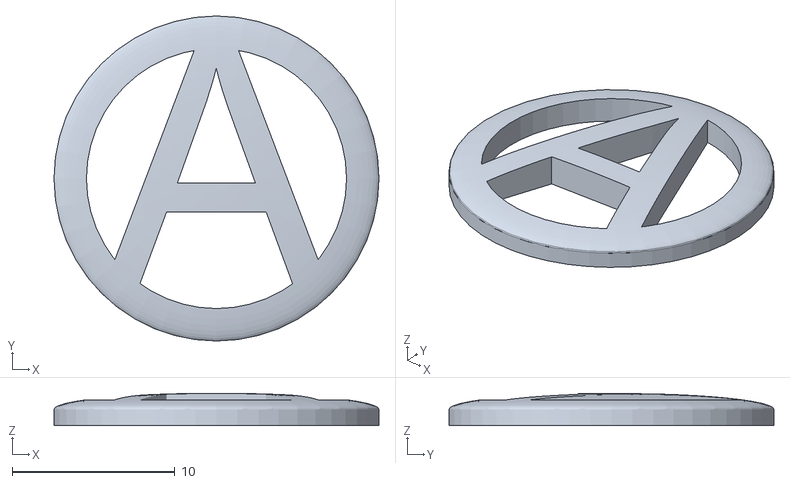
[picture p148: CAD file, 2026-10-27]
assets/models/special/OttoBuzz/otto-dub-atkinson-logo.stl
20.0 x 20.0 x 2.00
