ppatlux/customizer-as-website/assets/models/special/OttoD2/otto-d2-right-leg.stl

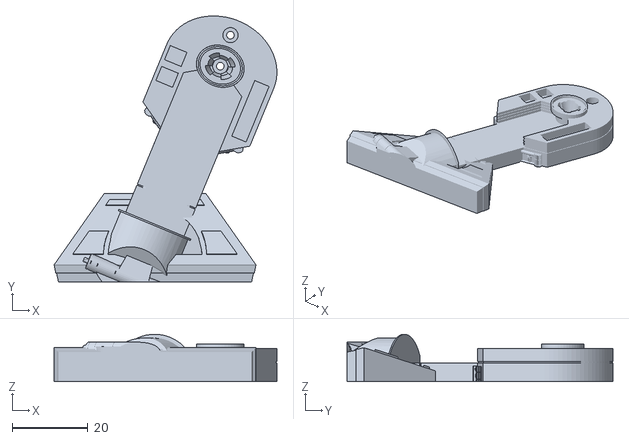
[picture p149: CAD file, 2026-10-27]
assets/models/special/OttoD2/otto-d2-right-leg.stl
58.9 x 70.3 x 12.5
