ppatlux/customizer-as-website/assets/models/special/OttoDino/tail.stl

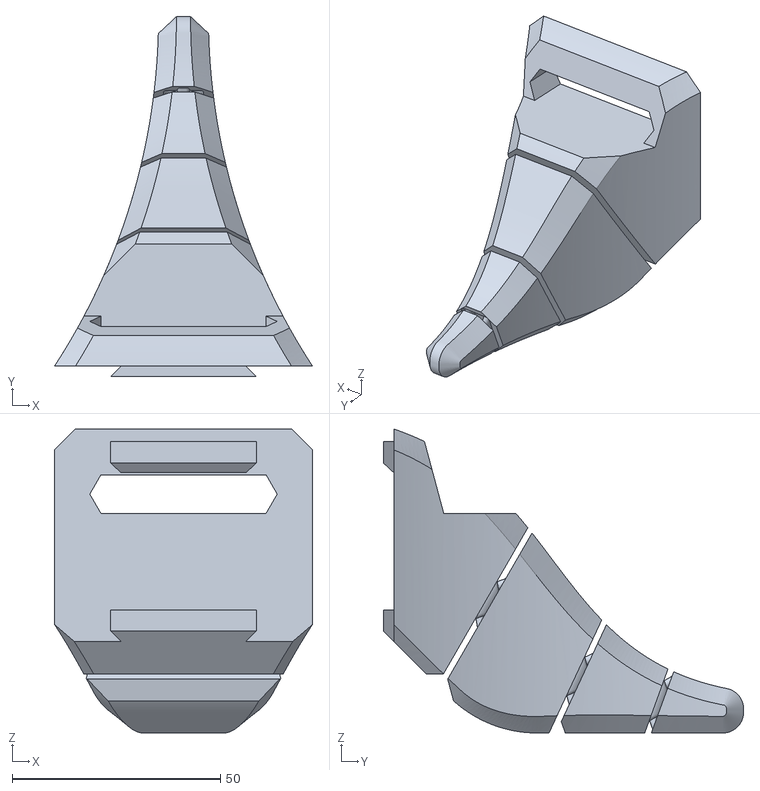
[picture p150: CAD file, 2026-10-27]
assets/models/special/OttoDino/tail.stl
62.0 x 86.5 x 73.0
