ppatlux/customizer-as-website/assets/models/special/OttoExplorer/rockerbogiesystem_diferential.stl

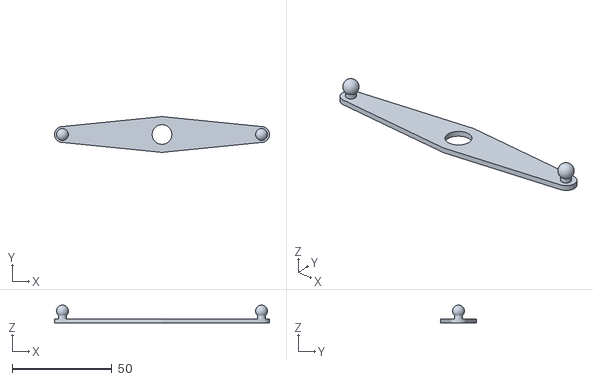
[picture p151: CAD file, 2026-10-27]
assets/models/special/OttoExplorer/rockerbogiesystem_diferential.stl
108.0 x 18.0 x 9.00
