ppatlux/customizer-as-website/assets/models/special/OttoJr/3-wheel-chasis.3mf

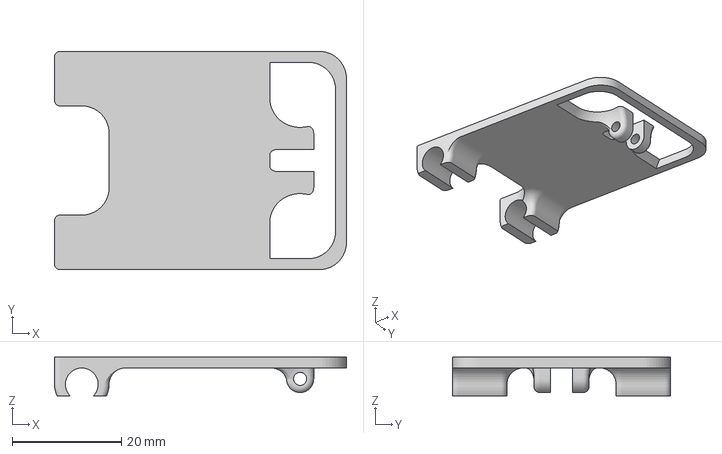
[picture p152: CAD file, 2026-10-27]
assets/models/special/OttoJr/3-wheel-chasis.3mf
53.5 x 40.0 x 7.13 mm
