ppatlux/customizer-as-website/assets/models/special/OttoN/01 Part Set/inner_frame.stl

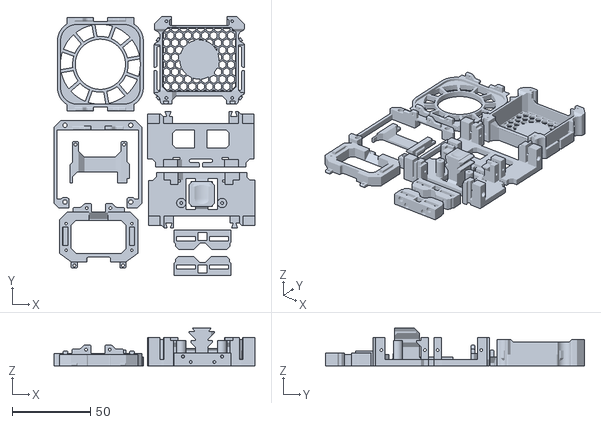
[picture p153: CAD file, 2026-10-27]
assets/models/special/OttoN/01 Part Set/inner_frame.stl
128.3 x 165.3 x 23.9
