ppatlux/customizer-as-website/assets/models/special/OttoN/02 Inner Frame/led_grid.stl

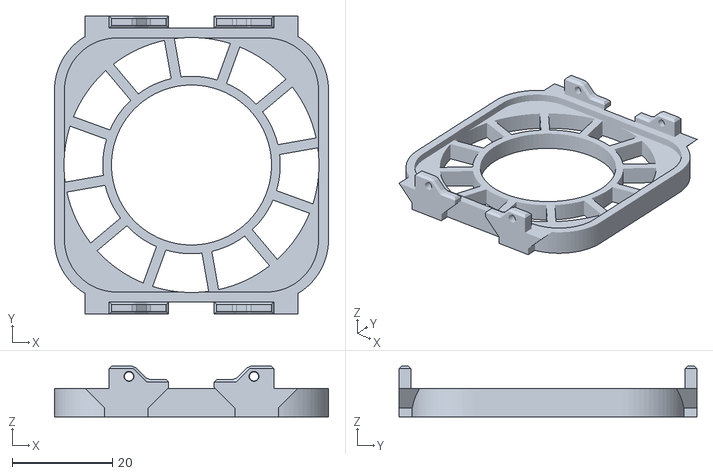
[picture p154: CAD file, 2026-10-27]
assets/models/special/OttoN/02 Inner Frame/led_grid.stl
54.8 x 59.5 x 10.2
