ppatlux/customizer-as-website/assets/models/special/OttoN/03 Outer Frame/horizontal_frame.stl

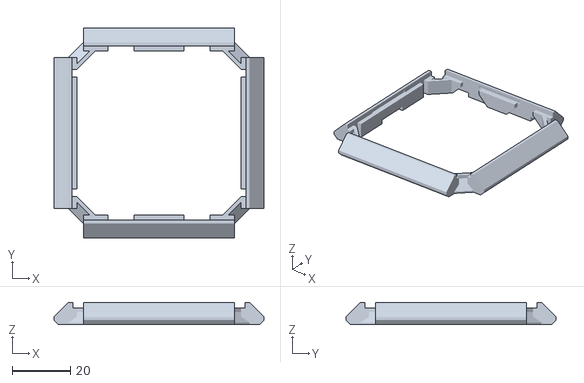
[picture p155: CAD file, 2026-10-27]
assets/models/special/OttoN/03 Outer Frame/horizontal_frame.stl
72.0 x 72.0 x 7.70
