ppatlux/customizer-as-website/assets/models/special/OttoN/04 Panels/side_plate_lh.stl

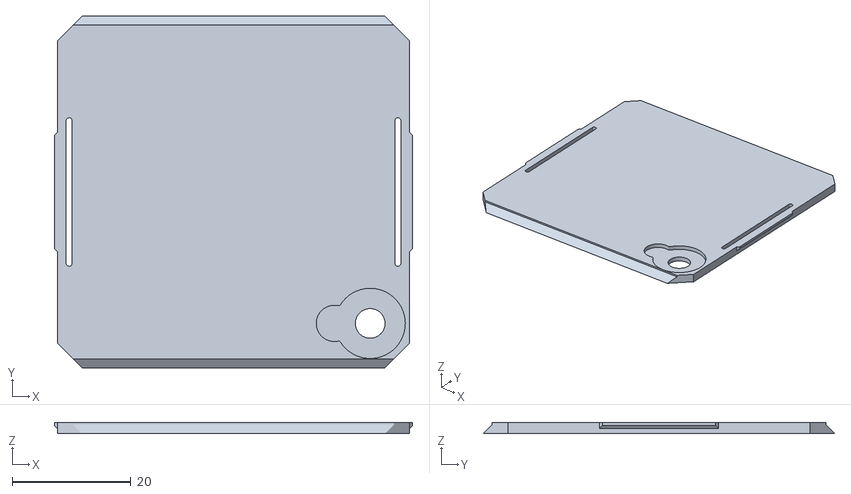
[picture p156: CAD file, 2026-10-27]
assets/models/special/OttoN/04 Panels/side_plate_lh.stl
60.3 x 59.2 x 1.90
