ppatlux/customizer-as-website/assets/models/special/OttoTruck/print-2-updated-v1.3mf

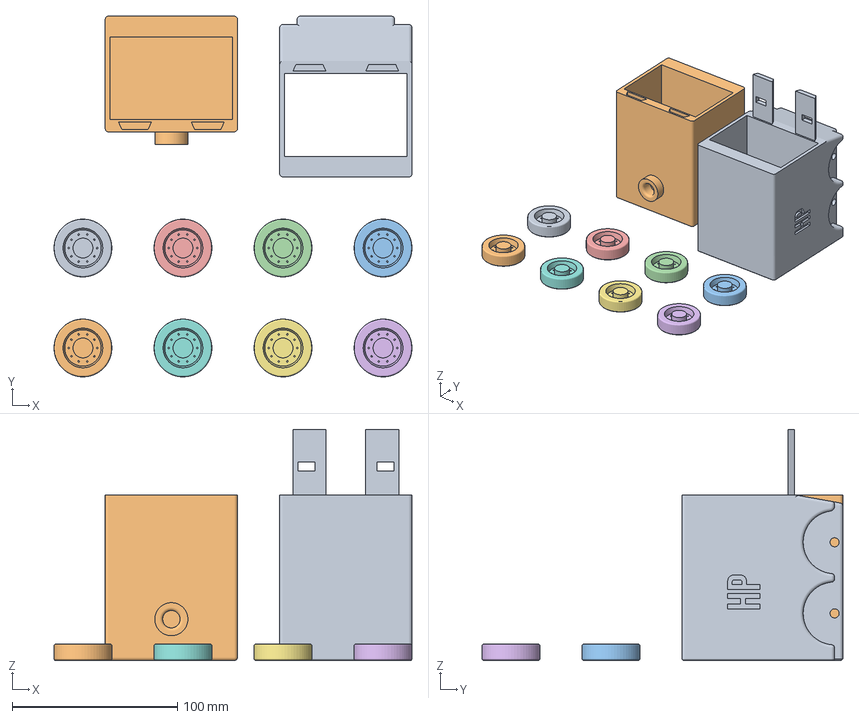
[picture p157: CAD file, 2026-10-27]
assets/models/special/OttoTruck/print-2-updated-v1.3mf
216.4 x 218.1 x 139.7 mm
Trailer - Part 2 (4).stl
Trailer - Part 1 (4).stl
Wheel-Back - Part 1 (3).stl x 8
