ppatlux/customizer-as-website/assets/models/special/OttoUnit01/BODY/body_clip_tank.stl

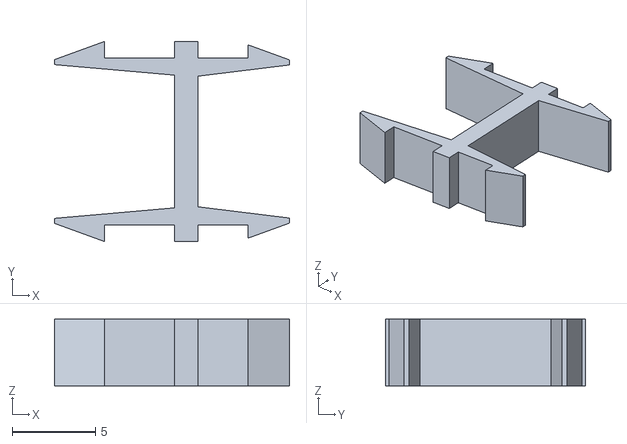
[picture p158: CAD file, 2026-10-27]
assets/models/special/OttoUnit01/BODY/body_clip_tank.stl
14.1 x 12.0 x 4.00
