ppatlux/customizer-as-website/assets/models/special/OttoUnit01/HEAD/head_middle.stl

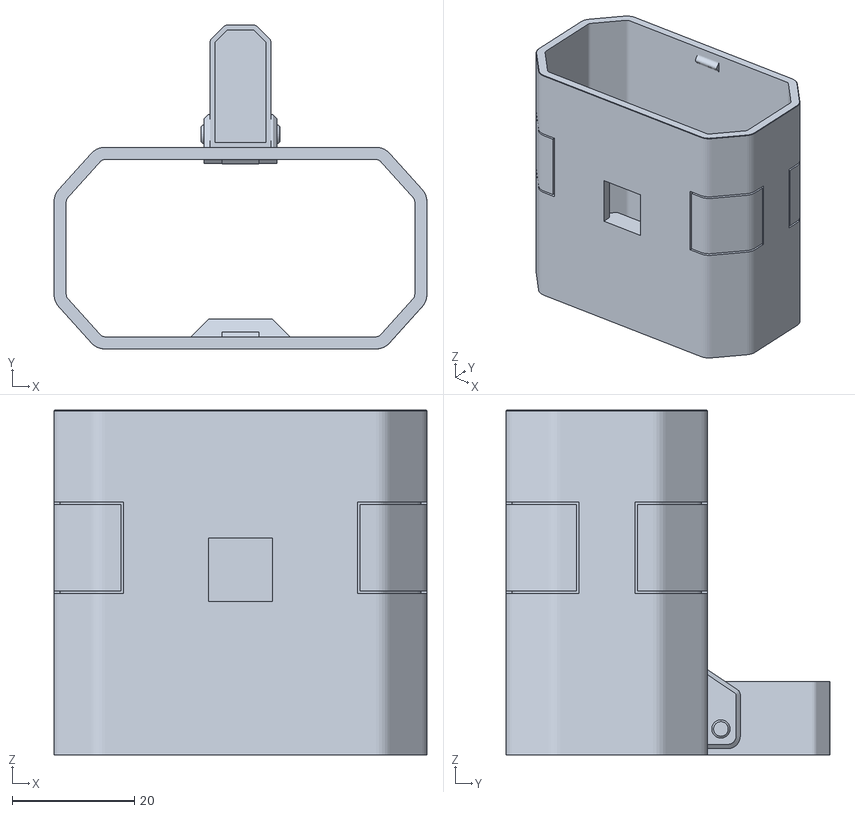
[picture p159: CAD file, 2026-10-27]
assets/models/special/OttoUnit01/HEAD/head_middle.stl
61.0 x 53.0 x 56.4
