ppatlux/customizer-as-website/assets/models/special/OttoUnit01/STEP Files/otto_head_front_insert.step

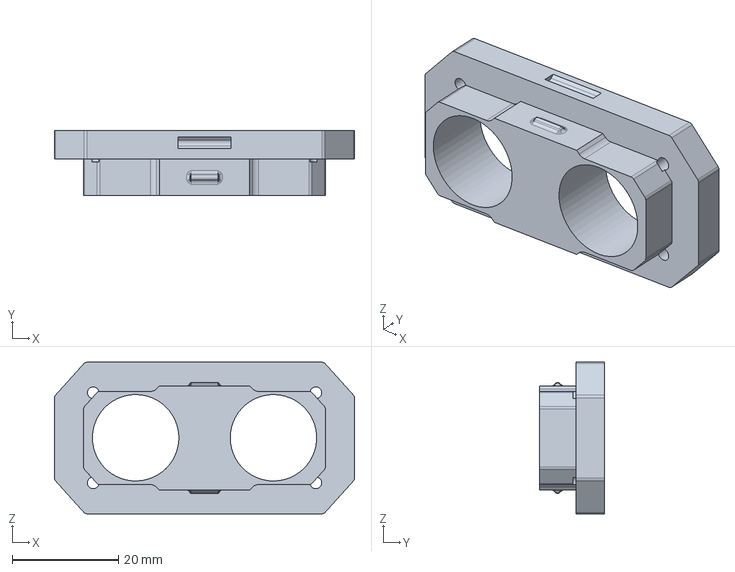
[picture p160: CAD file, 2026-10-27]
assets/models/special/OttoUnit01/STEP Files/otto_head_front_insert.step
56.6 x 12.4 x 28.6 mm
