ppatlux/customizer-as-website/assets/models/special/OttoUnit01/TILT-PAN MECHANISM/tilt_pan_bottom.stl

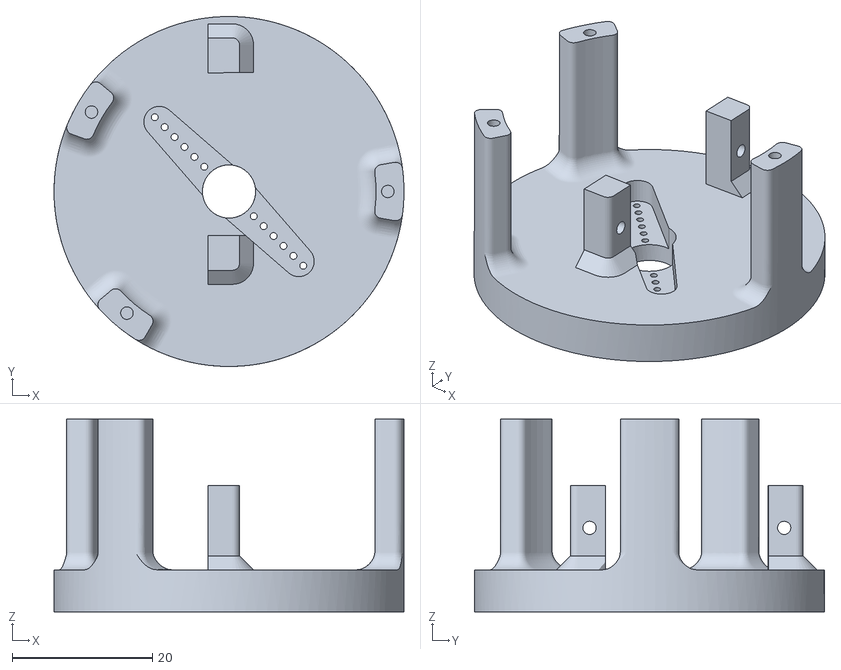
[picture p161: CAD file, 2026-10-27]
assets/models/special/OttoUnit01/TILT-PAN MECHANISM/tilt_pan_bottom.stl
50.0 x 50.0 x 27.5
