ppatlux/customizer-as-website/assets/models/special/OttoUnit01/WHEELBASE/wheels_front.stl

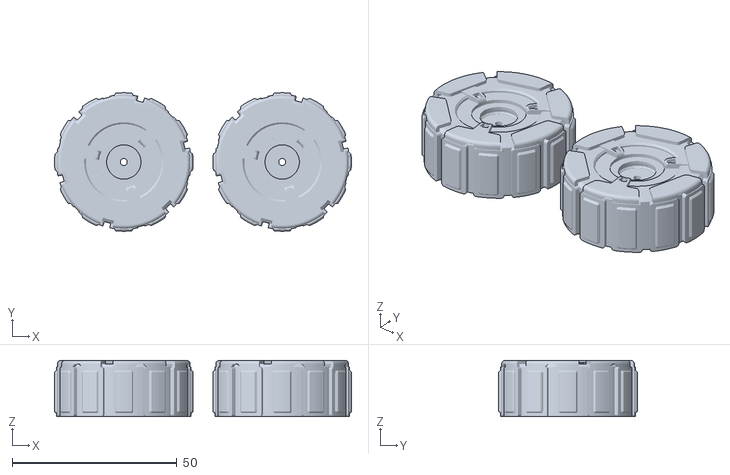
[picture p162: CAD file, 2026-10-27]
assets/models/special/OttoUnit01/WHEELBASE/wheels_front.stl
90.0 x 42.0 x 17.0
