ppatlux/customizer-as-website/assets/models/special/props/fidget-spinner-helical-gear.stl

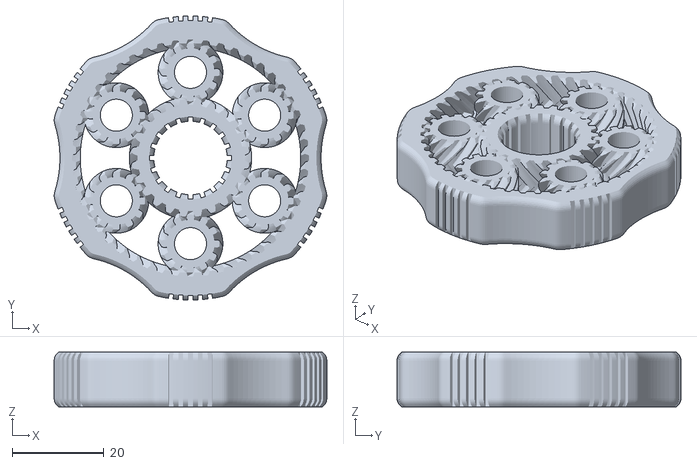
[picture p163: CAD file, 2026-08-25]
assets/models/special/props/fidget-spinner-helical-gear.stl
59.5 x 62.0 x 12.0
