ppatlux/customizer-as-website/assets/models/special/soccer field/tile_corner_v1 .stl

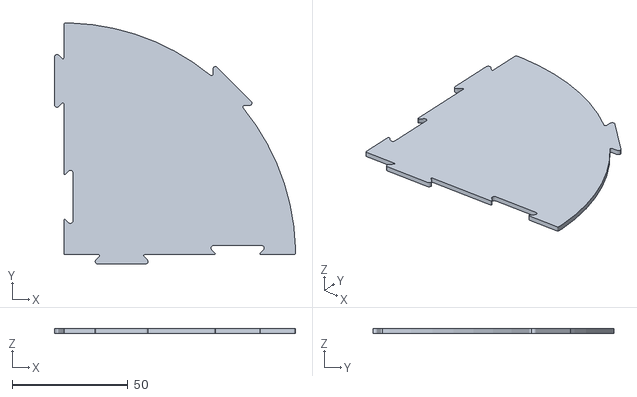
[picture p164: CAD file, 2026-07-24]
assets/models/special/soccer field/tile_corner_v1 .stl
103.9 x 103.9 x 2.00
