ppatlux/customizer-as-website/assets/models/special/starter/JSTtool.stl

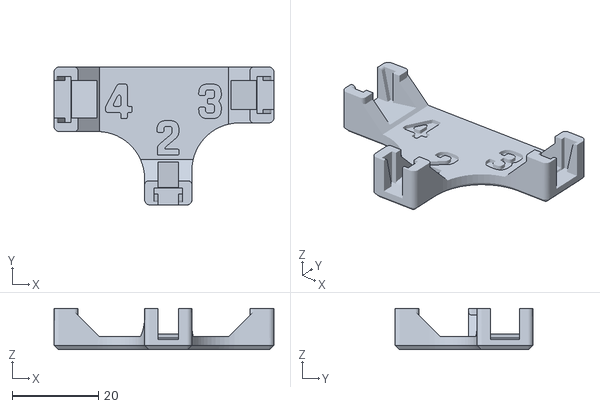
[picture p165: CAD file, 2026-08-24]
assets/models/special/starter/JSTtool.stl
51.1 x 32.1 x 9.56
