ppatlux/customizer-as-website/assets/models/special/technic/PCB-mount.stl

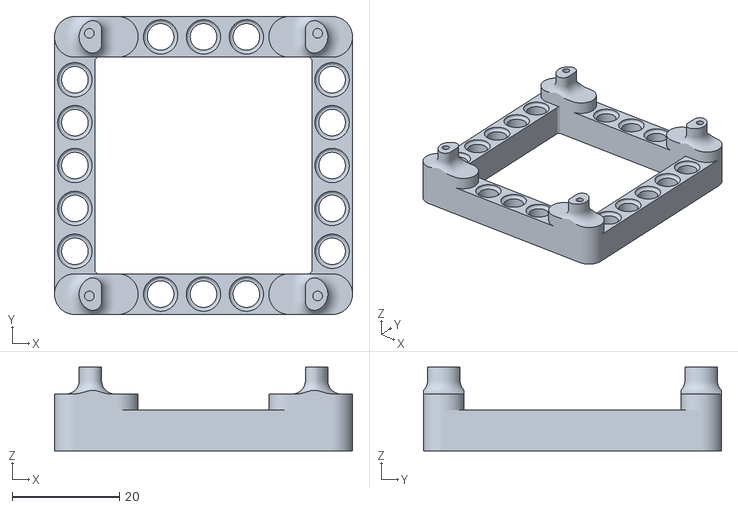
[picture p166: CAD file, 2026-07-24]
assets/models/special/technic/PCB-mount.stl
55.6 x 55.6 x 15.6
