ppatlux/customizer-as-website/assets/models/top/otto_top_lego.3mf

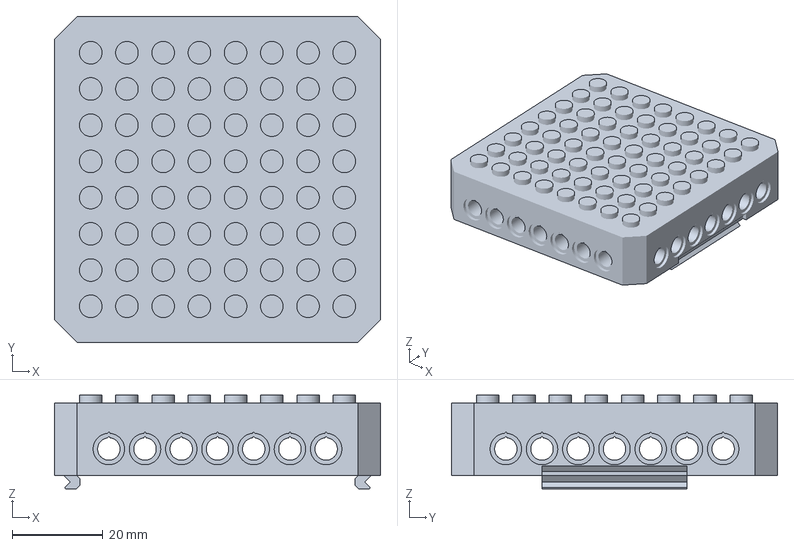
[picture p167: CAD file, 2026-08-25]
assets/models/top/otto_top_lego.3mf
72.0 x 72.0 x 20.7 mm
