ppatlux/customizer-as-website/assets/models/_mixonly/cube-frame.stl

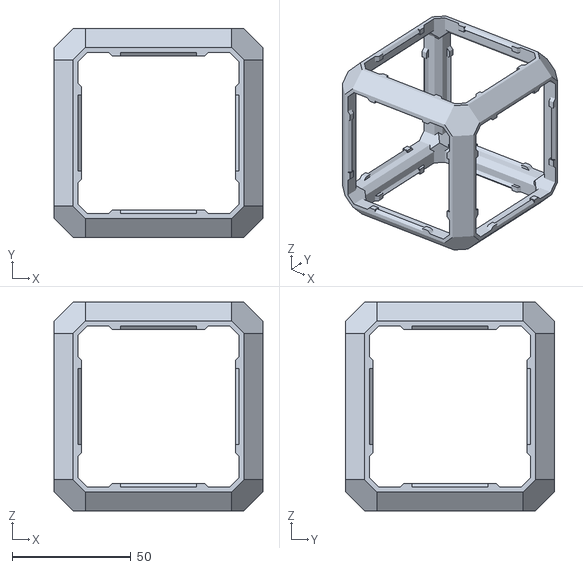
[picture p168: CAD file, 2026-07-15]
assets/models/_mixonly/cube-frame.stl
88.0 x 88.0 x 88.0
