ppatlux/customizer-as-website/assets/models/bumper/Bumper_Bulldozer.stl

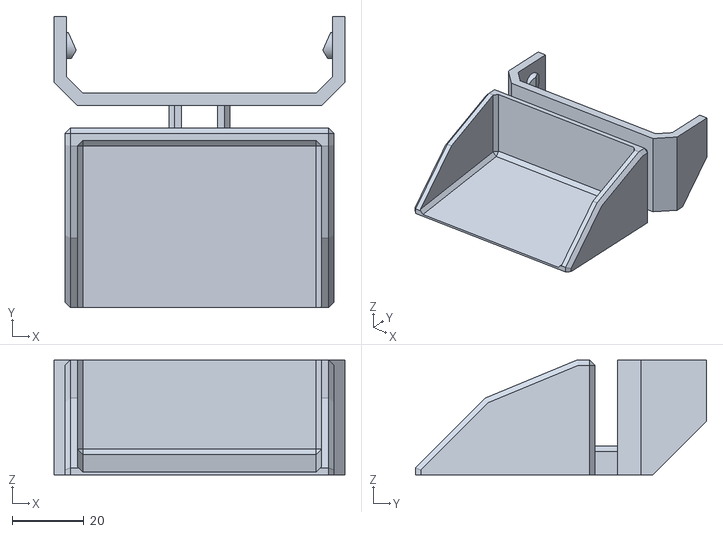
[picture p169: CAD file, 2026-11-04]
assets/models/bumper/Bumper_Bulldozer.stl
81.0 x 81.1 x 32.0
