ppatlux/customizer-as-website/assets/models/bumper/pen/pc-1m.stl

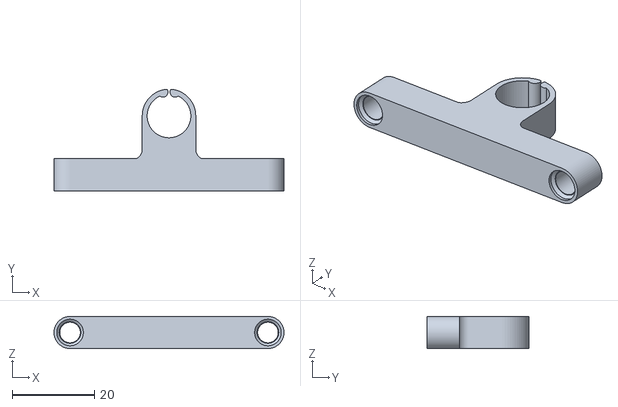
[picture p170: CAD file, 2026-10-27]
assets/models/bumper/pen/pc-1m.stl
55.8 x 24.6 x 7.80
