ppatlux/customizer-as-website/assets/models/face/FaceUSflatsimple_v3.stl

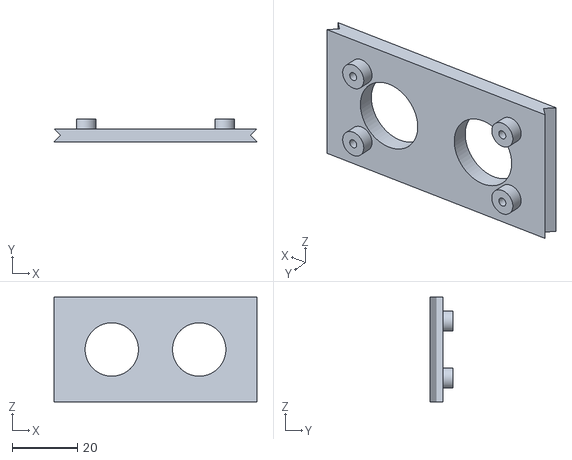
[picture p171: CAD file, 2026-08-25]
assets/models/face/FaceUSflatsimple_v3.stl
62.0 x 7.00 x 32.0
