ppatlux/customizer-as-website/assets/models/face/steve/oeil-gauche.stl

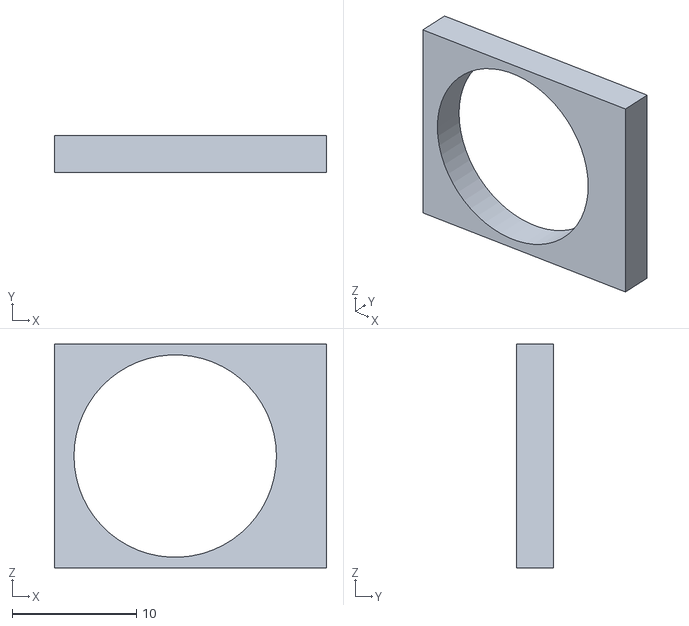
[picture p172: CAD file, 2026-08-17]
assets/models/face/steve/oeil-gauche.stl
21.9 x 3.00 x 18.0
