ppatlux/customizer-as-website/assets/models/hat/Hat_cap.stl

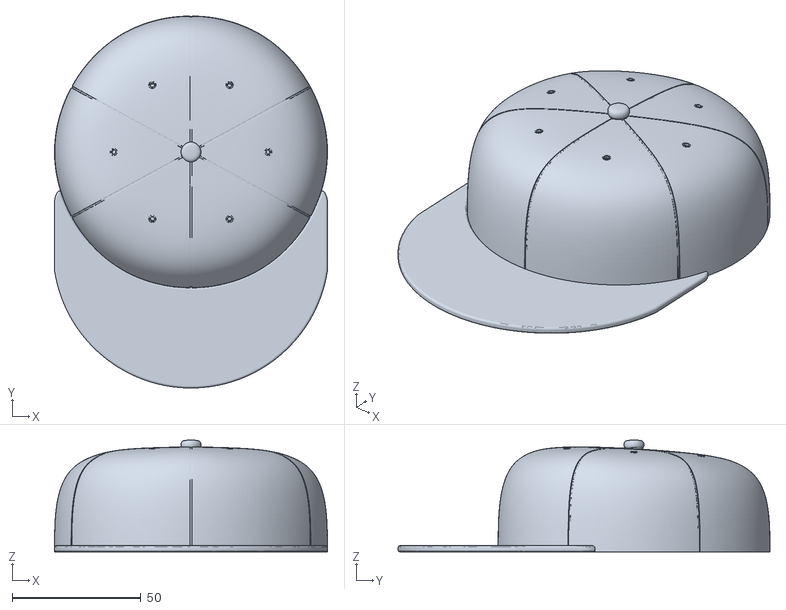
[picture p173: CAD file, 2026-11-04]
assets/models/hat/Hat_cap.stl
105.8 x 144.2 x 43.3
