ppatlux/customizer-as-website/assets/models/middle/Middle_Space.3mf

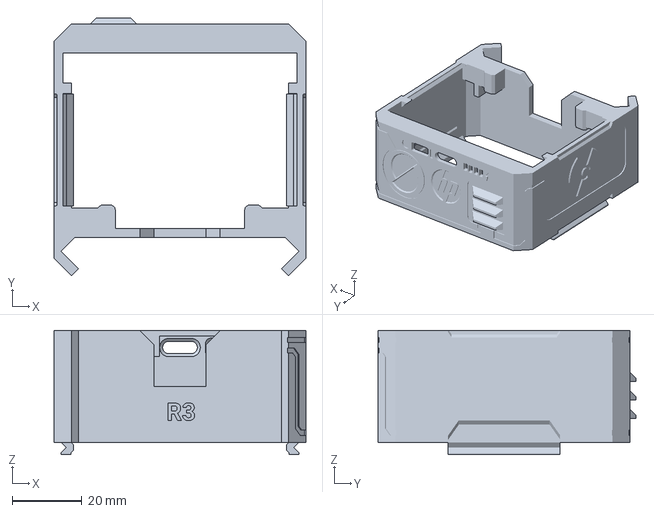
[picture p174: CAD file, 2026-08-31]
assets/models/middle/Middle_Space.3mf
72.0 x 73.6 x 35.5 mm
