ppatlux/customizer-as-website/assets/models/motion/omni3-wheel-adaptor.stl

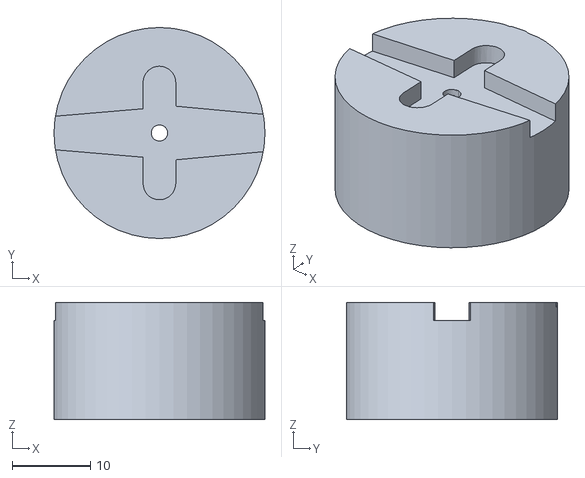
[picture p175: CAD file, 2026-08-17]
assets/models/motion/omni3-wheel-adaptor.stl
27.0 x 27.0 x 15.0
