ppatlux/customizer-as-website/assets/models/motion/technic/HP_SpacerA external_R1.stl

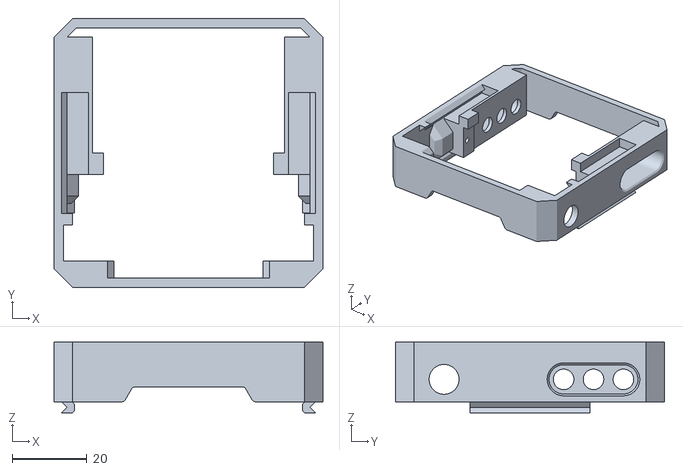
[picture p176: CAD file, 2026-07-15]
assets/models/motion/technic/HP_SpacerA external_R1.stl
72.0 x 72.0 x 19.0
