ppatlux/customizer-as-website/assets/models/motion/walk&roll/HP_BalanceBar_R1.stl

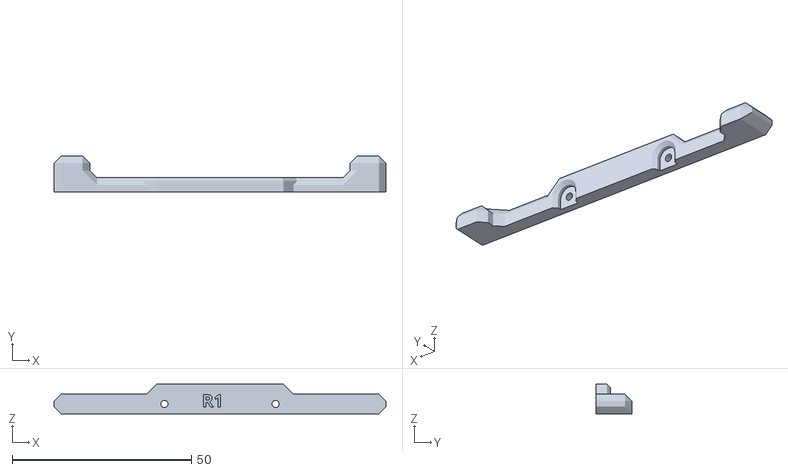
[picture p177: CAD file, 2026-07-15]
assets/models/motion/walk&roll/HP_BalanceBar_R1.stl
92.6 x 10.0 x 8.25
