ppatlux/customizer-as-website/assets/models/spacer/Spacer_Sensors.step

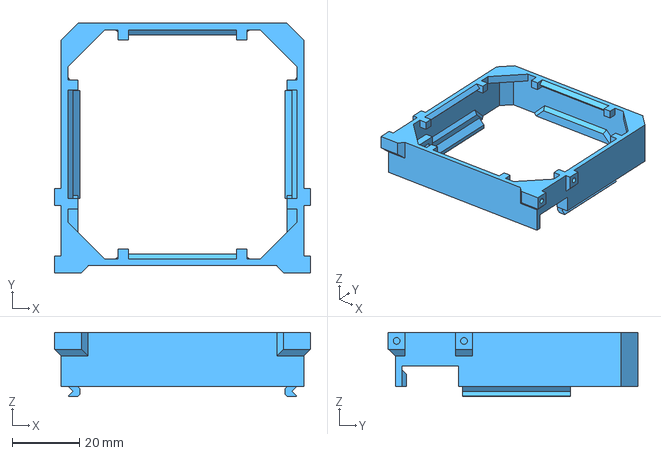
[picture p178: CAD file, 2026-08-17]
assets/models/spacer/Spacer_Sensors.step
76.0 x 74.1 x 19.0 mm
