ppatlux/customizer-as-website/assets/models/special/ball/black.stl

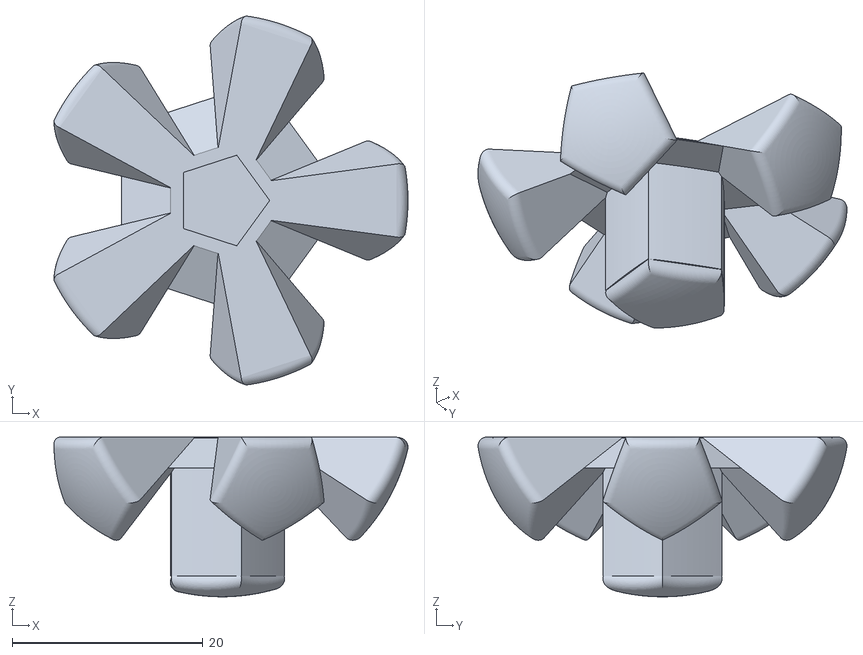
[picture p179: CAD file, 2026-09-22]
assets/models/special/ball/black.stl
37.1 x 38.7 x 16.7
