ppatlux/customizer-as-website/assets/models/special/controller/Bottom_puzzle_PCB.stl

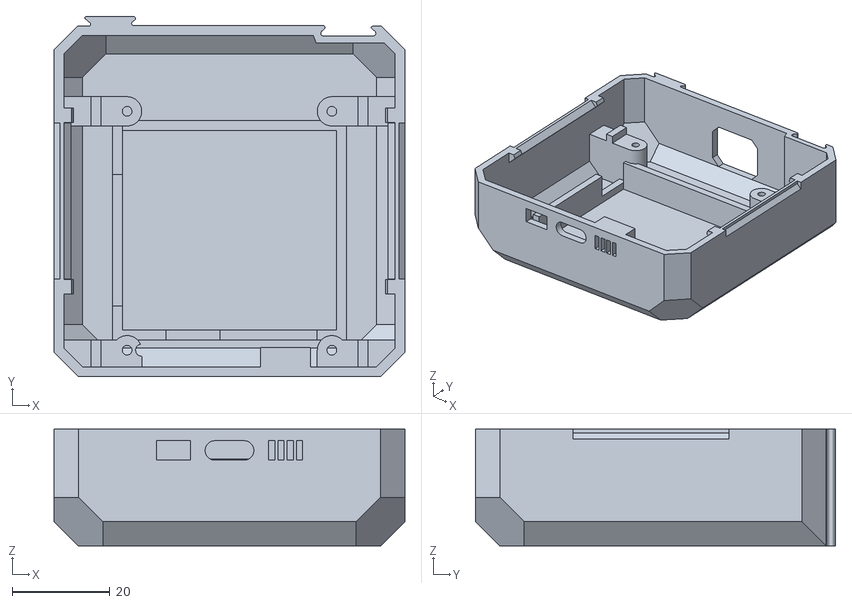
[picture p180: CAD file, 2026-07-15]
assets/models/special/controller/Bottom_puzzle_PCB.stl
72.0 x 73.8 x 24.0
