ppatlux/customizer-as-website/assets/models/special/helmet/Big 25cm/faceBIG25cm_v2.stl

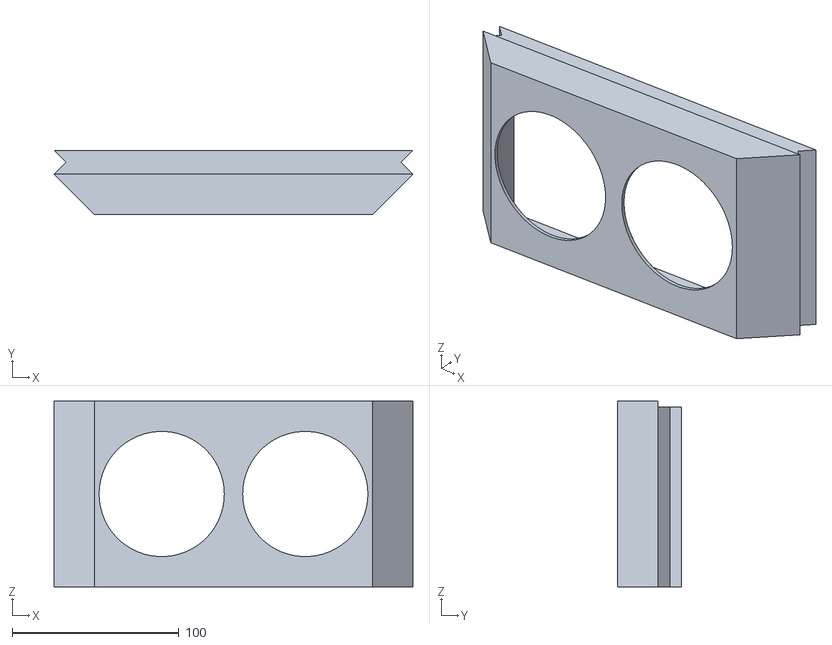
[picture p181: CAD file, 2026-07-24]
assets/models/special/helmet/Big 25cm/faceBIG25cm_v2.stl
215.0 x 38.2 x 111.1
