ppatlux/customizer-as-website/assets/models/special/helmet/smallhelmet_top.stl

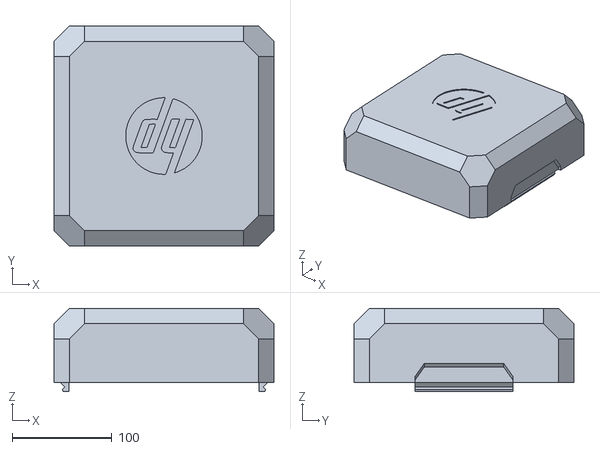
[picture p182: CAD file, 2026-07-24]
assets/models/special/helmet/smallhelmet_top.stl
220.0 x 220.0 x 83.3
