ppatlux/customizer-as-website/assets/models/special/keychain/keymid_v2.stl

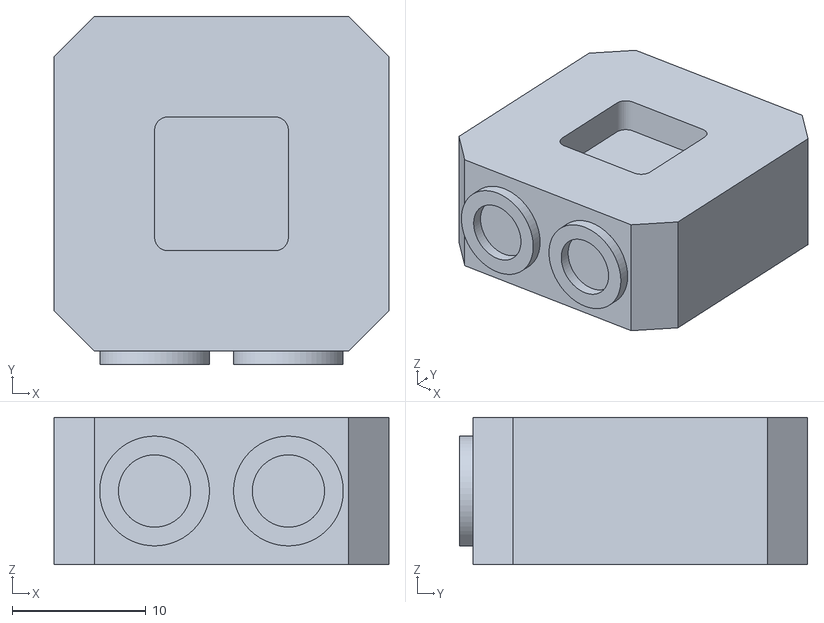
[picture p183: CAD file, 2026-07-24]
assets/models/special/keychain/keymid_v2.stl
25.0 x 26.0 x 11.0
