ppatlux/customizer-as-website/assets/models/special/line puzzle/trackcurvestraightR_v1.stl

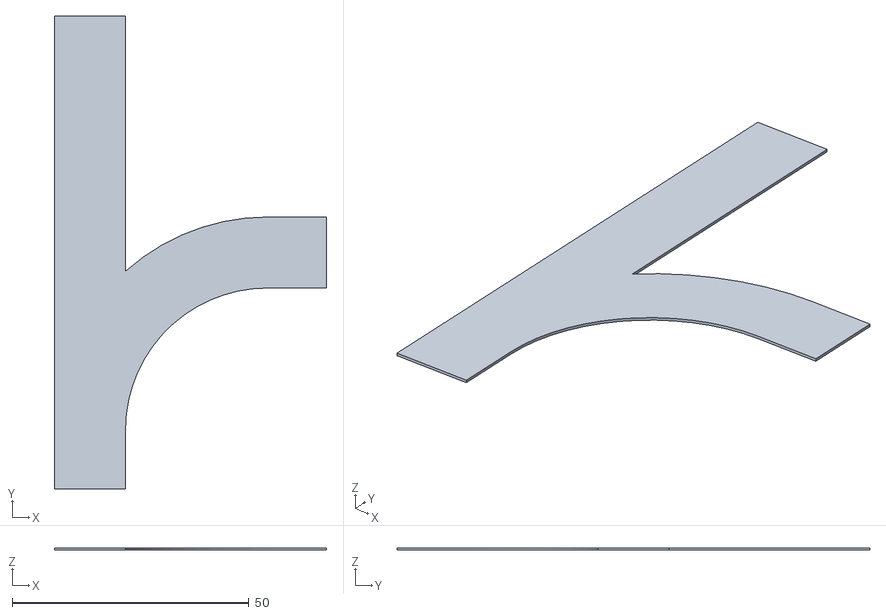
[picture p184: CAD file, 2026-07-24]
assets/models/special/line puzzle/trackcurvestraightR_v1.stl
57.5 x 99.9 x 0.5
