ppatlux/customizer-as-website/assets/models/special/Otto5/Accessories/acc_toolbox_arm.stl

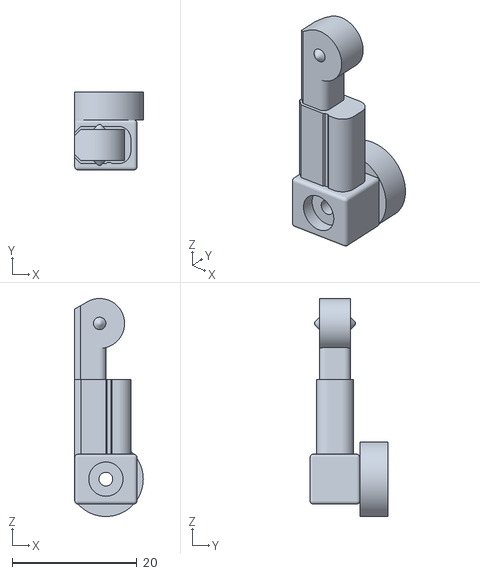
[picture p185: CAD file, 2026-10-27]
assets/models/special/Otto5/Accessories/acc_toolbox_arm.stl
11.0 x 12.5 x 35.0
