ppatlux/customizer-as-website/assets/models/special/Otto5/Bottom/bot_track_base_r.stl

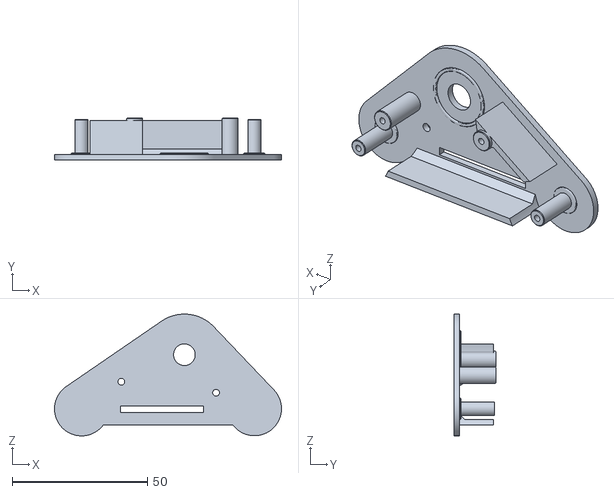
[picture p186: CAD file, 2026-10-27]
assets/models/special/Otto5/Bottom/bot_track_base_r.stl
83.9 x 15.5 x 45.0
