ppatlux/customizer-as-website/assets/models/special/Otto5/Top/top_base.stl

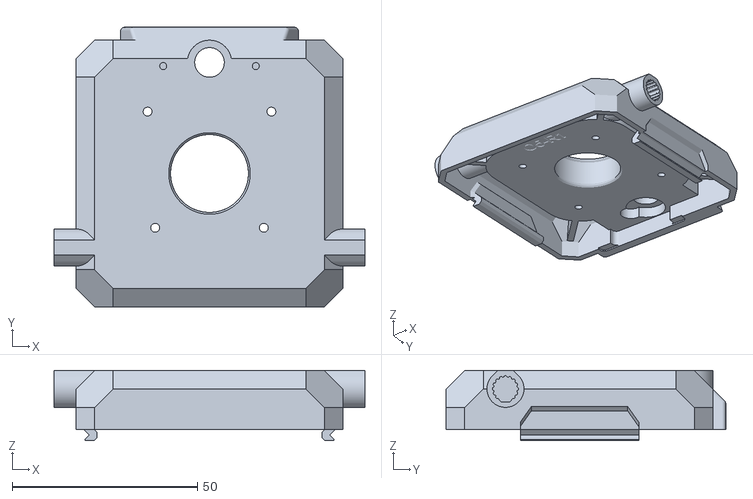
[picture p187: CAD file, 2026-10-27]
assets/models/special/Otto5/Top/top_base.stl
84.0 x 75.5 x 19.0
