ppatlux/customizer-as-website/assets/models/special/Otto5/top_acc_supports.3mf

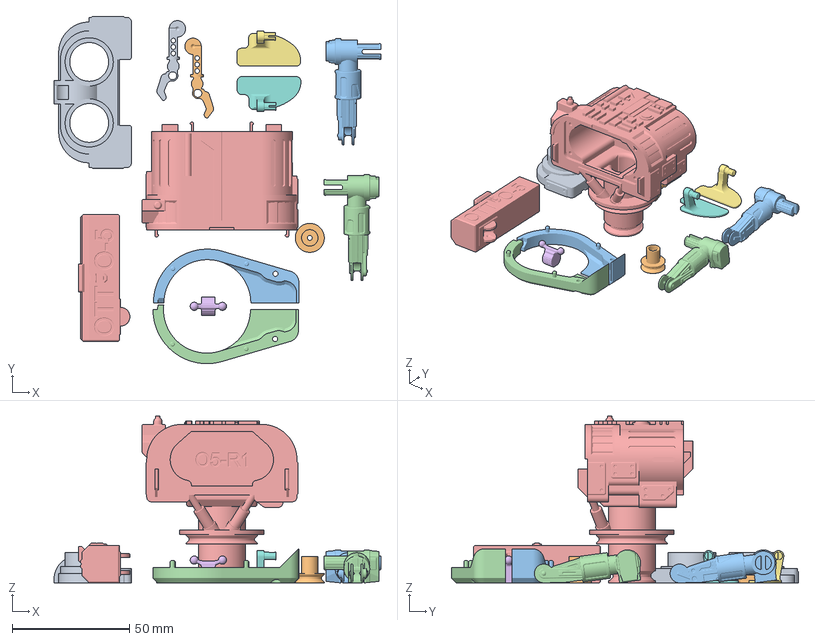
[picture p188: CAD file, 2026-10-27]
assets/models/special/Otto5/top_acc_supports.3mf
139.3 x 147.9 x 71.0 mm
Top_arm_bot_L.stl
Top_arm_bot_R.stl
Top_arm_top_L.stl
Top_arm_top_R.stl
Top_head_base.stl
Top_head_eyebrow_joint.stl
Top_head_eyelid_L.stl
Top_head_eyelid_R.stl
Top_head_front.stl
Top_head_pully.stl
Top_head_pully_cover_L.stl
Top_head_pully_cover_R.stl
Acc_Toolbox.stl
