ppatlux/customizer-as-website/assets/models/special/OttoButter/STL (remember to separate by objects)/arm-l.stl

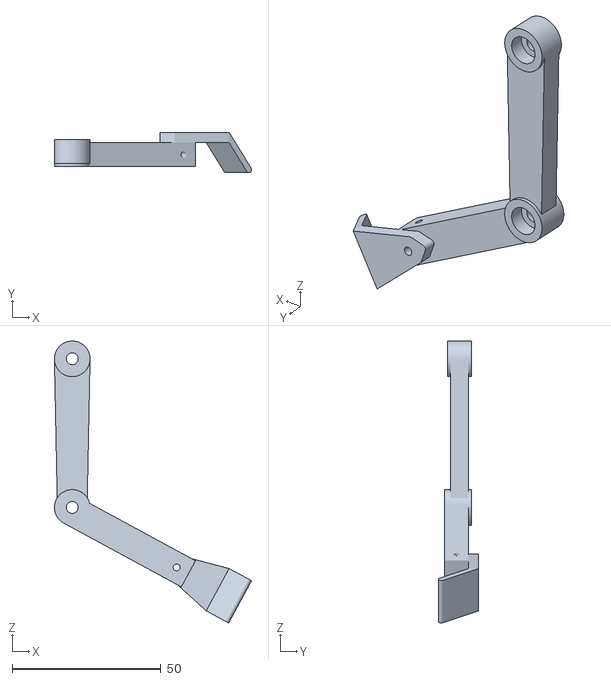
[picture p189: CAD file, 2026-10-27]
assets/models/special/OttoButter/STL (remember to separate by objects)/arm-l.stl
66.3 x 13.6 x 94.9
