ppatlux/customizer-as-website/assets/models/special/OttoBuzz/otto-dub-vw-hubcap.stl

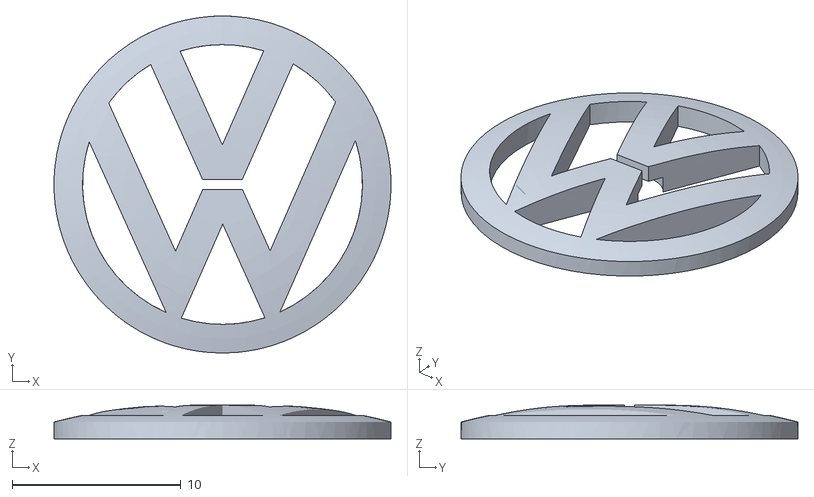
[picture p190: CAD file, 2026-10-27]
assets/models/special/OttoBuzz/otto-dub-vw-hubcap.stl
20.0 x 20.0 x 2.00
