ppatlux/customizer-as-website/assets/models/special/OttoD2/otto-d2-dome-base.stl

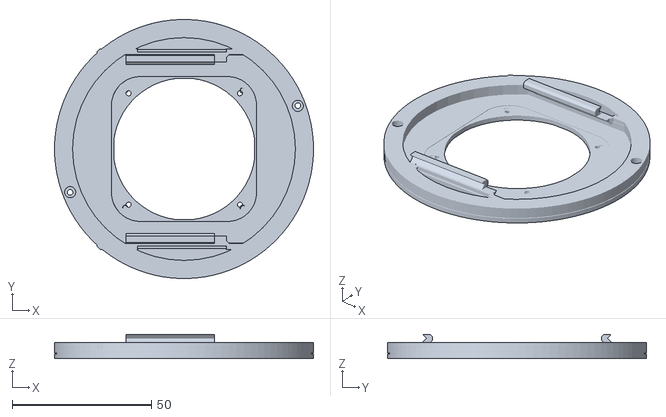
[picture p191: CAD file, 2026-10-27]
assets/models/special/OttoD2/otto-d2-dome-base.stl
93.0 x 93.0 x 8.79
