ppatlux/customizer-as-website/assets/models/special/OttoDino/bracket.stl

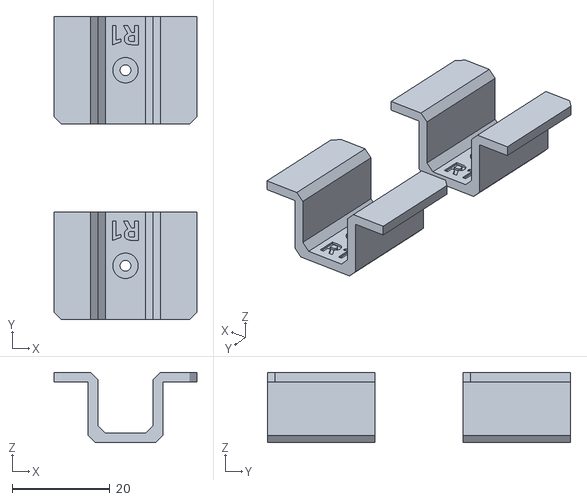
[picture p192: CAD file, 2026-10-27]
assets/models/special/OttoDino/bracket.stl
29.2 x 62.0 x 14.4
