ppatlux/customizer-as-website/assets/models/special/OttoExplorer/rockerbogie_locker_for_diferential.stl

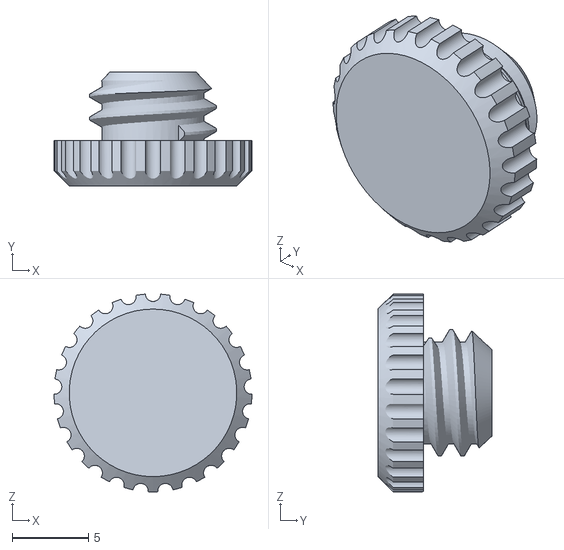
[picture p193: CAD file, 2026-10-27]
assets/models/special/OttoExplorer/rockerbogie_locker_for_diferential.stl
13.0 x 7.50 x 13.0
