ppatlux/customizer-as-website/assets/models/special/OttoJr/wheel.3mf

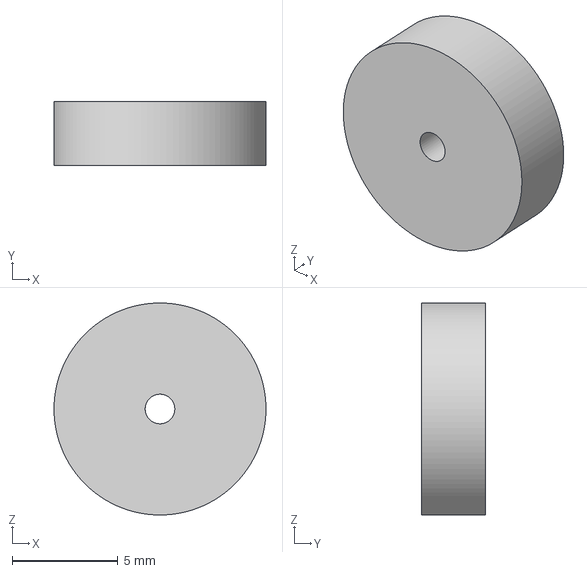
[picture p194: CAD file, 2026-10-27]
assets/models/special/OttoJr/wheel.3mf
10.0 x 3.00 x 10.0 mm
