ppatlux/customizer-as-website/assets/models/special/OttoN/01 Part Set/panels.stl

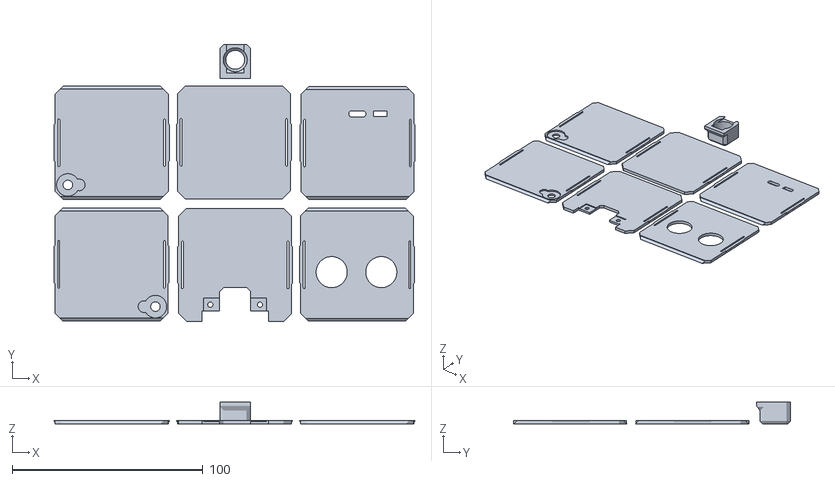
[picture p195: CAD file, 2026-10-27]
assets/models/special/OttoN/01 Part Set/panels.stl
189.2 x 145.1 x 11.5
