ppatlux/customizer-as-website/assets/models/special/OttoN/04 Panels/top_plate.stl

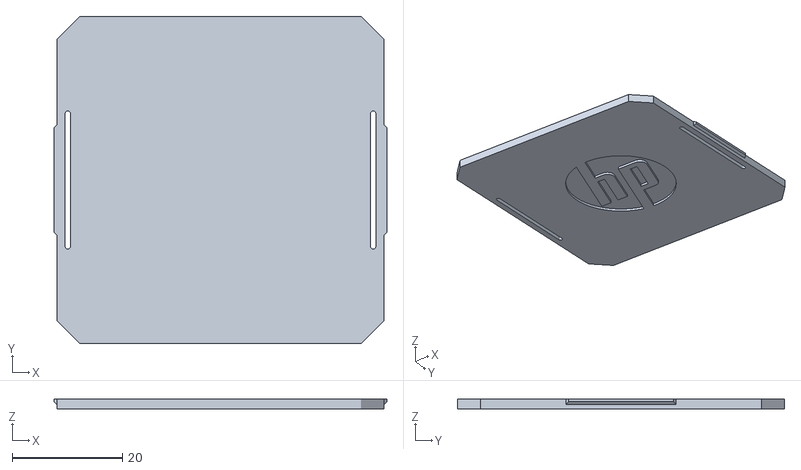
[picture p197: CAD file, 2026-10-27]
assets/models/special/OttoN/04 Panels/top_plate.stl
60.3 x 59.3 x 1.90
