ppatlux/customizer-as-website/assets/models/special/OttoSwim/inside-clip.stl

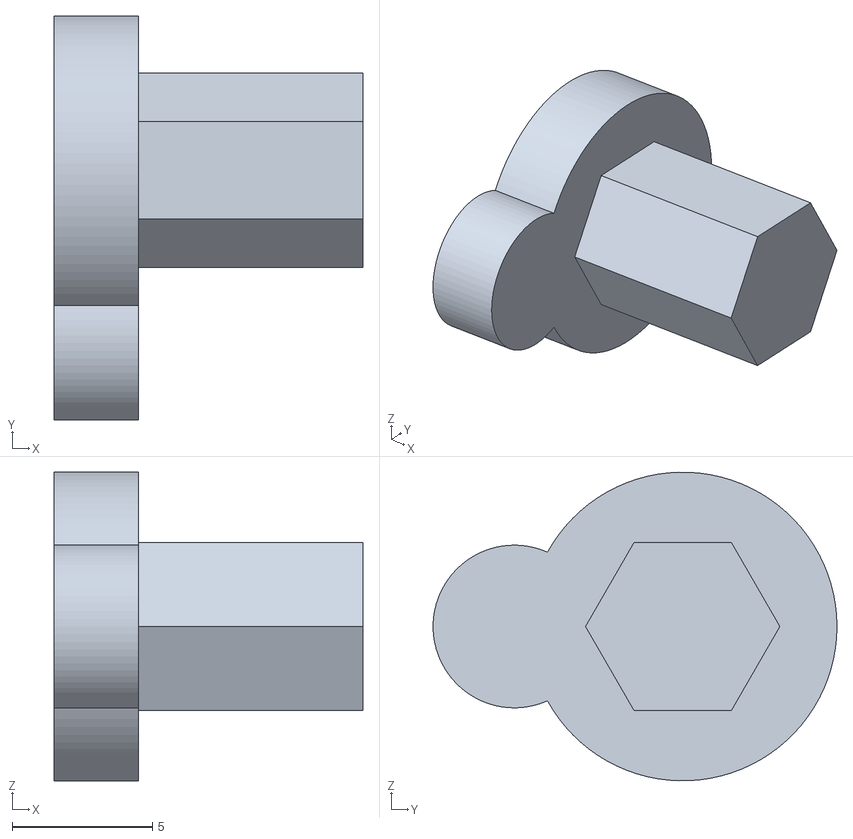
[picture p198: CAD file, 2026-10-27]
assets/models/special/OttoSwim/inside-clip.stl
11.0 x 14.4 x 11.0
