ppatlux/customizer-as-website/assets/models/special/OttoTruck/print-1-updated-v4.3mf

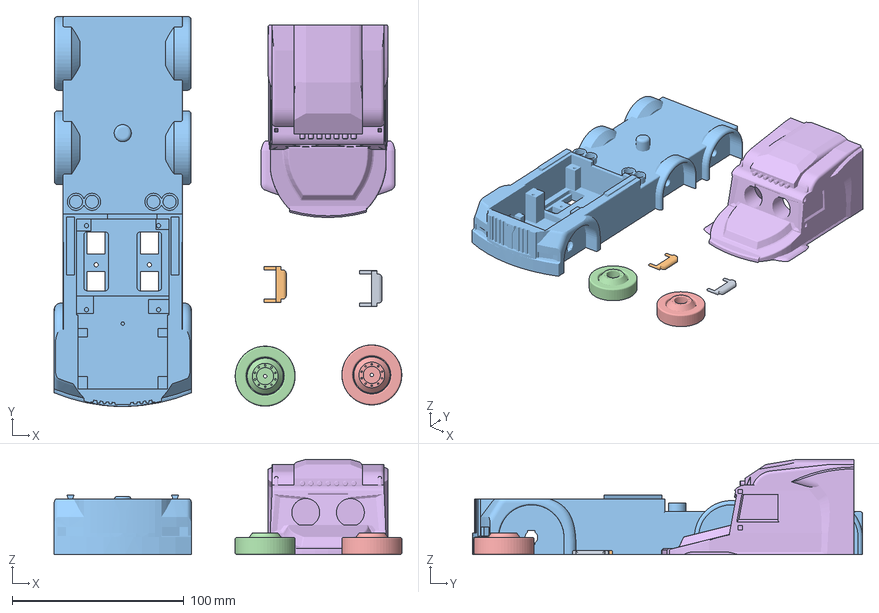
[picture p199: CAD file, 2026-10-27]
assets/models/special/OttoTruck/print-1-updated-v4.3mf
202.7 x 227.3 x 55.5 mm
Mirror (1).stl x 2
Truck (3).stl
Wheel-Front - Part 1 (1).stl x 2
Truck - Part 2 (2).stl
