ppatlux/customizer-as-website/assets/models/special/OttoUnit01/BODY/backpack_clip.stl

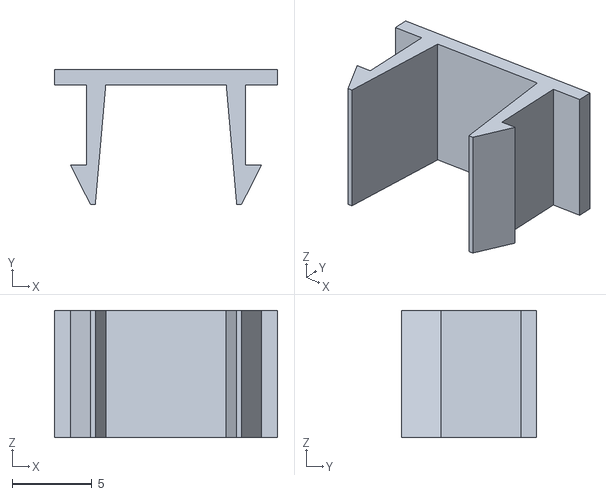
[picture p200: CAD file, 2026-10-27]
assets/models/special/OttoUnit01/BODY/backpack_clip.stl
14.0 x 8.50 x 8.00
