ppatlux/customizer-as-website/assets/models/special/OttoUnit01/HEAD/head_middle_insert.stl

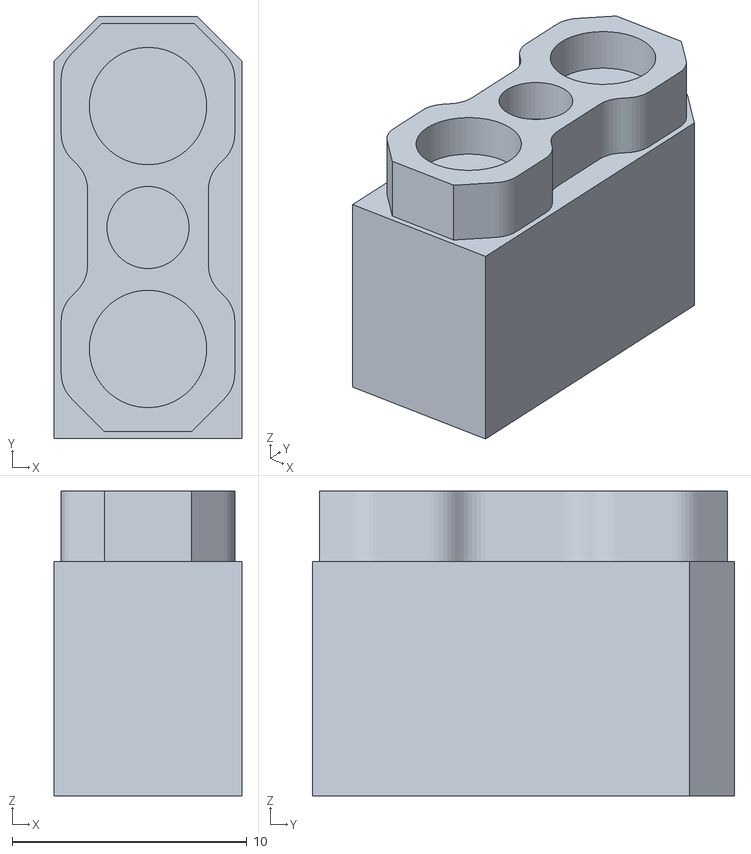
[picture p201: CAD file, 2026-10-27]
assets/models/special/OttoUnit01/HEAD/head_middle_insert.stl
8.00 x 18.0 x 13.0
