ppatlux/customizer-as-website/(list of files, cad)

Other CAD files:
assets/models/special/Otto5/Complete Preview/otto-5_preview_noprint.stl
assets/models/special/OttoUnit01/WHEELBASE/wheelbase_back_plate_insert.stl
assets/models/top/Top lightshat_v3.stl
assets/models/special/controller/Top_extend_buttons_v1.stl
assets/models/special/OttoButter/STEP files (now is your turn to mod this robot)/otto-pass-the-butter.step
assets/models/special/OttoROS/ros-otto.step
assets/models/arms/wing1.stl
assets/models/special/OttoN/03 Outer Frame/corner_02.stl
assets/models/_mixonly/Top_lightsdiffuser_cube.step
assets/models/_mixonly/bottom_jig1x1 (2).stl
assets/models/_mixonly/top_oled_v3 (2).stl
assets/models/_mixonly/top_pcb_v1.stl
assets/models/arms/Arm-angle.step
assets/models/arms/Arm-straight.step
assets/models/arms/Arm_v1.stl
assets/models/arms/Arm_v2.stl
assets/models/arms/Arm_v3.stl
assets/models/arms/Arm_v4.stl
assets/models/arms/Arm_v5.stl
assets/models/arms/Arm_v6.stl
assets/models/arms/Arm_v7.stl
assets/models/arms/Arm_v8.stl
assets/models/bottom/Bottom-starter.step
assets/models/bottom/Bottom_Base.stl
assets/models/bottom/Bottom_Boat.3mf
assets/models/bottom/Bottom_Boat.stl
assets/models/bottom/Bottom_Boat_Cargogrill.stl
assets/models/bottom/Bottom_Boat_drive wheel.stl
assets/models/bottom/Bottom_Bricks.3mf
assets/models/bottom/Bottom_Drift.stl
assets/models/bottom/Bottom_Duck.stl
assets/models/bottom/Bottom_Duck.stp
assets/models/bottom/Bottom_Honeycomb.stl
assets/models/bottom/Bottom_Lid_V8.stl
assets/models/bottom/Bottom_Pika.step
assets/models/bottom/Bottom_Pika.stl
assets/models/bottom/Bottom_Race.step
assets/models/bottom/Bottom_balancing.stl
assets/models/bottom/Bottom_biped.stl
assets/models/bottom/Bottom_empy.stl
assets/models/bottom/Bottom_extended_v2.stl
assets/models/bottom/Bottom_multi.3mf
assets/models/bottom/bottom_extended_v1.stl
assets/models/bottom/ottolocobase.stl
assets/models/bumper/Bumper_Forklift.stl
assets/models/bumper/Bumper_Race.step
assets/models/bumper/Bumper_Race.stl
assets/models/bumper/Bumper_Roller.3mf
assets/models/bumper/Bumper_football.step
assets/models/bumper/Bumper_football.stl
assets/models/bumper/Bumper_motor_bulldozer.step
assets/models/bumper/Bumper_motor_bulldozer.stl
assets/models/bumper/Bumper_motor_collect.step
assets/models/bumper/Bumper_motor_ramp.step
assets/models/bumper/HP_BumperFootballcollect.stl
assets/models/bumper/HP_BumperFootballmodule.stl
assets/models/bumper/HP_BumperSteamBumper_R1.stl
assets/models/bumper/HP_BumperSteamRoller_R1.stl
assets/models/bumper/HP_BumperTrailer_R1.stl
assets/models/bumper/HP_BumperTrailerpin_R1.stl
assets/models/bumper/HP_BumperTrailersocket_R2.stl
assets/models/bumper/HP_BumperTrailerwheel_R1.stl
assets/models/bumper/HP_Bumper_Bulldozer_R3.stl
assets/models/bumper/HP_Bumper_Canholder_R1.stl
assets/models/bumper/HP_Bumper_Collector_R3.stl
assets/models/bumper/HP_Bumper_Forklift_R2.stl
assets/models/bumper/HP_Bumper_Penholder_R2.stl
assets/models/bumper/HP_Bumper_Plower_R1.stl
assets/models/bumper/HP_Bumper_Plower_R3.stl
assets/models/bumper/Modular bumper (pivot).stl
assets/models/bumper/Motor bumper_v18.stl
assets/models/bumper/bandana.step
assets/models/bumper/bumper_oriented.step
assets/models/bumper/pen/hp_gripperbase_r1.stl
assets/models/bumper/pen/ottopenadapterwithscrew.stl
assets/models/bumper/pen/pc-17k.stl
assets/models/bumper/pen/pc-1mr.stl
assets/models/bumper/pen/pc-5m.stl
assets/models/bumper/pen/pc-8k.stl
assets/models/face/Face-RGB-ring.step
assets/models/face/Face-display.step
assets/models/face/Face-matrix.step
assets/models/face/Face-ultrasonic.step
assets/models/face/Face10.stl
assets/models/face/Face11.stl
assets/models/face/FaceMatrix16x8_v03.stl
assets/models/face/FaceMatrix8x8_v02.stl
assets/models/face/FaceNose.stl
assets/models/face/FaceUSOLED.step
assets/models/face/FaceUSOLED_v4.stl
assets/models/face/FaceUS_Luke_t_Easter Bunny.stl
assets/models/face/FaceUS_flatItaly.3mf
assets/models/face/FaceUS_moustache.stl
assets/models/face/FaceUSmask_eyebrow_v2.stl
assets/models/face/Face_Angry.step
assets/models/face/Face_Chamfer.stl
assets/models/face/Face_Duck.stl
assets/models/face/Face_Duck.stp
assets/models/face/Face_Eyebrows.step
assets/models/face/Face_Flat.step
assets/models/face/Face_Flat.stl
assets/models/face/Face_Gladiator.stl
assets/models/face/Face_Pumpkin.step
assets/models/face/Face_Pumpkin.stl
assets/models/face/Face_Race.stl
assets/models/face/Facematrix_v1.stl
assets/models/face/Facematrix_v4.stl
assets/models/face/Facematrix_v5.stl
assets/models/face/Facering_v03.stl
assets/models/face/Facetemplate.step
assets/models/face/Goggles.stl
assets/models/face/HP_FaceMatrix_R1.stl
assets/models/face/HP_FaceOLED_R1.stl
assets/models/face/HP_FaceUS_SER2.stl
assets/models/face/HP_Face_BeardLepre.stl
assets/models/face/HP_Face_BeardPrusa_v3.3mf
assets/models/face/HP_Face_BeardSanta_R1.stl
assets/models/face/HP_Face_Eyebrows_v2.stl
assets/models/face/HP_Face_Mustache.stl
assets/models/face/HP_Mustache_v1.stl
assets/models/face/HP_Samurai_beard.stl
assets/models/face/OTTO_face_lego siege tower.3mf
assets/models/face/PrusaBeard_Face.stl
assets/models/face/beak.stl
assets/models/face/document-face.stl
assets/models/face/heisenbergface.stl
assets/models/face/hp-otto-bow.stl
assets/models/face/hp-otto-face-magnets.stl
assets/models/face/hp-otto-ribon.stl
assets/models/face/hp-otto-tie-monocolor.stl
assets/models/face/hp-otto-tie-multicolor.stl
assets/models/face/hp_faceus_ser2 (2).stl
assets/models/face/lessfilamentottoface.stl
assets/models/face/mask.stl
assets/models/face/otto-faceus.stl
assets/models/face/otto-groot-face.stl
assets/models/face/otto_face_lego-firefighter.3mf
assets/models/face/otto_face_lego-space.3mf
assets/models/face/potato_face.stl
assets/models/face/steve/oeil-droit.stl
assets/models/hat/3dtakotuesday.baseballcap.combined.mm.stl
assets/models/hat/3dtakotuesday.constructionhat.mm.stl
assets/models/hat/8point_hat_otto.stl
assets/models/hat/Backpack - Wrap-Around.stl
assets/models/hat/HP_HatBIG_Leprechaun.stl
assets/models/hat/HP_HatBIG_LeprechaunBelt.stl
assets/models/hat/HP_HatBIG_LeprechaunBuckle.stl
assets/models/hat/HP_Hat_Spoiler_v4.stl
assets/models/hat/HP_Samurai_helmet.stl
assets/models/hat/Hat_Bavarian.step
assets/models/hat/Hat_Bavarian.stl
assets/models/hat/Hat_BavarianBand.stl
assets/models/hat/Hat_BavarianFeather.stl
assets/models/hat/Hat_Bricks.stl
assets/models/hat/Hat_Construction.stl
assets/models/hat/Hat_Dragonborn.stp
assets/models/hat/Hat_Flat.step
assets/models/hat/Hat_Gladiator.step
assets/models/hat/Hat_Gladiator.stl
assets/models/hat/Hat_GladiatorHair.stl
assets/models/hat/Hat_Leprechaun.step
assets/models/hat/Hat_Leprechaun.stl
assets/models/hat/Hat_LeprechaunBelt.stl
assets/models/hat/Hat_LeprechaunBuckle.stl
assets/models/hat/Hat_Magic.stl
assets/models/hat/Hat_Mister.stl
assets/models/hat/Hat_Pika ears.step
assets/models/hat/Hat_Pika.stl
assets/models/hat/Hat_Prusa.stl
assets/models/hat/Hat_Pumpkin.3mf
assets/models/hat/Hat_Race.step
assets/models/hat/Hat_Round.stl
assets/models/hat/Hat_Santa.step
assets/models/hat/Hat_Santa.stl
assets/models/hat/Hat_SantaBall.stl
assets/models/hat/Hat_SumoBand.stl
assets/models/hat/Hat_Viking.step
assets/models/hat/Hat_Viking.stl
assets/models/hat/Hat_dome.step
assets/models/hat/Hat_dome.stl
assets/models/hat/Hat_police.stl
assets/models/hat/Lego like Cap V3.3mf
assets/models/hat/Painting Otto (Tighter fit).stl
assets/models/hat/TopPikaear_v2.stl
assets/models/hat/baseball_cap_otto.stl
assets/models/hat/beanie.stl
assets/models/hat/beanie_cap_otto.stl
assets/models/hat/cap_button_otto.stl
assets/models/hat/casque.stl
assets/models/hat/cowboy-hat.step
assets/models/hat/crown_otto.stl
assets/models/hat/document-cap.stl
assets/models/hat/kepi_hat_otto.stl
assets/models/hat/mortarboard_cap_otto.stl
assets/models/hat/otto-dragonborn-helm.stl
assets/models/hat/otto-dragonborn-horn.stl
assets/models/hat/ottomoji_alphabet_a.3mf
assets/models/hat/ottomoji_alphabet_b.3mf
assets/models/hat/ottomoji_alphabet_c.3mf
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
