ppatlux/customizer-as-website/assets/models/special/OttoTruck/1628039-hp-otto-the-truck-updating-issue-optimus-prime-35d2f9d8-7ffb-48fd-9ec4-d567cca5132d.pdf

## HP Otto the Truck (Updating issue)-

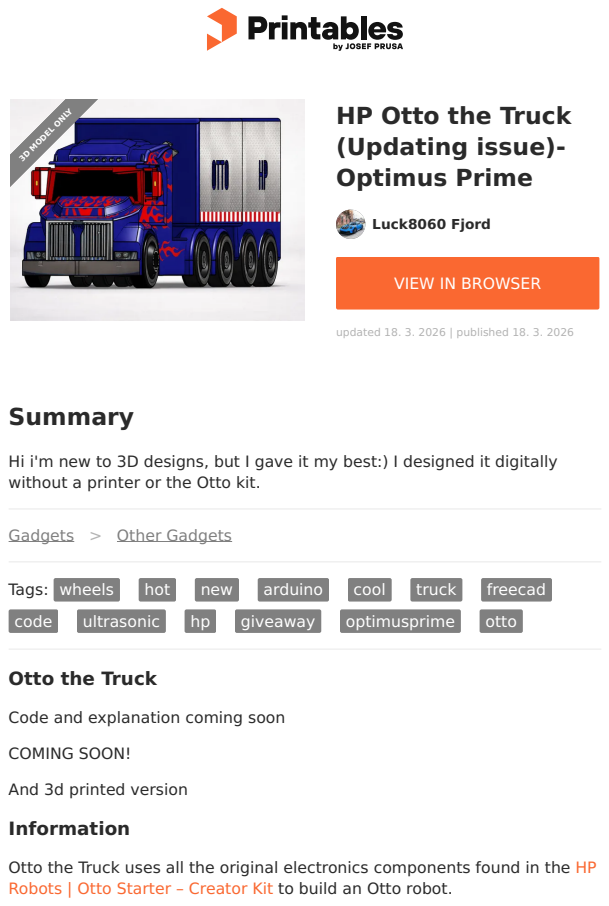
[picture p202: page 1]
Summary; Tags:; wheels; hot; new; arduino; cool; truck; freecad; code; ultrasonic; giveaway; optimusprime; otto; COMING SOON!; Luck8060 Fjord; Optimus Prime; updated 18. 3. 2026 | published 18. 3. 2026; 3D MODEL ONLY

VIEW IN BROWSER (https://printables.com/model/1628039-hp-otto-the-truck-updating-issue-optimus-prime)

Hi i'm new to 3D designs, but I gave it my best:) I designed it digitally
without a printer or the Otto kit.

Gadgets (https://printables.com/model?categoryId=21) > Other Gadgets (https://printables.com/model?categoryId=43)

Otto the Truck

Code and explanation coming soon

And 3d printed version
Information

Otto the Truck uses all the original electronics components found in the HP
Robots | Otto Starter – Creator Kit (https://shop.moravia.education/educational-and-interactive-robots/hp-robots/hp-robots-otto-creator-kit.html) to build an Otto robot.

## Model files

Printing recommendations

Coming soon.
Assembly

This is my guide on how to build OTTO the Truck :) (https://drive.google.com/file/d/1zQXfpnbh41oz4adqq8iIkO0jOxZX5SeW/view?usp=sharing)

## This remix is based on

HP Robots | Otto Starter (https://printables.com/model/829419-hp-robots-otto-starter)
by HP Robots Otto (https://printables.com/@hprobots)

## License

This work is licensed under a
Creative Commons (4.0 International License)

Attribution—Noncommercial—Share Alike (http://creativecommons.org/licenses/by-nc-sa/4.0/)

✖ | Sharing without ATTRIBUTION
✔ | Remix Culture allowed
✖ | Commercial Use

print-1-dont-print-yet.3mf

print-2-dont-print-yet.3mf

✖ | Free Cultural Works
✖ | Meets Open Definition
