ppatlux/customizer-as-website/assets/models/special/OttoN/otton-assembly-instructions-v11.pdf

# OTTON

# step 1 - motor assembly

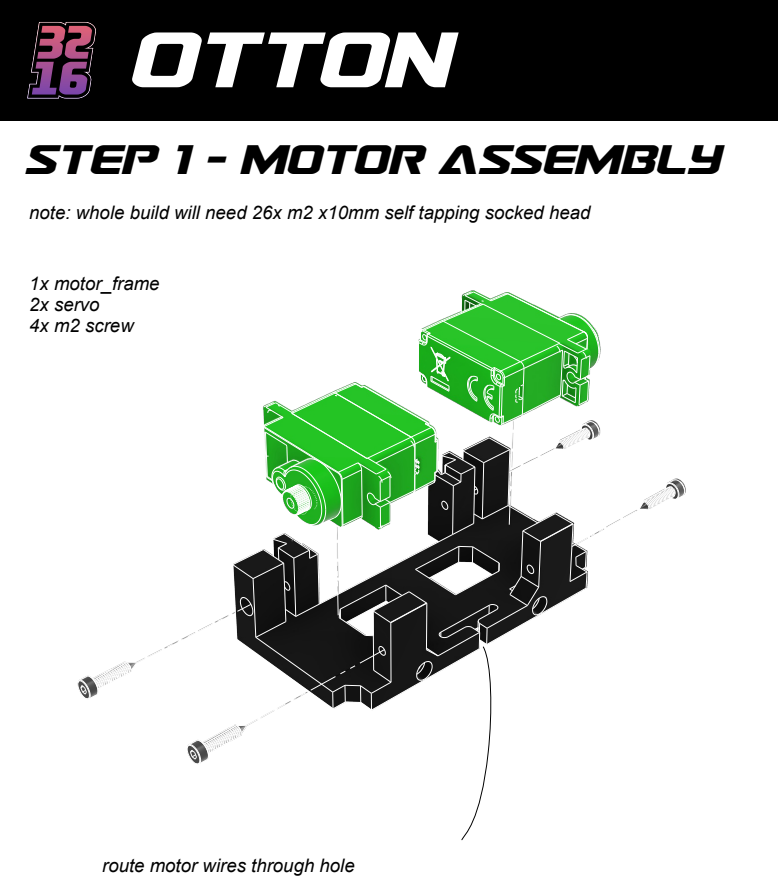
[picture p203: page 1]
1x motor_frame 2x servo 4x m2 screw

note: whole build will need 26x m2 x10mm self tapping socked head

route motor wires through hole

# step 2 - sensor assembly

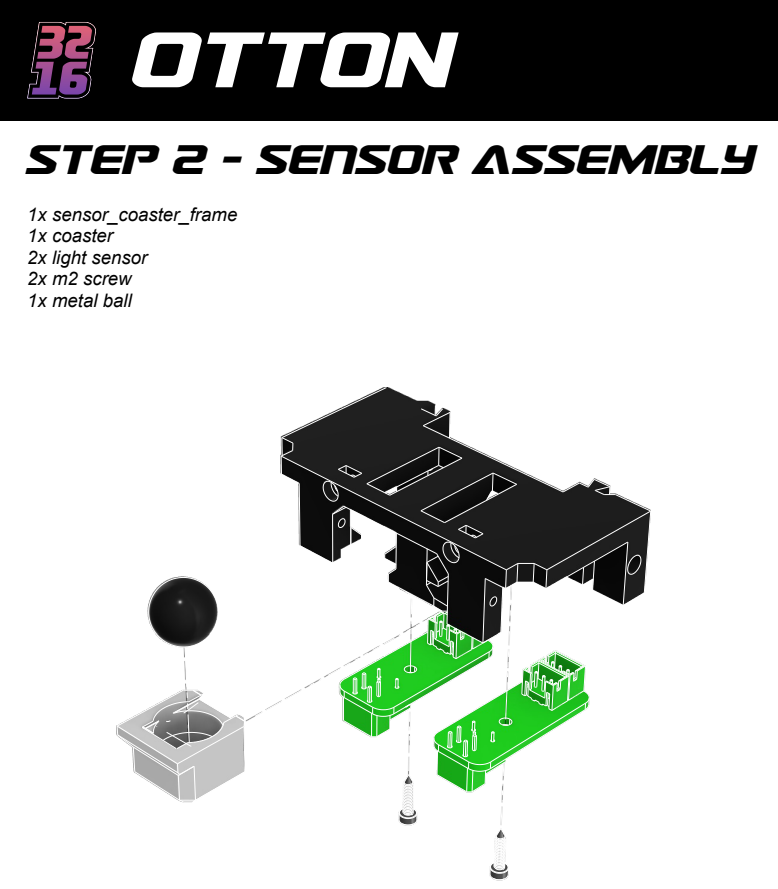
[picture p204: page 2]
1x sensor_coaster_frame 1x coaster 2x light sensor 2x m2 screw 1x metal ball

# step 3 - ultrasonic sensor assembly

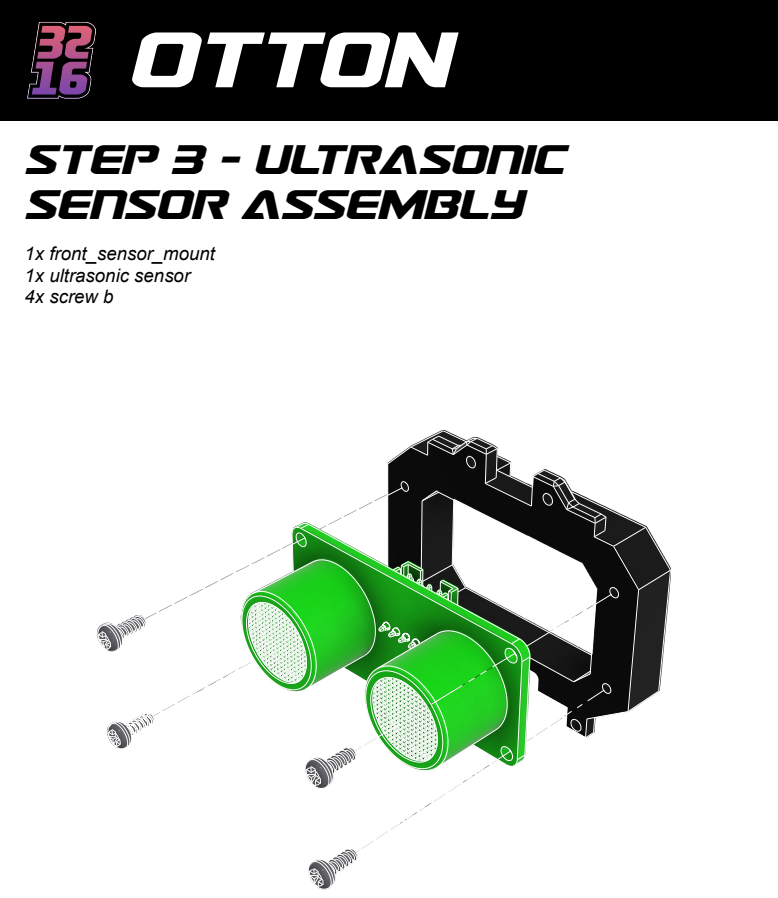
[picture p205: page 3]
1x front_sensor_mount 1x ultrasonic sensor 4x screw b

# step 4- core assembly

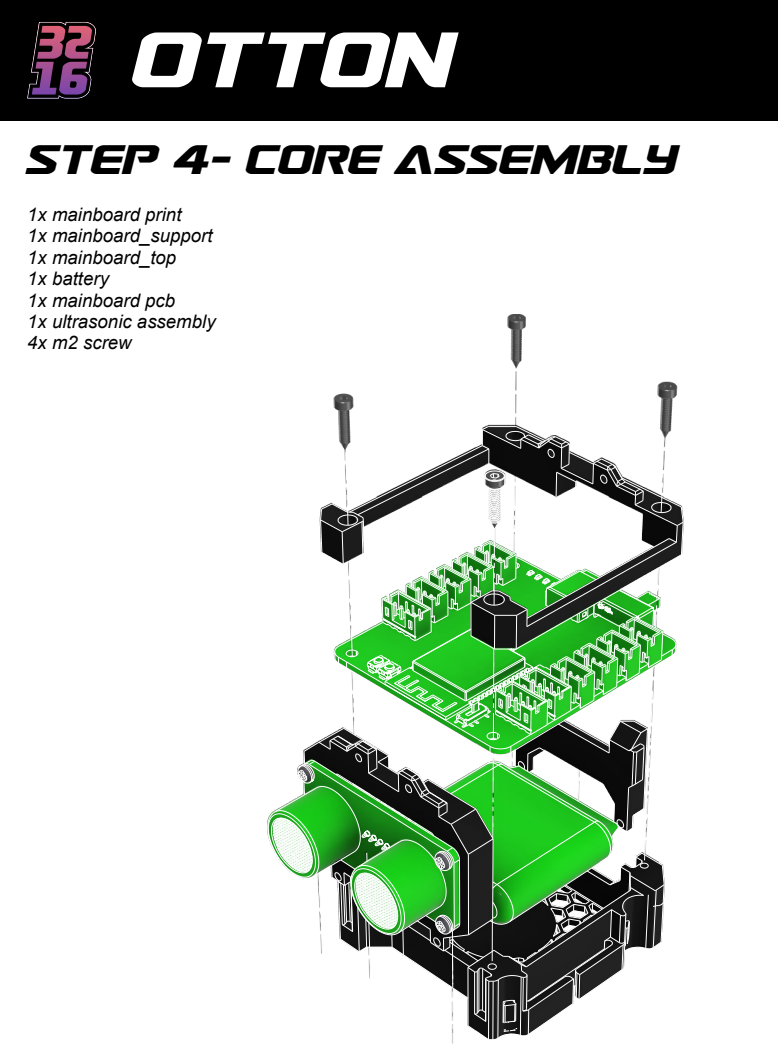
[picture p206: page 4]
1x mainboard print 1x mainboard_support 1x mainboard_top 1x battery 1x mainboard pcb 1x ultrasonic assembly 4x m2 screw

# step 5 - mid and bottom assembly

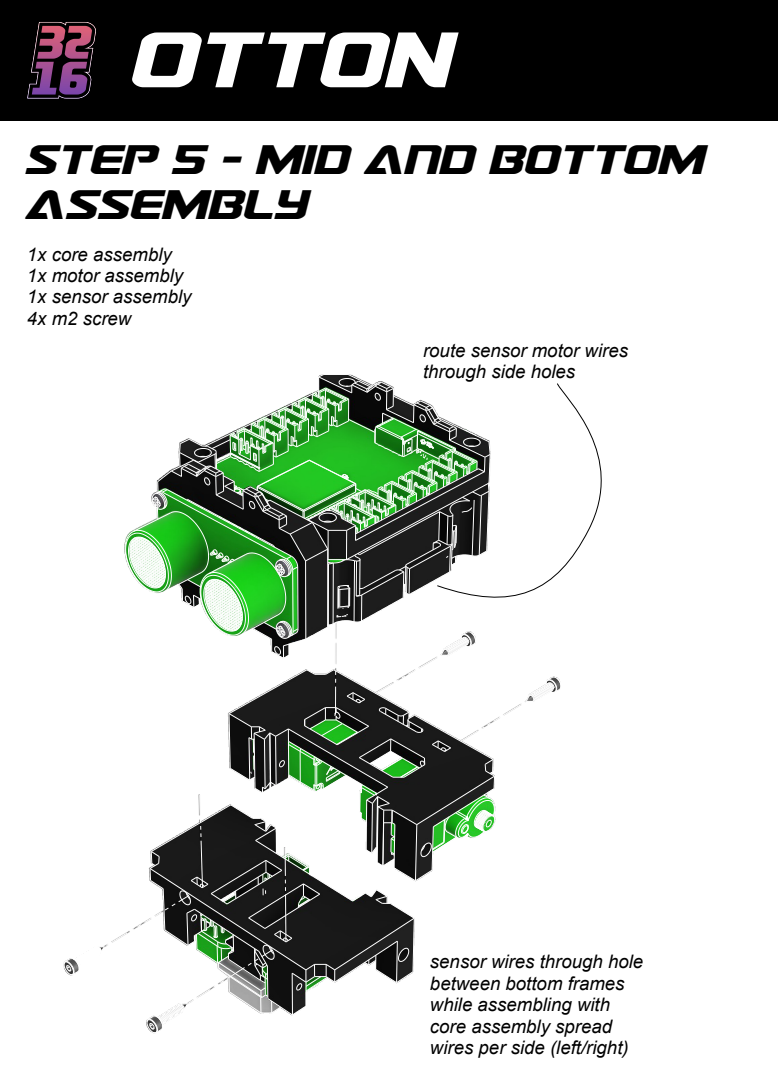
[picture p207: page 5]
1x core assembly 1x motor assembly 1x sensor assembly 4x m2 screw

route sensor motor wires
through side holes

sensor wires through hole
between bottom frames
while assembling with
core assembly spread
wires per side (left/right)

# step 6 - inner frame

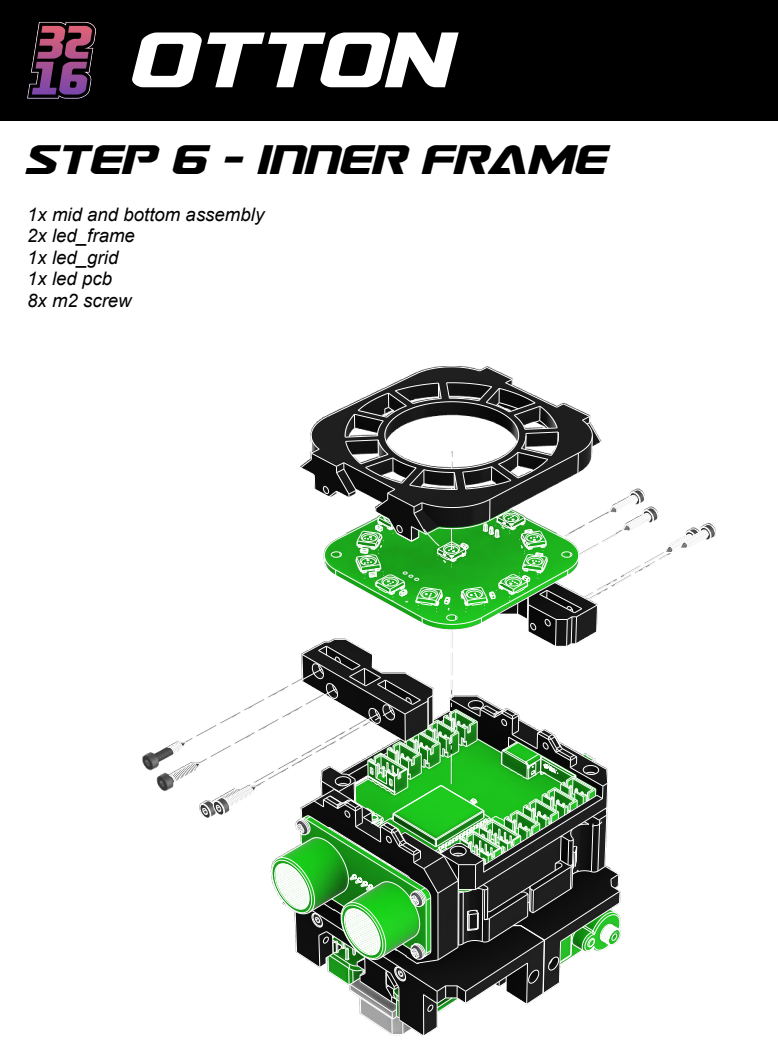
[picture p208: page 6]
1x mid and bottom assembly 2x led_frame 1x led_grid 1x led pcb 8x m2 screw

# step 7 - bottom

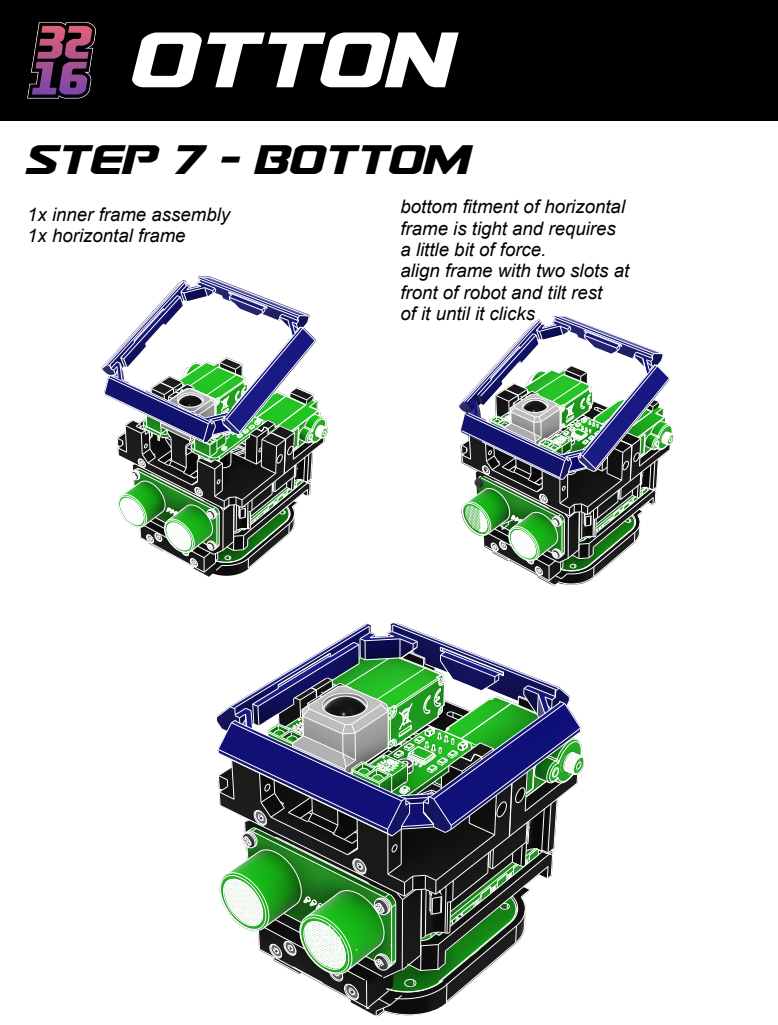
[picture p209: page 7]

bottom fitment of horizontal
frame is tight and requires
a little bit of force.
align frame with two slots at
front of robot and tilt rest
of it until it clicks

1x inner frame assembly
1x horizontal frame

# step 8 - top

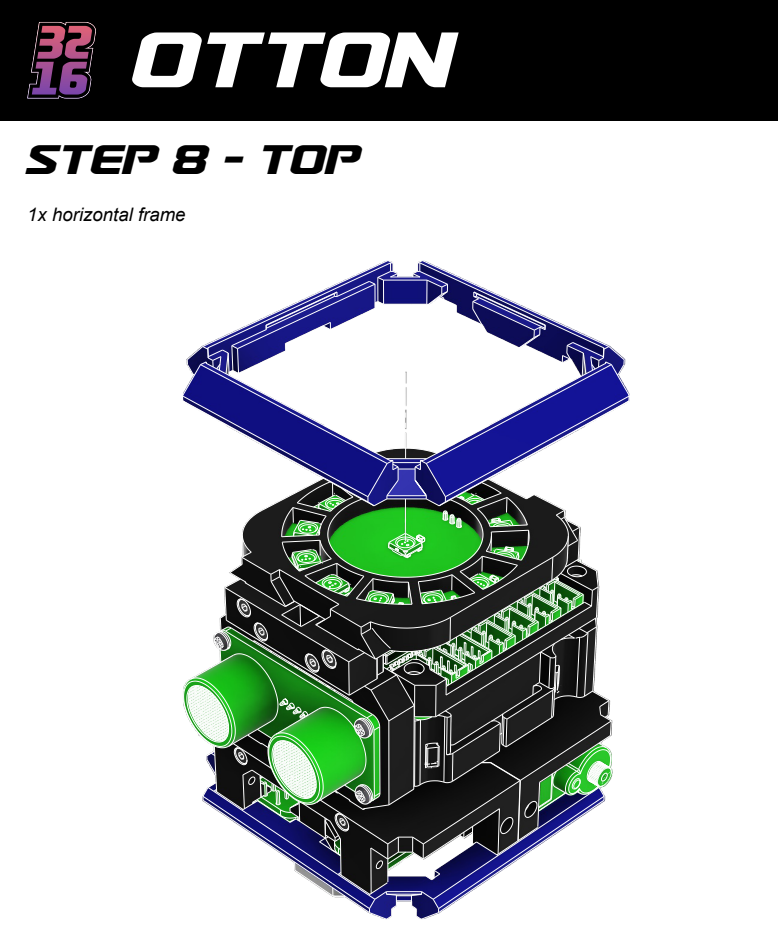
[picture p210: page 8]
1x horizontal frame

# step 9 - outer frame

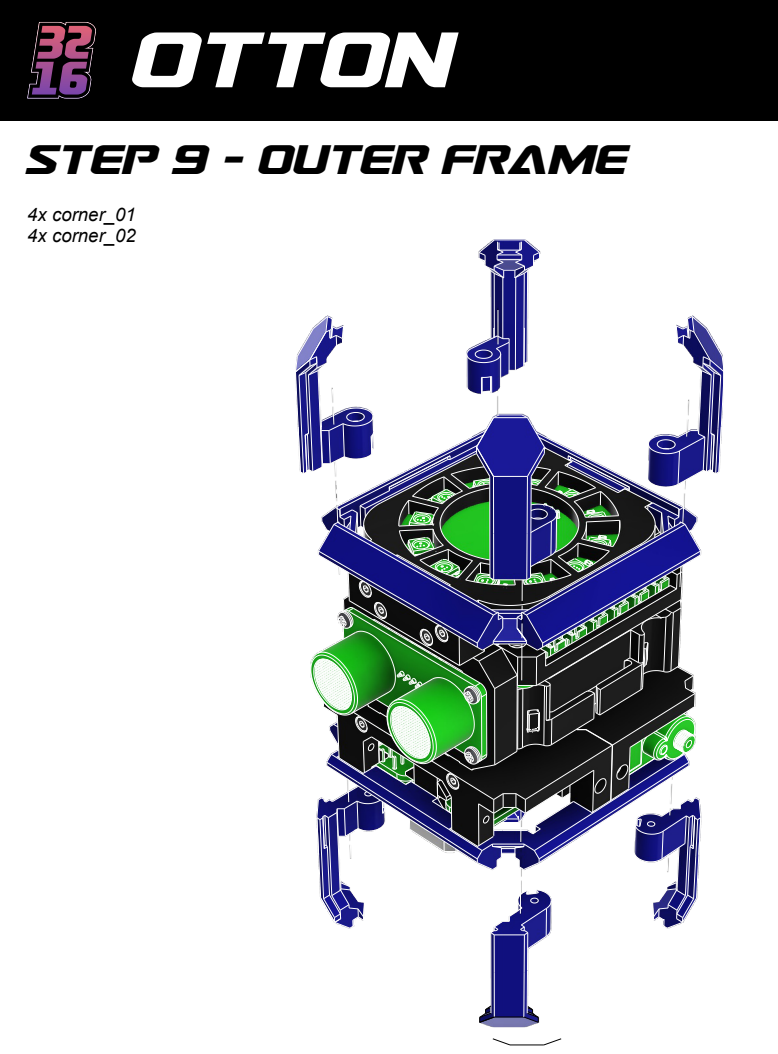
[picture p211: page 9]
4x corner_01 4x corner_02

# step 10 - outer frame

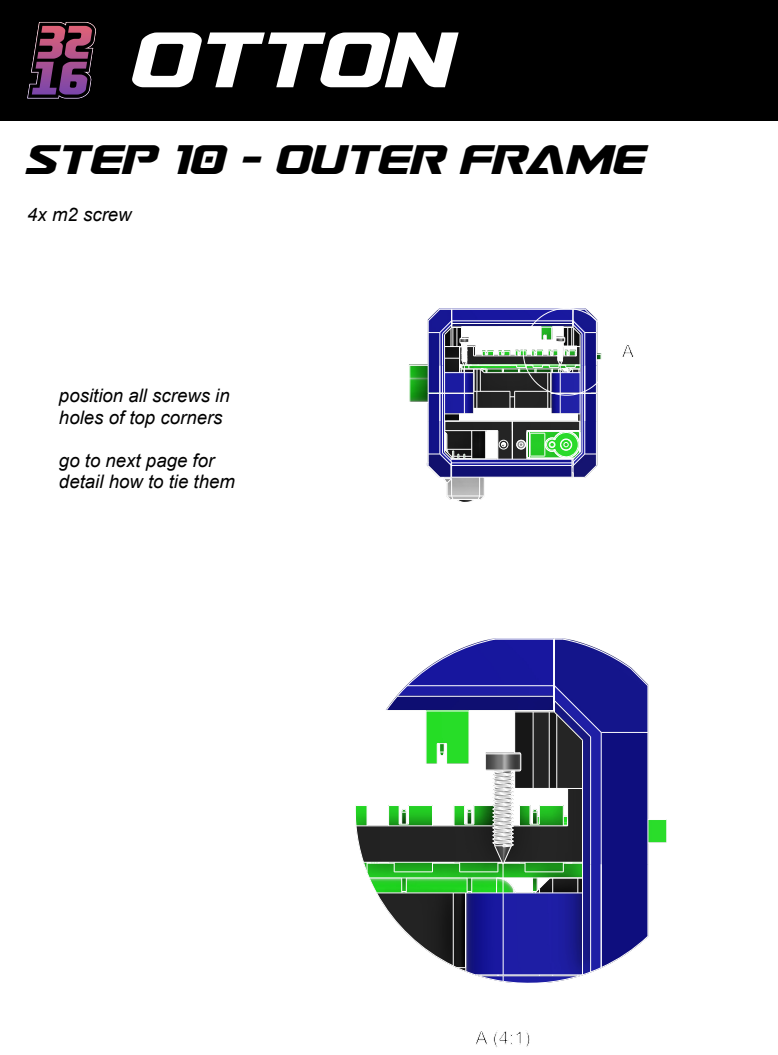
[picture p212: page 10]
4x m2 screw

position all screws in
holes of top corners

go to next page for
detail how to tie them

# step 11 - outer frame

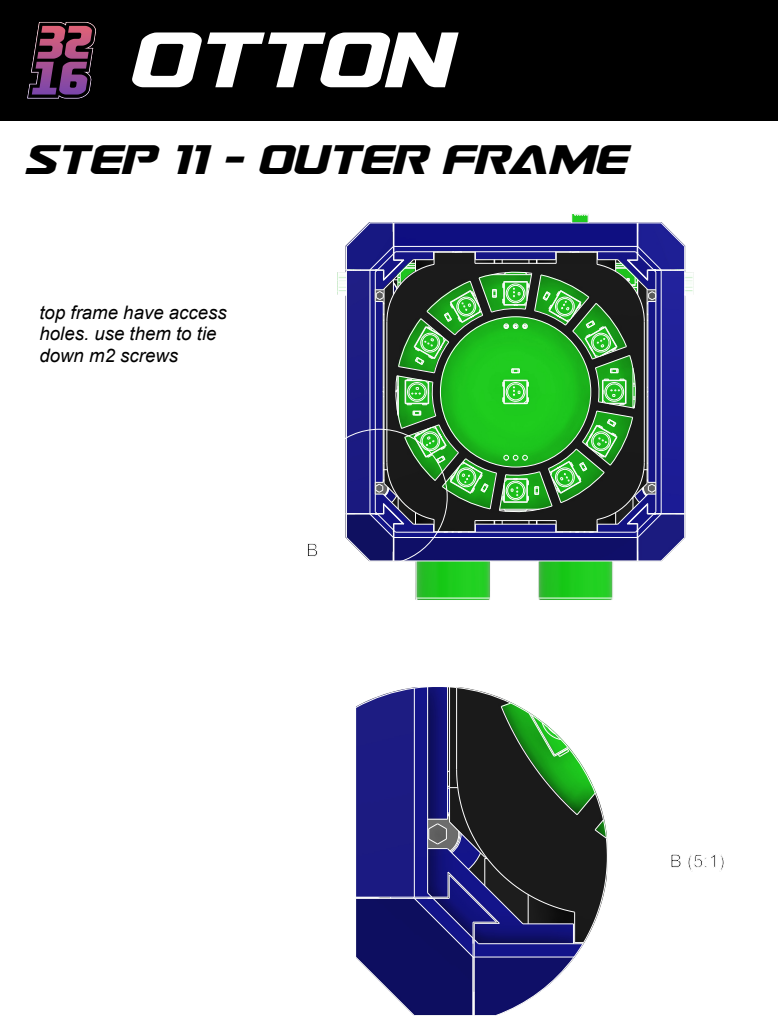
[picture p213: page 11]

top frame have access
holes. use them to tie
down m2 screws

# step 12 - panels

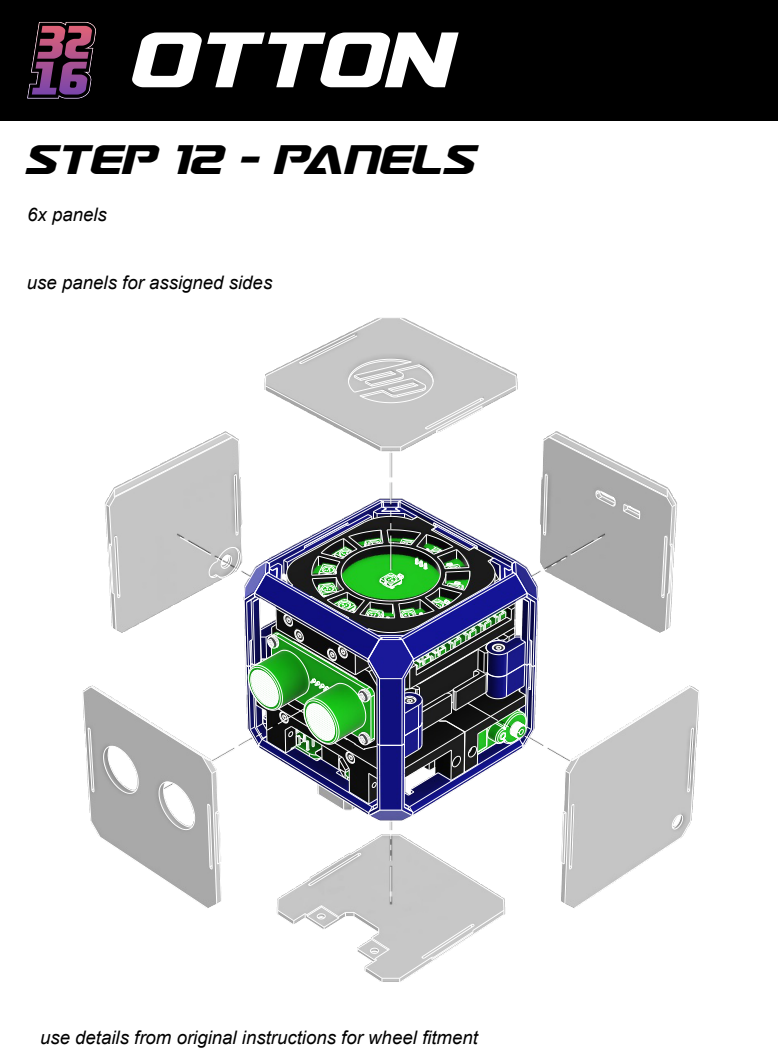
[picture p214: page 12]
6x panels

use panels for assigned sides

use details from original instructions for wheel fitment
