ppatlux/customizer-as-website/(commit log)

2026-07-13 Initial backup of HP Robot Customizer standalone app
    Includes the customizer, engraving tool, local slicer bridge, and assets.
    [Arm-angle.step, Arm-straight.step, Bottom-starter.step, Bottom_Pikachu.step, Bottom_template.step, Bumper_F1.step, Bumper_football.step, Bumper_motor_collect.step]
2026-07-14 feat(assets): add over 40 new 3D model asset files
    Add models for a variety of robot components including hats, tops, faces, bumpers, arms, and motion systems, organized into subdirectories under assets/models.
    [Arm-angle.step, Arm-straight.step, Bottom-starter.step, Bottom_Pikachu.step, Bottom_template.step, Bumper_F1.step, Bumper_football.step, Bumper_motor_collect.step]
2026-07-14 feat(engrave): add built-in shape library and improve engraving UI
    Add a pre-made engraving shape library with 9 common designs: circle, star,
    heart, paw print, lightning bolt, moon, sun, flower, and letter H.
    Other improvements:
    - Add step increment buttons for all size, position, and cut depth sliders
    - Add toggle for on-model transform gizmo with touch-optimized sizing
    - Fix touch gesture conflicts with browser defaults
    - Improve touch tooltip interactions and portrait layout logic
    - Update upload button styling and text
2026-07-15 first dump of stl files
    [Arm_v1.stl, Arm_v2.stl, Arm_v3.stl, Arm_v4.stl, Arm_v5.stl, Arm_v6.stl, Arm_v7.stl, Arm_v8.stl]
2026-07-24 reorder. hat and face .glbs
    [Airless Ping Pong Ball.stl, AirlessPingPongBall.stl, Bottom_biped.3mf, Bottom_extend_PCB_R1.stl, Bottom_jig1x1.stl, Bottom_jig2x1v.stl, Bottom_jig2x2.stl, Bottom_jigext US.stl]
2026-07-28 feat(slicer): replace local bridge with custom URL protocol setup
    Remove deprecated tools/slicer-bridge.ps1 background server. Add one-time setup script, hidden VBS launcher, and full protocol handler logic for the hprobotslicer:// URL scheme. Update engrave.js to generate unique STL filenames, trigger browser downloads, and launch the custom protocol instead of POSTing to the local bridge. Update README.md with complete setup, usage, and uninstall instructions. Add tooltip to the send-to-slicer button explaining the required one-time setup, and fix brief console window flash by using the VBS wrapper's hidden window launch instead of direct PowerShell hidden mode.
2026-08-07 feat: add ar preview and shareable build functionality
    - swap Three.js and addons CDN from unpkg to jsDelivr across both HTML files
    - add share button and shareable build URL generation/restore logic
    - implement AR preview flows: QR code view for desktop, in-browser AR via model-viewer for touch devices
    - add full AR overlay UI with accessibility attributes and corresponding CSS styling
    - refactor state restoration to support loading builds from shared URL parameters alongside local storage
2026-08-07 feat(ui): refine mobile UI, add loading splash, and improve UX
    Reorganize toolbar actions into a mobile overflow menu for factory reset and download options, hiding desktop-specific buttons on touch devices
    Add full-page app loading splash screen that hides once all initial models finish loading
    Hide slicer send controls on touch devices since they are useless without a local slicer installed
    Improve AR model lighting and shadows for better part boundary visibility
    Update share link handling to use native share sheets on touch devices
    Adjust toolbar positioning to avoid overlapping parts panels on small viewports
2026-08-07 feat(mobile): add bottom sheet for touch devices
    This commit adds a mobile bottom sheet for touch-only devices that repurposes existing UI elements without duplication:
    - add DOM shell for the bottom sheet in index.html
    - add complete CSS styling for peek/expanded states, grip handle, and reflowed controls
    - add JavaScript to set up mobile sheet interactions and move live UI elements into the sheet
    - implement tap and drag toggle interactions plus tap-to-collapse on the 3D viewer
    - adjust initial camera position on touch devices to keep the model visible under the sheet
    - add AR export tint offsets to improve part contrast in AR previews using default colors
    - fix #more-group to respect mobi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
2026-08-07 fix(mobile-sheet): adjust layout and height to preserve viewer space
    Fix the issue where the mobile bottom sheet covers the entire screen on short viewport devices, leaving no space for the 3D viewer. Cap the expanded sheet height to min(48vh, 260px), reflow part cards and action toolbar to minimize vertical space usage, and adjust padding and handle sizes for improved mobile usability.
2026-08-07 fix: remove rotate overlay, polish mobile UI and AR exports
    Remove all code related to the obsolete rotate device prompt overlay, including its DOM element, JS logic, and CSS styles.
    Add touch-action: manipulation to the body to disable native double-tap zoom on app-like UI chrome.
    Rework AR export tinting to always apply per-part lightness offsets instead of conditionally, and update offset values for better contrast in AR viewers.
    Adjust mobile sheet layouts, responsive breakpoints, and touch device camera positioning for improved portrait/landscape support.
    Clean up unused CSS and JS code from the codebase.
2026-08-07 fix(mobile-sheet): reset scroll and refine styles
    add scroll-to-top reset for mobile sheet list when state changes to fix rendering bugs from retained scroll offsets
    simplify outdated CSS comments for mobile sheet part rows
    tweak engrave button styling for compact mobile layout, removing excess shadow and adjusting sizing
2026-08-07 feat(engrave): add mobile bottom sheet for touch devices
    relocate existing engraving controls and status container into the new bottom sheet using real DOM elements instead of copies, avoiding duplicated UI code. add touch-friendly click and swipe toggle controls, fix mobile preset and control button positioning, update shared mobile sheet state handling to keep active parts visible when collapsing, and replace the old broken full-width mobile layout.
2026-08-10 feat: add ray-traced contact shadows for AR exports
    Add three-mesh-bvh CDN dependency for BVH raycasting operations
    Fix various CSS layout issues (min-width, overflow-x) across app and engrave styles
    Pause main render loop during AR export to avoid CPU contention and tab crashes
    Adjust glTF export scale timing to run after shadow bake for correct unit conversion
    Add error handling for shadow baking to fall back to standard export on failure
2026-08-10 fix(contact-shadows): use per-triangle AO baking
    Switch contact shadow baking from per-vertex sampling to per-triangle flat shading for more accurate hard-surface results. Convert indexed geometries to non-indexed to enable flat per-triangle shading, fix degenerate triangle handling to prevent crashes, adjust ray origin to the triangle centroid, update UI yield interval to use triangle counts, and remove the problematic vertex budget system.
2026-08-10 fix(bakeContactShadows): use material buckets
    Fix compatibility with iOS USDZ exports by replacing vertex color-based AO shading with per-triangle hit count buckets. Add handling for normal and UV attributes to preserve mesh data, safely skip zero-length face normals to avoid crashes, replace the original mesh with bucketed meshes grouped by AO level, and update all relevant comments to explain the new approach and requirements for native AR viewers.
2026-08-10 fix(contact-shadows): exclude self-occlusion and improve shadow accuracy
    Add per-mesh bounding box and triangle range tracking to enable fast pre-filtering of triangles that can't have cross-part occlusion, and exclude self-mesh ray hits to fix mounting hole artifacts. Replace the unstable axis-pick tangent basis with a branchless ONB implementation from Duff et al. 2017 to avoid normal discontinuities across neighboring triangles. Switch to fixed AO level bucketing to reduce mesh build overhead and smooth jagged seam artifacts.
2026-08-10 fix: resolve stale model loads and stuck AR render loop
    Add load generation tracking to ignore stale model load responses when switching part variants quickly. Fix the AR preview error handler that left renderingPaused true, preventing future UI redraws. Adjust skeleton visibility and initial load settlement timing for smoother flow.
2026-08-10 fix(bakeContactShadows): fix shadow mesh orphaning
    Use world-space transforms for contact shadow bucket meshes and add them directly to the export root instead of the original mesh's parent. This fixes cases where nested mesh shadow geometry was silently dropped from exports when their parent mesh was processed first. Also remove redundant transform copying as world-space coordinates are already baked into the bucket geometry.
2026-08-11 fix: temporarily hide slicer picker and use OrcaSlicer
    PrusaSlicer's custom URL protocol only accepts URLs from a reviewed allowlist that excludes hprobots.com, so direct print links to our hosted files are rejected. Temporarily hide the slicer group UI, hardcode all print buttons to use OrcaSlicer's orcaslicer:// handler, update README with setup details, and remove unused code.
2026-08-17 fix coordinates and added new parts
    [Bottom_F1.step, FaceUSOLED.step, FaceUSOLED_v4.stl, FaceUSflat_v3.step, HP_Batterycovermesh_R2.stl, HP_Hat_SantaBall_R1.stl, HP_Hat_Santa_R1.stl, Hat_Flat.stl]
2026-08-17 feat(downloads): swap default download to STL and add full STL support
    Update all UI download buttons, labels, and menus to use STL as the primary format. Add STL asset set generation and remote URL handling, implement client-side STL export fallback using Three.js STLExporter for variants without hosted STL files. Add compatibility check to hide motion parts when F1 bottom is selected, and adjust print/download handlers, tour text, and helper functions to match the new workflow.
2026-08-17 new parts from printables
    [4-wheeler-rims.stl, 4-wheeler-tires.stl, 8point_hat_otto.stl, Backpack - Wrap-Around.stl, Cargo compartment grille.stl, Face10.stl, Face11.stl, Goggles.stl]
2026-08-17 style: fix mobile popovers, refresh branding, polish UI
    Add reusable floating popup utilities to fix mobile clipping by reparenting menus to the document body
    Update all brand colors to match hprobots.com's official yellow branding system
    Replace text app loader with HP Robots logo and add multi-size favicons
    Add dice roll animation to randomize button with reduced-motion support
    Add color-coded dots to preset menu options for better scannability
    Refactor info tooltip and more menu logic to use the new popup utilities
2026-08-18 fix(preset-menu): resolve alignment and responsive layout issues
    adjust brand mark padding and logo height
    switch preset menu to row flex layout for better alignment
    anchor dropdown to toggle's right edge instead of logo
    add responsive rules to hide brand mark on >480px screens, restore on mobile
2026-08-18 chore: remove send-to-slicer integration
    Implement security hardening and cleanup:
    - Add Subresource Integrity hashes for all CDN scripts and import maps
    - Add clickjacking protection headers via .htaccess
    - Add terms and conditions consent popup for STL downloads
    - Fix path traversal vulnerability in part entry fallback logic
    - Delete all slicer protocol handler scripts, UI elements, and setup documentation
    - Update README to reflect removed slicer integration
2026-08-19 fix: add max-width guards to touch device media queries and js checks
    this change prevents touch-specific ui styles and logic from applying to touchscreen 2-in-1 laptops such as hp omnibook x flip, surface, and spectre x360, which incorrectly report pointer:coarse at full desktop width. their coarse pointer detection only reflects the presence of a touch digitizer, not actual device form factor. we've added max-width:1024px constraints to all (pointer: coarse) media queries across css files, updated all javascript matchmedia checks to include the same guard, and revised all related comments to explain this reasoning.
2026-08-24 new models, fixed naming
    [Bottom_Base.stl, Bottom_Boat.stl, Bottom_Drift.stl, Bottom_Duck.stl, Bottom_Duck.stp, Bottom_Honeycomb.stl, Bottom_Lego.3mf, Bottom_Truck.stl]
2026-08-25 top hats
    [3dtakotuesday.baseballcap.combined.mm.stl, 3dtakotuesday.constructionhat.mm.stl, Bottom_multi.3mf, FaceUSflatsimple_v3.stl, Lego like Cap V3.3mf, Middle_short_v1.stl, Top_Duck.stl, Top_Hats.stl]
2026-08-25 feat: add part compatibility checker and integrate app
    Add the full `tools/compat-checker` tool suite (HTML, CSS, and JS) for screening all cross-category part pairs for geometric overlap, using three-mesh-bvh accelerated voxel-sampled volume overlap estimation. Update `scripts/app.js` to load saved compatibility decisions from `assets/compatibility.json` and enforce hidden incompatible part combinations, alongside the existing hand-coded exclusion rules for Arms/Bumper and F1-bottom/Motion. Document the new tool's usage, setup, and features in the README.md.
2026-08-25 feat: replace auto-hide with warning badges
    This commit overhauls the part compatibility checking system:
    - add conflict indicator badges to part labels and red translucent highlight/preview overlays for clashing parts
    - replace the previous auto-hiding geometry conflict enforcement with non-intrusive warnings that let users decide how to handle clashes
    - update the compat-checker tool to skip hand-coded structural rule pairs (arms/bumper, hat/top) to avoid redundant checks
    - add enforceHatRequiresTopHats to auto-switch the top variant to Top_Hats.glb when a hat is equipped, instead of hiding parts
    - preserve existing hand-coded physical exclusion rules (Arms/Bumper, F1-bottom/Motion) that s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
2026-08-26 feat: overhaul desktop UI with docked panels and hover controls
    Add floating model hover popup for desktop part interactions with prev/next, print, and download actions. Replace legacy standalone control panels with a tabbed right dock featuring Mixes and Parts views. Add left tools column with global paint picker and collapsible part color sidebar. Update global styles with dot grid background and reposition brand mark to a bottom-right watermark on desktop. Adjust touch device layout to preserve existing mobile functionality, remove old part map canvas and outdated panel positioning code, and clean up temporary test files.
2026-08-26 feat: add V-key visibility mode and ortho cam toggle
    - Add press-V visibility edit mode: click parts to toggle visibility, with blue ghosted previews, persistent help banner and screen-edge vignette
    - Add orthographic/perspective camera toggle button with toast confirmation on switch
    - Update UI buttons to show keyboard shortcuts, extend guided tour for new tools
    - Ensure paint and visibility edit modes are mutually exclusive to avoid conflicts
2026-08-28 feat: improve randomizer, conflict handling, and UI
    - add global user-select:none (excluding inputs) to prevent unintended text selection during drags
    - set default camera projection to orthographic
    - standardize part color handling with a shared DEFAULT_PART_COLOR constant
    - add boat bottom compatibility conflict with wheels motion
    - limit toast notifications to 3 stacked items to avoid screen clutter
    - rework randomize function with greedy + repair passes for compatible part variants
    - update gitignore to exclude local files and tooling artifacts
    - refactor utility functions for conflict checks and toast handling
2026-08-28 feat: add PrusaSlicer support gated by feature flag
    Add full PrusaSlicer integration alongside existing OrcaSlicer support, gated behind the PRUSA_SLICER_LIVE flag in scripts/slicer-preference.js (defaults to false).
    Replace the old standalone slicer menu with a new settings modal, adding controls for preferred slicer, camera projection, default download format, and the guided tour. PrusaSlicer appears as a disabled "coming soon" option until the flag is enabled, preserving original OrcaSlicer-only behavior until then.
    Flip PRUSA_SLICER_LIVE to true once the official PrusaSlicer release with the hprobots.com allowlist update ships to enable full PrusaSlicer support. Update the README to do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
2026-08-28 models with multiple parts
    [Bottom_F1.step, Face_Mustache.step, Face_Pika.step, Hat_Bavarian.step, Hat_Bavarian.stl, Hat_BavarianBand.stl, Hat_BavarianFeather.stl, Hat_Construction.stl]
2026-08-28 fix: resolve camera clipping and ghost preview issues
    add a minimum camera distance to orbitcontrols to prevent zooming too close to the model, which caused the camera near plane to slice through geometry. disable depthtest for ghost part materials and their edge lines to stop foreground opaque geometry from clipping hidden previews.
2026-08-28 fix: improve ghost rendering and reduce lag
    Add depthWrite: false to the ground shadow material to prevent the large plane from slicing through ghost previews.
    Remove the eager scheduleGhostEdgesPreload call, switching to lazy edge geometry computation only when a part is ghosted, to eliminate main thread blocking from large multi-mesh GLB models.
    Adjust ghost material depthTest settings: keep depthTest enabled for edge lines, disable only for the fill material to avoid hard silhouette clipping.
2026-08-28 feat(mix presets, tooling): add mix colorizer tool and per-mix thumbnail color support
    Add standalone Mix Colorizer authoring tool for customizing thumbnail colors for ready-made mixes. Extract shared preset definitions to scripts/presets.js, shared between the main app and the colorizer tool, using filenames instead of fragile numeric indices to avoid broken presets after asset reordering. Update the main app to load mix colors from assets/mix-colors.json and tint preset thumbnails with authored colors instead of raw asset colors. Refresh preset labels and descriptions, add two new presets (Thunder Mouse and Viking Boat), and document the new tool in README.md. Add initial sample color data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
2026-08-28 perf(viewer): optimize interactive 3D rendering performance
    Add three-mesh-bvh accelerated raycasting to fix frame drops during hover and paint interactions with complex 3D models. Additional optimizations:
    - cap device pixel ratio at 2 to reduce fill-rate overhead
    - reduce shadow map size from 2048 to 1024 to lower shadow pass cost
    - skip expensive hover raycasts during camera drag operations
    - properly dispose BVH acceleration structures when unloading models
2026-08-31 fix naming and placement
    [Bottom_Bricks.3mf, Bottom_Pika.step, Bottom_Pika.stl, Bottom_Race.step, Bumper_Race.step, Bumper_Race.stl, Bumper_Roller.3mf, Face_Gladiator.stl]
2026-08-31 feat(touch): add complete touch support and polish interactions
    This commit adds full touch device support, expanding beyond small phones to include landscape tablets that retain the desktop layout. Changes include early touch capability detection in index.html with dynamic updates for convertible 2-in-1 devices, touch-specific UI replacements like hiding keyboard shortcuts and adding touch exit instructions, reworked paint bucket interactions for tap/long-press inputs, plus touch-only popup controls and updated share functionality to use native device share sheets for all touch-capable devices.
2026-08-31 fix(ui/ux): adjust tap tolerance and touch input detection
    increase tap move tolerance from 10px to 16px for more forgiving touch interactions
    refine touch input detection to target only desktop-layout touch devices
    remove legacy global touch-capable CSS styling rules
2026-08-31 fix(touch-ui): hide print UI and fix layout for touch devices
    hide print-related elements and preferred slicer settings on touch-capable devices, as desktop slicer integration is not useful here. adjust left and right dock columns to prevent content from being clipped off the bottom of touch viewports, and add scrolling to the left tools panel
2026-08-31 fix(tablet): spacer offset from mixes, faster first load, sturdier touch detection
    Spacer positioning:
    - The -16 Y drop for spacer-affected parts (bottom/wheels/arms/bumper) was
    only applied inside loadModel's callback, so switching between two mixes
    that share a variant (one with a Spacer, one without) never repositioned
    the already-loaded part and it stayed at the wrong height.
    - Single source of truth (SPACER_DROP / SPACER_AFFECTED_PARTS) with
    spacerYOffset() and a new refreshSpacerOffsets() that re-derives position.y
    on the loaded affected parts in place. Called from applyPreset after its
    loads and from every manual Spacer toggle (replacing the wasteful
    bottom+wheels reload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
2026-08-31 feat(mobile): add tabbed mobile bottom sheet
    Reparent the preset carousel to the Mixes tab and controls toggle to the Parts tab. Add tab switching logic with proper ARIA accessibility attributes, adjust touch-device hover popup positioning to dock above the sheet, remove the legacy preset toggle media query since it's no longer needed, and sync the sheet's active tab to match user interactions: part edits switch to the Parts tab, while applying presets switches to the Mixes tab.
2026-08-31 feat(mobile): tabbed Mixes/Parts sheet, global paint & hide-show on top, orientation lock per device
    Mobile bottom sheet is now the phone counterpart of the desktop right-dock:
    - Tab bar (Mixes / Parts). Mixes is the default and follows the last
    interaction — pick a mix -> Mixes, change a part -> Parts (scrolled to it).
    - Mixes tab: the desktop dock's own #preset-carousel, reparented in and
    re-laid-out as a horizontal card strip (peek) / 3-col gallery (expanded).
    Cards flush-left, gentle proximity snap.
    - Parts tab: every part, always — the Essential/Advanced split and its
    floating pill are gone on phones.
    - The top-left mix dropdown (#preset-menu) is hidden; that strip is free n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
2026-08-31 perf(load): defer preset thumbnails past first paint; fix mobile mode-button active colour
    The 8 preset-mix thumbnails (each loads ~6 GLBs + an offscreen WebGL render)
    were kicked off as soon as the Mixes carousel built — on first paint in the
    desktop layout, which tablets use in landscape. That contention with the
    initial model load is what kept the loading screen up for a long time on
    tablets specifically (desktop absorbs it; phone starts collapsed).
    - renderPresetCarousel now shows cards immediately with placeholder thumbs and
    registers the actual thumbnail renders via runAfterFirstBuild(); they run
    once hideAppLoader() fires (or the 12s splash timeout), staggered one per
    idle sl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
2026-08-31 feat(combo-chip): add accurate build count and improve paint UX
    replace naive product-based combo count with accurate constraint-aware calculation that respects part compatibility rules and structural constraints
    add automatic global paint mode activation when selecting the global paint tool's color
    add escape key support to exit all bucket paint modes
    fix variable hoisting issues to avoid temporal dead zone errors during module bootstrap
    clear combo count cache when compatibility map loads and update combo chip accordingly
2026-08-31 fix colors and mixes
    [Bottom_Boat.3mf, Bottom_Boat_Cargogrill.stl, Bottom_Boat_drive wheel.stl, Bottom_Race.step, Bottomtemplate.step]
2026-09-01 feat(compat-tool, app): add spacer-aware compat checks and preset color copying
    Add full support for spacer-enabled builds in compatibility validation:
    - Track separate compatibility verdicts for regular and spacer-augmented pairs
    - Update all build checking logic to use the correct map based on current spacer visibility
    - Add cache key differentiation for spacer vs non-spacer builds
    Implement a "Copy colors" button on active preset cards to apply saved mix colors from assets/mix-colors.json to the current loaded model.
    Add new color presets (bricks, santa, fast, duck, race) to assets/mix-colors.json, and fix existing sensor and boat color definitions.
    Update the compat checker tool:
    - Ad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
2026-09-02 feat: add mix-only showcase mixes and tooling
    Add full support for standalone mix-only custom geometry models that don't fit standard part slots:
    - Add mixonly asset category and update the main asset manifest
    - Add 13+ new mix-only 3D models, placement metadata, and documentation
    - Add three new showcase presets: Retro Console, Gaming Console, Modular Cube
    - Add per-mix Python code panel with copy functionality for custom firmware
    - Update compat checker to skip mix-only assets (no pairwise compatibility needed)
    - Add showcase mode UI and styling that locks part controls for pure showcase builds
    - Update core app logic for mix extras loading, coloring, and exporting
    [Top_lightsdiffuser_cube.step, bottom_extend_pcb_r1 (1).stl, bottom_jig1x1 (2).stl, cube-frame.stl, top_matrix_double-butttons_v2.stl, top_oled_v3 (2).stl, top_pcb_v1.stl]
2026-09-22 new models
    [Hat_Pika.stl, Top lightshat_v3.stl, black.stl, keychain_ottobot_R2.stl, keychain_ottoface_R2.stl, wheelstarter_f1new.stl, white middle.stl, white top.stl]
2026-10-20 feat(print): send parts to PrusaSlicer and EasyPrint via Prusa upload
    Per-part Print uploads the part's STL to Prusa's anonymous import
    endpoint (slicer.printables.com/import) and hands off to the returned
    EasyPrint page or prusaslicer:// link. The file is then hosted on
    Prusa's own domain, so PrusaSlicer no longer waits on hprobots.com
    being added to its download allowlist; PRUSA_SLICER_LIVE is removed.
    - Preferred Slicer gains EasyPrint; PrusaSlicer is the default
    - Upload dialog with progress, cancel and a fallback link when the
    browser blocks the new tab or protocol launch
    - Returned URLs are validated to point at Prusa before following
    - Uploads reused for 25 min (Prusa links expire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
2026-10-20 feat(print): print whole build as one 3MF; export STLs upright
    "Print whole build" (toolbar) builds a 3MF in the browser with one
    named object per visible part plus the active mix's extras, welded,
    turned Z-up, grounded and laid out side by side on the bed. It goes
    through the same Prusa upload, so it works for PrusaSlicer, EasyPrint
    and OrcaSlicer (via Prusa's temporary file URL).
    - Manifest `print: false` marks non-printable mix pieces (PCBs, OLED,
    encoders); they are left out of the build file
    - Scene STL exports are rotated Y-up -> Z-up so parts land upright in
    a slicer instead of on their back
    - firstExistingUrl() skips 0-byte hosted files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
2026-10-20 feat(print): EasyPrint on phones and tablets
    Print was hidden on every touch device. Phones and tablets now print
    with EasyPrint (web slicer, works in mobile browsers):
    - Part rows show the EasyPrint button; the "..." menu gains
    "Print build with EasyPrint" for the whole build
    - After upload the dialog asks for a tap on "Continue to EasyPrint"
    instead of window.open, which mobile browsers block after an async
    upload; a tapped link can also be routed to an installed app
    - Desktop vs. mobile is decided by platform (canOpenDesktopSlicer),
    so touch laptops keep PrusaSlicer/OrcaSlicer and their print buttons
    - Toasts say "ready for" since the handoff may still need a tap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
2026-10-20 feat(print): split combined models into separate print bodies
    Many models combine several separately printed bodies in one file
    because that is how they look assembled (both wheels, arm pairs, a top
    and its diffuser, hat brims...; 30 of 107 models). Everything leaving
    the app for printing now goes through one print layout step:
    - split the part (hosted STL, else viewer mesh) into connected bodies
    - drop same-facing duplicate triangles (Truck STLs carry their surface
    2-4x) and make each body's winding consistent
    - keep small inside-out shells inside a body as cavities, flip other
    inside-out bodies, attach open fragments to what they touch
    - lay bodies standing on an edge flat on their fl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
2026-10-20 feat(print): send customizer colours to slicers as filament slots
    Every 3MF sent to PrusaSlicer, EasyPrint or OrcaSlicer now carries the
    build's colours:
    - each colour becomes a filament slot, most-used first; each body's
    main colour sets its object filament, other colours on the same body
    are painted per triangle (per-mesh paint survives)
    - PrusaSlicer/EasyPrint format: Slic3r_PE_model.config extruder +
    slic3rpe:mmu_segmentation (verified by slicing with PrusaSlicer 2.9.2
    CLI: slots 1-5, per-triangle paint, single-filament fallback)
    - Bambu/OrcaSlicer format alongside: model_settings.config, paint_color,
    filament_colour in project_settings.config (harmless to PrusaSlicer)
    - objec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
2026-10-26 feat(ui): coding-app style top bar, "more" pop-out and app theme
    Restyles the customizer after the HP Robots coding app (app.hprobots.com,
    HP_Robots_App_Tool_UI_Guide.md):
    - Top bar replaces the bottom toolbar: home (My builds), save and the
    build's name on the left; randomize, share, AR, print, download and a
    "more" button on the right. Save writes straight into the loaded
    build (a dot marks unsaved changes) or asks for a name first.
    - "More" pops out a column of round buttons - New build (blue primary),
    Fullscreen, Settings - with label pills (on hover; always on touch)
    and a light backdrop that closes it. On phones and narrow windows the
    bar's secondary actions fold into it.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
2026-10-27 chore: tidy repo, rewrite README, compress models losslessly
    - Remove stale files: an editor temp file, an empty test script, an
    unreferenced duplicate knob-encoder GLB, empty (failed-write) STLs and
    placement sidecars, and the one-off WordPress asset fetch script + its
    manifest. Stop tracking backup/original.php (already gitignored).
    - Rewrite the README as a short overview of what the app does.
    - .htaccess: gzip GLB/STEP/JSON/SVG/code on the fly (lossless). STLs are
    left uncompressed because firstExistingUrl() reads their size.
2026-10-27 feat(ui): undo / redo
    Every edit already ends in saveStateToLocal(); it now also schedules a
    history commit that settles after 400 ms, so a colour-picker drag or a
    burst of clicks is one step. Undo/redo put the previous snapshot back
    through applyBuildState() (the saved-build path), keeping paint mode on.
    50 steps. Buttons next to Save in the top bar (in the "⋮" menu on
    phones), Ctrl/Cmd+Z, Ctrl/Cmd+Shift+Z and Ctrl+Y.
2026-10-27 perf(viewer): render on demand; lighter rendering on phones
    animate() used to draw every frame, shadow pass included, even with
    nothing moving. It now draws only when something may have changed:
    camera moves (OrbitControls 'change', incl. damping and tweenView),
    variant pops / ghost fades, ~600 ms after any user input, model loads,
    scene add/remove and canvas resizes, plus a 1 s heartbeat as a safety
    net. The key light never moves, so the shadow map is only redrawn when
    parts change, not while orbiting.
    Measured headless: idle drops to the 1 fps heartbeat (was every frame).
    Touch devices cap the pixel ratio at 1.5 instead of 2.
2026-10-27 feat(viewer): exploded view
    A button next to zoom/recenter (and E, or the "⋮" menu on phones) eases
    the visible parts apart from the robot's centre in proportion to where
    each already sits: top and hat rise, bottom and wheels drop, face and
    bumper slide forward. Mix extras and clash overlays move too.
    Parts are only moved while a frame is drawn or a click is hit-tested,
    then put back, so exports, printing, thumbnails, AR and saved builds
    always see the assembled robot. Hover, paint and click-to-browse keep
    working on the exploded parts.
2026-10-27 fix(mobile): frame the robot in the free area; stop sheet clipping
    - Camera view offset centres the robot between the top bar/tool pills
    and the bottom sheet (it used to sit left of centre and partly behind
    them), shrinking it to stay visible while the sheet is expanded. Until
    the user moves the camera, the robot is re-fitted after parts load, so
    tall mixes fit too. Taps hit-test through the same projection.
    - Collapsed sheet: 220px so a mix card isn't clipped; Top's Engrave
    button only shows when expanded; the next part row fades out.
    - Part rows: round colour swatch instead of a thin bar that looked like
    an empty field.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
2026-10-27 fix(mobile): inset the bottom sheet from the screen sides
    Edge to edge it looked unbalanced against the gap below it; it now uses
    the same side margin as the top bar's buttons.
2026-10-27 fix(desktop): keep Part colors / Hide-show visible on short screens
    On short viewports (laptops at 125-150% scaling, ~560-700px tall) the
    paint panel filled the left column and pushed both buttons below its
    max-height, where overflow:hidden cut them off. In the desktop column
    the paint panel now shrinks and scrolls inside itself while the buttons
    always show; below 760px tall it's also more compact (shorter colour
    field, hint text left to the button's tooltip).
2026-10-27 feat(print): name EasyPrint/slicer uploads after the build or part
    Uploads always showed up as "HP Robots Customizer". The whole build now
    goes as the saved build's name (else "HP Robot – <mix>", else
    "HP Robot"), a single part as "<Part> – <variant>" (e.g. "Hat – Viking").
    The same name is the 3MF title and file name. The upload cache key
    includes the name, so renaming a build re-uploads under the new name.
2026-10-27 fix: product name is "HP Robots", not "HP Robot"
    Unsaved-build print names, 3MF default title, page titles, the share
    sheet title and the README.
2026-10-27 feat(engrave): refresh the engraving tool to match the customizer
    - Same chrome as the customizer: top bar (round back button, title, part
    chip, blue Download button), right dock card, bottom-left zoom/recenter
    controls, status pill bottom centre, inset phone sheet.
    - Steps are numbered cards; shapes in a 5-column grid; Move/Rotate/
    Center/Handles as a labelled segmented control; restyled sliders, value
    chips, collapsible "Exact position & depth", consent and progress cards.
    - The part is centred in the free area (left of the dock, above the
    sheet) and shrinks to stay visible when the phone sheet expands.
    - Fix: opening engrave.html directly crashed because its default model
    poin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
2026-10-27 fix(engrave): undistorted, centred 3D view
    - Orthographic camera like the customizer's default; the 75° perspective
    camera stretched the part like a wide-angle lens. Zoom buttons and the
    mouse wheel now zoom instead of dollying.
    - Frame on the triangles actually drawn: the top's GLB carries stray
    unused vertices that made its bounding box twice as tall as the part,
    so the "centred" view put the part up and to the left.
    - Hide the ground shadow, which read as a grey square floating under the
    part.
